Alternating/esp32-LED-sign/Progress.md

# Progress — LED Sign 10-Board Mesh

Tracking file per project rules. Newest log entries at top.

## Status
- **Phase:** Phase 1 + Phase 4 complete; all 10 boards on `c884749` (buildId `ce1fbe40`) = **release v0.4.0**, Rainbow Bands + Flow live. Docs: feature tour, hardware assembly guide, video. Backlog (not started): 11–20 boards, order/swap from phone, D2/D3 minor OTA items, `clients` over-count, optional BLE.
- **Active agent:** Orchestrator (Claude session 2026-11-08); research + planning agents on Standby
- **Blocker cleared:** `character_patterns.h` extended to 68 glyphs; ready for Phase 0.

## Log
- 2026-11-09 — **First release published: [v0.4.0](https://github.com/Alternating/esp32-LED-sign/releases/tag/v0.4.0)** (owner chose to keep 0.4.0 = the build already on all 10 boards, no reflash). Tag at `f8445db` (firmware/web identical to build `c884749`; later commits docs/tools only). Assets: HUB/NODE install, OTA image, SHA256SUMS, INSTALL.txt, zip — checksums identical to the deployed build and re-verified after download from GitHub. New `tools/release_pack.sh` (dry run by default; refuses on checksum, version/build-id, dirty build, firmware drift since build, unpushed HEAD, existing tag); notes in `docs/releases/v0.4.0.md`; release steps in `docs/HOWTO_build_pipeline.md`. Note: the cloud session cannot delete remote refs (proxy 403) — tag/branch deletes and releases go through the box (`gh`, ssh).
- 2026-11-09 — **Owner answers applied to hardware docs:** one **10 m** reel per board (400 LEDs = 6.7 m); STL v4 confirmed correct; the 4-button board is **no longer used** (removed from parts/wiring; README hub/flip steps now button-free — role via install image, Flip via phone); LOLIN32 is powered through its **JST battery connector** from the 5 V rail (polarity check + keep XL4015 at 5.0 V noted). New `docs/HOWTO_build_a_board.md` one-page checklist (build → flash → add to sign, incl. replacing a dead board: Forget first, since the hub assigns the lowest free position and a full table assigns none).
- 2026-11-09 — **Docs cleanup (owner request):** (1) Removed the scratch `phone-shots` branch from GitHub — it held the phone lock-screen shot (`home.jpg`) and test shots; `tools/phone_shot.sh` now keeps only the latest shot and documents how to delete the branch. None of those shots were on `main`. (2) Replaced the stale README "Next step" (Phase 0 / font tasks done long ago) with "Status and roadmap". (3) Ported the hardware build from `Alternating/8board-esp32-ledproject` into `docs/HARDWARE_ASSEMBLY.md`, adapted to one LOLIN32 + battery per board (GPIO 4 via 470 Ω, 10 000 µF, K1–K4 on 17/16/18/19), with 6 build photos in `docs/images/hardware/` and the Fusion source `hardware/battery_hanger_-_led_sign_v3.f3d` (v4 STL is byte-identical to the one already here). `HARDWARE_README_v3.md` marked legacy. (4) Font sheet and the two firmware screenshots now display properly in FEATURES. **Drift:** README "Next step" was never updated as phases closed — **framework fix:** every phase/feature close-out updates README "Status and roadmap" in the same commit as Progress.md.
- 2026-11-09 — **New feature: Rainbow Flow** (owner request) — the bands move, as one continuous pattern across the whole sign: Down, Up, Right (board 1→10), Left, Diagonal. Sign-wide x = (pos−1)·20 + col, phase from the hub clock; one pixel step every speed/5 ms (500 ms → full colour cycle in 2 s). `flow {"dir":…}` command, Show flags bits 4–6, SignState v5 (+flow; v3/v4 migrate, owner's Bands setting survived). Look tab: Flow row appears under the swatches when Bands is selected. Shipped `c884749` via phone upload (12.8 s) + UI Update all (9/9). Enabled Right from the phone: hub cfg bands=true flow=right. Owner confirmed static bands look good.
- 2026-11-09 — **New feature: rainbow bands inside the letters** (owner request; static, bands-in-glyphs chosen over full flag). Glyph pixels coloured by row red/orange/yellow/green/blue/purple; identical rows on every board so stripes run across 1–10. `color {"bands":true}`, `FLAG_BANDS` (0x08) in the Show header (frame unchanged), SignState v4 (bands in tail padding, v3→v4 migration), brightness cap 80 %, blink/fade still apply, exclusive with rainbow cycle. Look-tab swatch (striped). Shipped `b03240f` via phone upload (12.2 s) + UI "Update all boards" (9/9, 3 m 11 s); enabled from the phone: hub reports bands=true, briEff 80. Awaiting owner's visual confirmation. Cosmetic: colour bar under swatches keeps the last solid colour.
- 2026-11-09 — **First update done entirely the owner's way (phone):** board cards now show the symbol glyph (`char: ☺`, `5141255`). Phone upload 12.8 s → hub `eb9ca3f2` confirmed → **Update all boards tapped in the phone UI** → 9/9 nodes done in 3 m 9 s (19–26 s each), live progress table verified on screen. All 10 boards on `5141255` / `eb9ca3f2`.
- 2026-11-09 — **First phone-driven UI check via ADB (OnePlus, Chrome):** Message tab shows `{happy}`×10 as "10 / 10 boards", preview one group of 10 ☺; Boards tab lists all 10 online with fw `9834d06f`, HUB badge on pos 1, Identify/Flip per card; Settings → Firmware table shows pos 2–10 all up-to-date; `clients 1` with one phone (correct). Screenshots on branch `phone-shots` (home/ui1/boards/settings). Board-card glyph fixed in `5141255`.
- 2026-11-09 — **Android test rig online:** OnePlus 7 Pro (GM1917, Android 12) on the Qwen box via ADB (udev rule for vendor 22d9; phone joins `LEDSIGN-HUB` with `adb shell cmd wifi connect-network`). Screenshots: `tools/phone_shot.sh <name>` → `phone-shots` branch (force-pushed, never on main). Needs: phone unlocked once, Developer options → Stay awake + Disable permission monitoring (OnePlus) for taps/settings.
- 2026-11-09 — **D4 CLOSED — not a sign defect.** From the phone (72 Mbit/s link, −22 dBm): 1400 B pings 15 ms avg (box: 0.7–9.7 s), 300 kB sink POST 374 kB/s (box: 3.5 kB/s), real firmware upload 1.14 MB in **12.7 s** → hub rebooted to app1 and marked valid; `ota_nodes` skipped all 9 (up to date). Root cause was the box's ath10k card (rate control stuck at 1 Mbit/s TX, power-save on). Box-side uploads should go through the phone, or the box card needs fixing before using `ota_rollout.sh`.
- 2026-11-09 — **First full 10-board OTA rollout: 9/9 nodes updated in 3 min (19–24 s each), zero failures**; all 10 boards on `3a47849` (buildId `9834d06f`).
- 2026-11-09 — Owner defect: 10 × `{happy}` cut off at the 9th face. Cause: the 60-char limit counted raw bytes (`{happy}` = 7), and truncation split the 9th token into literal "HAP". Fix (`504aa3e`, `9a8f920`): limit is **60 display units** (a symbol = 1), raw text up to 200 B, `signClip()` never splits a token, SignState blob v3 with v2→v3 migration, serial JSON line 512 B. Host test `tools/seq_test/clip_test.cpp`. Verified on hardware: 10 faces = 10 units, one group, every board renders char 13.
- 2026-11-09 — Defect found during deploy: after a hub **reinstall** (table wiped) running nodes never re-HELLO, so they were invisible (no cards, no OTA). Fix `3a47849`: hub **adopts** a node from its heartbeat's saved position when that position is free. Verified: all 9 re-registered at their own positions within seconds of the hub install.
- 2026-11-09 — **Open D4 (hub upload over Wi-Fi is very slow with 10 boards):** box→hub uploads ran 2.5–6.5 kB/s (vs 85 kB/s on the 2-board bench) and the WebServer aborted them; 1400-byte pings to the hub took 0.7–9.7 s while small pings were 17 ms; hub→client downloads were fine (313 kB/s); a non-flash `/cmd` sink was equally slow, so it is the hub's receive path, not flash writes. The box's card had power-save on and fell to 1 Mbit/s TX — turning PS off helped only slightly. Workaround used: wired HUB install (the table now self-heals) + node OTA (fast direction). Next: reproduce with a phone upload (owner's real path); test with the sign idle vs sequencing; check ESP32 SoftAP RX buffers/AMPDU and the box/phone PHY rate. `tools/upload_probe.sh` captures upload + hub log.
- 2026-11-09 — Owner offered an Android phone for direct testing: feasible via ADB on the Qwen box (screenshots, taps, open the portal); pending owner setup.
- 2026-11-09 — **Phase 4 (hub-hosted OTA) VERIFIED — O1–O10 PASS after D1 fix.** min_spiffs (two 1.97 MB slots), built-in IDF rollback (`verifyRollbackLater()` override + mark-valid after 30 s healthy; one reset during the window rolls back — proven), hub serves its running image on :8080, node OTA ~24 s per board (10-board sign ≈ 4 min), mid-download power loss leaves the old firmware, truncated upload rejected, ESP-NOW status 36/36 while associated. D1 (hub forgot unicast peers after reboot → "Update all" failed right after a hub OTA) fixed in `e84e72b` and **deployed via OTA**: update-all ran immediately after the hub update, node done in 22 s. New `tools/ota_rollout.sh`. Reports `PHASE4_REVIEW.md`, `PHASE4_VERIFICATION.md`. Battery telemetry dropped from UI (owner decision). Remaining owner action: one wired install of the other 8 boards with `LED_Sign_NODE_install.bin` from `release/e84e72b/` (or newer), then OTA forever.
- 2026-11-08 — **10-board run succeeded** (owner photo: `GO ☺ TEAM ☺ GO` across 10 signs). One board (pos 5, MAC 78:E3:6D:19:09:B0) had its data line entering from the opposite side → mirrored "E". Fixed via the per-board mirror flag (serial `m`), then shipped the no-cable fix: `mirror` command + **Flip** button per board card, `SETMIRROR` unicast with ACK, K1-held-at-power-on gesture (`120f6ca`). Verified on hardware: hub→board 5 flip/unflip round-trip, saved in node NVS, `/state` carries `mirror` per board.
- 2026-11-08 — **Incident:** an unattended `flash_board.sh … update` on the hub ran while the owner was unplugging boards; esptool aborted mid-write and erased the hub's app partition (boot loop: `OTA app partition slot 0 is not bootable`). Bootloader + NVS were intact; recovered by flashing `LED_Sign_update_app.bin` at 0x10000 — role, 10-board table and message all survived. **Framework fix:** never start a flash without confirming the port exists *and* the owner knows the board must stay connected; `flash_board.sh` now refuses a missing port, picks the newest release by mtime (an alphabetical sort had chosen an older build), and fails loudly when the write isn't verified.
- 2026-11-08 — Release `release/120f6ca/` built (HUB/NODE install + update_app). Hub and board 5 are on it; the other 8 boards run `3eeb7ae`/`ccdc078`-era firmware (node behaviour identical) and can take `LED_Sign_update_app.bin` at 0x10000 at any time to gain the remote Flip.
- 2026-11-08 — Owner: hub must be clearly identifiable. Added labeled images via `tools/make_images.sh`: `LED_Sign_HUB_install.bin` / `LED_Sign_NODE_install.bin` (full images differing only in a pre-seeded NVS `sys/role`) + `LED_Sign_update_app.bin` (app-only, keeps settings). NODE image verified on hardware: boots `Role in NVS: NODE`, re-registers as pos 2. `flash_board.sh` now takes `hub|node|update`. README section "Which board is the hub?" + image table. Box can now push to GitHub (owner fixed auth). 10-board run done 2026-11-08.
- 2026-11-08 — **Phase 1 step 2 VERIFIED (C1–C13 PASS after D1 fix).** Word sequencer: legacy `parseMessageIntoWords` ported with chunking (23/23 host unit tests, `tools/seq_test`), synchronized word changes (300 ms lead, hub↔node switch skew 7.7 ms mean), SignState v1→v2 migration preserved owner settings, UI word-speed slider + live group preview (deterministic token glyphs). D1: period measured as period+lead (1312 ms) → fixed in `765c182`: 1000.0 ms σ 8, 500.1 ms σ 6.6. Build 1.08 MB. Reports: `STEP2_REVIEW.md`, `STEP2_VERIFICATION.md`.
- 2026-11-08 — Step 2 pipeline: Qwen draft 24.9k tok / 10 min (JS packer correct, C++ packer hung on brief cases, no scheduled apply) → review 32 findings → refactor (+ unit tests, hub-restart detection) → verification found one timing defect → fixed same day. **Phase 1 complete.**
- 2026-11-08 — Owner confirms captive portal auto-pops on phone join. **Step 3 fully closed.**
- 2026-11-08 — Owner phone test: two phones connect to `LEDSIGN-HUB` fine (D2 max_conn OK). Owner defect: identify flashed solid white; plan §3.3 says flash the **position digit**. Fixed (`display::identifyStart(ms,pos)`, white digit at 2 Hz on hub and nodes). Drift: the step-3 brief said "identify flash" without restating the digit requirement — briefs must quote the plan's rendering rules verbatim.
- 2026-11-08 — **Phase 1 step 3 VERIFIED (B1–B10 PASS, step-1 regression PASS).** Hub serves captive portal + web UI from PROGMEM (6.9 kB gz), JSON `/cmd` + `/state`, SignState persisted with 2 s auto-save, node-side effects (blink/fade/cycle phase-locked to hub clock), per-board telemetry. POST→node apply ≈ 76 ms; 60 s load + 5 min soak heap-flat. Defect D1 (unicast identify/forget lost 2/11) fixed in `49e4927` — 15/15 after fix. Reports: `docs/reviews/STEP3_REVIEW.md`, `STEP3_VERIFICATION.md`, UI screenshots `step3_ui_*.png`. Build 1.07 MB / 55 kB RAM.
- 2026-11-08 — Step 3 pipeline: Qwen draft 20.7k tok / 8 min (used an uninstalled async web lib, re-raised the AP on ch 1 — caught in review) → review 47 findings (19 blocking) → refactor (clean build, Playwright page test) → verification. Box facts: `wlp3s0` is the usable 2.4 GHz WLAN (`wlp4s0` is 60 GHz), no NetworkManager (wpa_supplicant+dhcpcd), the real sign's USB adapter needs `UploadSpeed=115200`.
- 2026-11-08 — **Phase 1 step 1 VERIFIED on hardware (A1–A7 all PASS).** `firmware/LED_Sign_Mesh/`: protocol, ESP-NOW radio layer (ring buffer → pump → handler, seq stamping, ACK retries, per-MAC dedupe), NVS storage, display, buttons, hub/node state machines with sticky MAC→position numbering, serial console. Evidence in `docs/reviews/STEP1_VERIFICATION.md`: node DISCOVER→pos 2 in 40 ms, SHOW_POSITION 3.0 s, LOST_HUB at 5.0 s / recovery 1.6 s, reset-order + claim cycle correct, 10-min soak Δheap 0 B both boards, 0 rx drops. Build 983 kB / 52 kB RAM.
- 2026-11-08 — Pipeline run: Qwen draft (9.6k tok, 223 s) → review agent (45 findings: 14 blocking/17 major/14 minor) → refactor agent (clean `--warnings all` build) → verification agent. Documented in `docs/HOWTO_build_pipeline.md`. Hub bench board swapped for a real sign: hub MAC now 9C:9C:1F:E3:CE:54 (node 78:E3:6D:19:18:38).
- 2026-11-08 — Phase 0 phone-on-AP gate passed: owner joined `LEDSIGN-BENCH`, loaded the hub page; 12.6 min run 3795/3791 = 0.1 % loss, RTT avg 6.2 ms (max 58 ms under phone traffic), heap stable. **Phase 0 radio gates all PASSED.** Open: flicker eyeball, 5 m range.
- 2026-11-08 — Repo pushed to GitHub (`Alternating/esp32-LED-sign`). Qwen box cloned at `~/esp32-led-sign` = primary build/flash station (two LOLIN32s on ttyUSB0/1). Windows folder `Code\esp32-LED-sign` is a clone. File shuttling retired; flow is commit/push → `git pull` on the box.
- 2026-11-08 — Local LLM (Ollama on the Qwen box) wired up as a tool via `tools/ask_local_llm.py`; 27b-q4 runs ~29 tok/s on the R9700. Usage rule in `tools/README.md`: drafts only, verify on hardware (its first answer contradicted a bench result).
- 2026-11-08 — **Phase 0 radio test PASSED** on two LOLIN32s (`firmware/bench/espnow_ping`): hub in AP_STA with SoftAP on ch 6 + ESP-NOW broadcast @ 5 Hz, node STA replying unicast. 248/248 pings, 0.0 % loss, RTT 3/6.5/25 ms, RSSI −33 dBm, heaps flat. Confirms the AP+ESP-NOW same-channel design and the core 3.3.12 ESP-NOW callback API (`wifi_tx_info_t`, `esp_now_recv_info_t`). Second board MAC 78:E3:6D:19:18:38. Remaining Phase 0 items: visual flicker check, phone-on-AP during ping, 5 m range.
- 2026-11-08 — **First hardware run.** Toolchain installed on the Qwen box (arduino-cli 1.5.1, esp32 core 3.3.12 / IDF 5.5.5, FastLED 3.10.9, ArduinoJson 7.4.3); LOLIN32 on /dev/ttyUSB0, MAC 9C:9C:1F:E3:C6:8C. `firmware/bench/font_test` compiled, flashed, verified over serial: 517 kB sketch, 296 kB free heap, `FastLED.show()` 13.7 ms/400 LEDs. New glyphs cycling on the matrix.
- 2026-11-08 — **Drift (Framework Improvement Trigger):** FastLED ≥ 3.10 on IDF 5.x has removed the RMT4 backend — `#define FASTLED_RMT5 0` is a hard `#error`. Plan §5.3's primary flicker mitigation is invalid. Replacement options: RMT5 default (test empirically in Phase 0), `FASTLED_ESP32_I2S`, or pin FastLED 3.9.x. Also: LOLIN32 FQBN has no `huge_app` partition — use `PartitionScheme=no_ota` (2.6 MB app). Fix: pin library versions at Phase 0 and verify every build flag on hardware before writing it into the plan.
- 2026-11-08 — GitHub repo `Alternating/esp32-LED-sign` created; local commits ready. Push blocked until the Claude GitHub App is granted access to the repo.
- 2026-11-08 — Font agent done. `firmware/legacy/character_patterns.h` extended 47 → 68 glyphs (adds `? ! " : & $ # + . , ' - / @ % ( ) =`, code 13 HAPPY, 14 SAD, 15 TEN). Originals byte-identical; one dead branch removed. Legacy sketches compile unchanged. Original kept as `character_patterns_v1_original.h`. Tools in `tools/fonts/`, previews + changelog in `docs/fonts/`. RAM 27.2 kB (PROGMEM deferred).
- 2026-11-08 — Owner feedback: board is **LOLIN32**; control via **Wi-Fi AP**, boards talk over **ESP-NOW**; BLE deferred (Phase 3 marked optional). Original `character_patterns.h` and `Led_standalone_lolin32.ino` added to `firmware/legacy/`. Font agent launched to audit the header and add `? ! " : & $ # +`, smiley/frown (codes 13/14) and a "10" glyph.
- 2026-11-08 — `docs/PROJECT_PLAN.md` written (architecture, boot/numbering state machines, ESP-NOW protocol, firmware layout, phased roadmap with acceptance tests, risks, open questions, framework notes). Awaiting owner review.
- 2026-11-08 — Research complete. Reports saved to `docs/research/`. **Drift detected:** ESP-NOW report recommends WiFi-AP web UI first (hub ESP-NOW RX unstable alongside BLE; no Web Bluetooth on iOS); mobile report recommends BLE + Web Bluetooth PWA first. Escalated to planning agent; resolved in PROJECT_PLAN.md §2.4 / §10 (Framework Improvement Trigger).
- 2026-11-08 — Repo scaffolded. Legacy single-board firmware (v4 4-button) and WiFi web-UI firmware copied to `firmware/legacy/`. Hardware docs (battery, XL4015, capacitor, mount STL) copied to `docs/` and `hardware/`.

## Decisions (proposed — confirm or override)
1. **CONFIRMED** — phone link = hub SoftAP + web page (port of Symbol Edition UI). Board-to-board = ESP-NOW. BLE not used; kept only as optional future transport behind `transport.h`.
2. Hub/node role = NVS flag toggled by holding K4 at power-on (shows H/N). No auto-election.
3. Positions sticky by MAC in hub NVS; hub K3 long-press = RESET ORDER, then re-power boards in desired order.
4. One 40-byte `Show` broadcast carries full display state; repeated at 2 Hz as heartbeat + clock.
5. Raw `esp_now.h`, FastLED 3.10.9 on RMT5 (RMT4 no longer exists — see drift log), ArduinoJson 7.4.3, `no_ota` partition, Arduino-ESP32 core **3.3.12** pinned. Fixed ESP-NOW channel 6.
6. Battery sense: 100k/47k divider → GPIO 34, per-board calibration via app.

## Open Questions (for Tyler)
0. ~~Phone checklist~~ **Done:** captive portal auto-pops on join, two phones connect, identify shows digits. Step 3 fully closed. UI feedback welcome anytime.
1. Hub = display board at position 1, or a dedicated controller box?
2. ~~Dev board~~ **LOLIN32** (answered)
3. Do all boards have the 4-button board, and are some wired mirrored/backwards?
4. Primary phone: iPhone or Android?
5. Positions sticky across events, or re-numbered by power-on order every time?
6. ~~AP control OK?~~ **Yes** (answered)
7. ~~character_patterns.h~~ **Added; being extended** (answered)
8. Word-group sequencing only, or also scrolling text across boards?

## Framework Improvement Notes
- Pipeline lesson (step 1): the local LLM draft compiled 0/15 files clean and had 14 blocking logic gaps, yet gave the review/refactor agents a complete skeleton with the right file layout and protocol structs — net positive, but never skip the review stage. Verification anomalies to fold into step 2: node `s` should print the rendered char; log hub same-pos re-ASSIGN suppression and node ACKs.
See `docs/PROJECT_PLAN.md` §10 — 13 drift items logged with protocol fixes. Key fix: future research briefs must include a "Conflicts with sibling report" section and name decision criteria up front.
