Alternating/esp32-LED-sign/docs/LIFEPO4_PERFECT_SOLUTION.md

# ⚡ Perfect Battery Solution: 6V 6Ah LiFePO4 + XL4015

## Why This Battery is PERFECT for Your LED Sign

You found a **6V 6Ah LiFePO4 battery** with built-in BMS and USB charging. This is actually **better than both** the lead acid and Li-ion 21700 options!

---

## 🏆 Comparison: Your LiFePO4 vs Other Options

| Feature | **6V LiFePO4 (Your Choice)** | 6V Lead Acid | Li-ion 2S2P |
|---|---|---|---|
| **Voltage** | 6V ✓ | 6V ✓ | 7.2V |
| **Capacity** | 6Ah ✓ | 5Ah | 5Ah |
| **Energy** | **36Wh** ✓ | 30Wh | 36Wh |
| **Weight** | **0.7 lbs** ✓ | 2.2 lbs | 0.8 lbs |
| **BMS** | **Built-in** ✓ | N/A | Separate ($12) |
| **Charging** | **USB** ✓ | Need charger | Need charger |
| **Cycle Life** | **2000+** ✓ | 200-300 | 500-1000 |
| **Safety** | **Very Safe** ✓ | Very Safe | Requires care |
| **Assembly** | **Plug & Play** ✓ | Simple | Complex |
| **Price (1x)** | **$12** ✓ | $20 | $28 (cells only) |
| **Total Cost** | **$12** ✓ | $32 (w/charger) | $88 (w/BMS+charger) |

**Winner: Your LiFePO4 battery beats both options in almost every category!**

---

## Key Advantages of LiFePO4

### 1. **Chemistry: LiFePO4 vs Li-ion**

**LiFePO4 (Lithium Iron Phosphate):**
- ✅ Extremely safe (won't catch fire)
- ✅ Stable voltage curve
- ✅ Works well at high/low temperatures
- ✅ 2000+ charge cycles
- ✅ No memory effect
- ✅ Environmentally friendly

**Li-ion (like LG M50):**
- ⚠️ Can catch fire if damaged
- ⚠️ Requires careful handling
- ⚠️ Temperature sensitive
- ✓ Higher energy density (but not needed here)

**Lead Acid:**
- ✓ Safe
- ❌ Heavy
- ❌ Only 200-300 cycles
- ❌ Voltage sag under load

### 2. **Built-in BMS = Major Advantage**

Your battery already includes:
- ✅ Overcharge protection
- ✅ Over-discharge protection
- ✅ Overcurrent protection
- ✅ Short circuit protection
- ✅ Cell balancing (if multi-cell)

**You save:** $12-15 (cost of separate BMS)

### 3. **USB Charging = Super Convenient**

**No special charger needed!**
- Just use any USB power adapter
- 5V USB → Battery charges internally
- LED indicator shows charging status
- Can charge from:
  - Phone charger (2A = slow)
  - iPad charger (2.4A = medium)
  - Fast charger (3A = faster)
  - Power bank (portable charging!)
  - Computer USB port (slow but works)

**Charge time:**
```
6000mAh ÷ 1A = 6 hours (phone charger)
6000mAh ÷ 2A = 3 hours (fast charger)
```

### 4. **Weight: 3× Lighter!**

```
Lead Acid:  2.2 lbs per battery
LiFePO4:    0.7 lbs per battery
Savings:    1.5 lbs per battery

For 2 batteries:
Lead Acid:  4.4 lbs
LiFePO4:    1.4 lbs
Savings:    3.0 lbs (68% lighter!)
```

**Perfect for portable sign applications!**

---

## Runtime Calculations

### Your Battery Specs
- Voltage: 6V nominal (6.4V charged, 5V empty for LiFePO4)
- Capacity: 6Ah
- Energy: 36Wh (20% more than 5Ah lead acid!)

### Runtime with XL4015 (96% efficient)

**Single Board (5A @ 5V = 25W):**
```
Available Energy: 36Wh × 96% = 34.6Wh
Runtime: 34.6Wh ÷ 25W = 1.38 hours
Result: 83 minutes ✓
```

**Two Boards (10A @ 5V = 50W):**
```
Runtime: 34.6Wh ÷ 50W = 0.69 hours
Result: 41 minutes ✓
```

**Four Boards (20A @ 5V = 100W):**
```
Runtime: 34.6Wh ÷ 100W = 0.35 hours
Result: 21 minutes
Note: Need multiple batteries in parallel
```

### Runtime Comparison

| Configuration | Lead Acid 5Ah | **LiFePO4 6Ah** | Improvement |
|---|---|---|---|
| 1 Board | 55 min | **83 min** | **+51%** ✓ |
| 2 Boards | 27 min | **41 min** | **+52%** ✓ |
| 4 Boards | 14 min | **21 min** | **+50%** ✓ |

**You get 50% more runtime at 1/3 the weight!**

---

## Perfect Setup with XL4015

### Configuration 1: Single Board (Simplest)

```
┌─────────────────────────┐
│  LiFePO4 Battery        │
│  6V 6Ah                 │
│  Built-in BMS           │
│                         │
│  [F1 Terminal +]        │
│       │                 │
│       └─────────────────┼──────────┐
│                         │          │
│  [F1 Terminal -]        │          │
│       │                 │          │
└───────┼─────────────────┘          │
        │                            │
        │                            │
        │      ┌──────────────┐      │
        └──────┤ IN-  XL4015  │      │
               │              │      │
        ┌──────┤ IN+          │      │
        │      │              │      │
        │      │ OUT+ (5.0V)  ├──────┼────→ LED Board VCC
        │      │              │      │
        │      │ OUT-         ├──────┼────→ LED Board GND
        │      └──────────────┘      │
        │                            │
        └────────────────────────────┼────→ ESP32 GND
                                     │
                All GND Common ←─────┘

Runtime: 83 minutes
Weight: 0.7 lbs
Cost: $12 (battery) + $4 (XL4015) = $16 total!
```

---

### Configuration 2: Two Boards (Recommended)

```
┌──────────────┐
│  LiFePO4     │
│  6V 6Ah      │
│              │
│  +  Terminal │
│  │           │
│  └───┬───────┼─────────────┐
│      │       │             │
│  -   │       │             │
│  │   │       │             │
└──┼───┘       │             │
   │           │             │
   │      ┌────┴────┐   ┌────┴────┐
   │      │ XL4015  │   │ XL4015  │
   │      │   #1    │   │   #2    │
   │      │         │   │         │
   │ OUT+ ├─────────┼───┼──────→ Board 1 VCC
   │      │         │   │
   │ OUT- ├──┐      │   │ OUT+  ├──→ Board 2 VCC
   │      │  │      │   │       │
   └──────┘  │      │   │ OUT-  ├──┐
             │      │   │       │  │
             └──────┼───┴───────┼──┼→ All GND
                    │           │  │
                    └───────────┴──┘

Runtime: 41 minutes (2 boards)
Weight: 0.7 lbs
Cost: $12 (battery) + $4 (2× XL4015) = $16
```

---

### Configuration 3: Extended Runtime (2 Batteries Parallel)

```
┌──────────┐    ┌──────────┐
│ LiFePO4  │    │ LiFePO4  │
│ Battery  │    │ Battery  │
│ #1       │    │ #2       │
│ 6V 6Ah   │    │ 6V 6Ah   │
└─┬──────┬─┘    └─┬──────┬─┘
  │+     │-       │+     │-
  │      │        │      │
  │      └────┬───┘      │
  │           │          │
  └───────┬───┴──────────┘
          │
          ├──→ XL4015 Input
          │    Still 6V, but now 12Ah capacity!
          │
          └──→ 72Wh total energy

Runtime (1 board):  166 minutes (2.75 hours)
Runtime (2 boards): 83 minutes (1.4 hours)
Weight: 1.4 lbs (still light!)
Cost: $24 (2 batteries) + $4 (XL4015) = $28
```

---

## Wiring Details

### Terminal Connections

**Your battery has F1 terminals (blade terminals):**
```
F1 Terminal = 0.187" (4.75mm) blade

Compatible connectors:
- Male blade connectors (0.187")
- Female blade terminals
- Ring terminals with adapter
- Pre-made F1 cables
```

**Recommended:** Use F1 female blade connectors with wire
- 16 AWG or 18 AWG wire
- Crimp or solder blade connectors
- Add heat shrink for insulation

### XL4015 Connections

**Input side (battery):**
```
Battery (+) → XL4015 IN+
Battery (-) → XL4015 IN-
```

**Output side (LEDs):**
```
XL4015 OUT+ → LED Board VCC
XL4015 OUT- → LED Board GND
           → ESP32 GND (CRITICAL: common ground!)
```

---

## Setup Procedure

### Step 1: Charge Battery Fully

1. Use any USB power adapter (2A recommended)
2. Plug USB cable into battery charging port
3. Red LED = Charging
4. Green LED = Fully charged
5. Takes ~3-6 hours depending on adapter

**Check voltage:** Should be ~6.4V when fully charged

---

### Step 2: Set XL4015 to 5.0V

**IMPORTANT: Do this BEFORE connecting LEDs!**

1. Connect battery to XL4015 input
2. Do NOT connect LEDs yet
3. Use multimeter on OUT+ and OUT-
4. Adjust voltage potentiometer (clockwise = higher)
5. Set to exactly **5.0V** (±0.05V)
6. Mark setting with paint pen

---

### Step 3: Wire Everything

**Materials needed:**
- Battery (charged)
- XL4015 (set to 5V)
- Wire (16-18 AWG)
- F1 blade connectors
- Heat shrink tubing
- Multimeter

**Wiring order:**
1. Battery (+) to XL4015 IN+
2. Battery (-) to XL4015 IN-
3. XL4015 OUT+ to LED VCC
4. XL4015 OUT- to LED GND
5. XL4015 OUT- to ESP32 GND

**Double-check:**
- Output voltage still 5.0V
- No short circuits
- All connections tight
- Common ground verified

---

### Step 4: Power On Test

**Startup sequence:**
1. Set LED brightness to 25%
2. Connect battery to XL4015
3. ESP32 should boot normally
4. LEDs should light up properly
5. Check voltage: Should stay 4.95-5.05V
6. Feel XL4015: Should be warm, not hot

**If problems:**
- Voltage too low → Check battery charge
- LEDs flickering → Check ground connections
- XL4015 hot → Reduce current or add heatsink
- ESP32 won't boot → Verify GND connection

---

## Charging Guide

### USB Charging (Built-in)

**Advantages:**
- Super convenient
- No special charger needed
- LED indicator
- Overcharge protection built-in

**How to charge:**
1. Disconnect from LED sign (or use on/off switch)
2. Plug USB cable into battery
3. Connect to USB power adapter
4. Red LED = Charging
5. Green LED = Done

**Charger recommendations:**
- **Fast:** iPad charger (2.4A) = 3 hours
- **Standard:** Phone charger (1A) = 6 hours
- **Slow:** Computer USB (0.5A) = 12 hours

**Can charge while using?**
- Depends on model
- Some support "pass-through" charging
- Check if LED dims when charging + using

---

### Charge Time Calculations

```
Battery Capacity: 6000mAh

With 1A charger:  6000mAh ÷ 1A = 6 hours
With 2A charger:  6000mAh ÷ 2A = 3 hours
With 3A charger:  6000mAh ÷ 3A = 2 hours

Add 20% for CC/CV phase: 
1A = 7.2 hours
2A = 3.6 hours
3A = 2.4 hours
```

---

## Battery Care & Maintenance

### Daily Use

**Before use:**
- Check LED indicator (should be green = full)
- Verify voltage (should be 6.0-6.4V)
- Feel temperature (should be cool)

**During use:**
- Monitor runtime
- Check voltage periodically
- If output drops, recharge soon

**After use:**
- Recharge within 24 hours
- Don't store depleted
- Keep in cool, dry place

---

### Storage

**Short-term (days to weeks):**
- Store fully charged
- Cool, dry location
- Check monthly, top up if needed

**Long-term (months):**
- Store at 50-60% charge
- Check every 3 months
- Recharge to 60% if below 40%

**Temperature:**
- Best: 15-25°C (59-77°F)
- OK: 0-35°C (32-95°F)
- Avoid: Below freezing or above 40°C

---

### Cycle Life Optimization

**To get 2000+ cycles:**
- ✓ Recharge after each use
- ✓ Avoid full discharge (<5V)
- ✓ Keep cool during use
- ✓ Use proper voltage (5V output)
- ✓ Don't overload (stay <6A)

**Avoid:**
- ❌ Leaving discharged for weeks
- ❌ Charging in hot environment
- ❌ Physical damage or drops
- ❌ Short circuits

---

## Performance Monitoring

### Battery Voltage Chart (LiFePO4)

```
6.4V = 100% (fully charged)
6.3V = 90%
6.2V = 70%
6.1V = 50%
6.0V = 30%
5.8V = 10%
5.5V = 5%
5.0V = Empty (stop using!)
```

**When to recharge:**
- Best: Above 6.0V (30% remaining)
- OK: At 5.8V (10% remaining)
- Don't go below: 5.5V (battery protection)

---

### Runtime Tracking

**Expected runtimes (from full charge):**

| Boards | Current | Runtime | Stop Voltage |
|---|---|---|---|
| 1 | 5A | 83 min | 5.8V |
| 2 | 10A | 41 min | 5.8V |
| 3 | 15A | 27 min | 5.8V |
| 4 | 20A | 21 min | 5.8V |

**If runtime is shorter:**
- Battery may be aging (normal after 1000+ cycles)
- Check actual current draw
- Verify XL4015 efficiency
- Check for poor connections

---

## Safety Features

### Built-in BMS Protection

Your battery includes:

1. **Overcharge Protection**
   - Stops charging at 7.2V
   - Prevents damage
   - Automatic

2. **Over-discharge Protection**
   - Cuts off at ~5.0V
   - Protects cells
   - Automatic recovery

3. **Overcurrent Protection**
   - Limits to ~6-10A (varies by model)
   - Prevents overload
   - Resets when current drops

4. **Short Circuit Protection**
   - Instant cutoff
   - Protects battery and load
   - May require reset

5. **Temperature Protection**
   - Shuts down if too hot (>60°C)
   - Prevents thermal damage

---

### What BMS Does NOT Protect Against

**You still need to:**
- ⚠️ Avoid physical damage (puncture, crush)
- ⚠️ Keep away from water
- ⚠️ Don't expose to extreme heat (>60°C)
- ⚠️ Don't reverse polarity
- ⚠️ Use proper voltage converter

**The BMS protects the battery, but YOU protect the system!**

---

## Cost Analysis: Total System Cost

### Single Board Setup

```
☐ 1× LiFePO4 6V 6Ah battery      $12
☐ 1× XL4015 converter (from pack) $4
☐ Wire, F1 connectors             $5
☐ USB charger (you probably have) $0
──────────────────────────────────────
Total: $21

Compare to:
- Lead acid setup: $32
- Li-ion 2S2P: $88
Savings: $11 vs lead acid, $67 vs Li-ion!
```

---

### Two Board Setup

```
☐ 2× LiFePO4 6V 6Ah batteries    $24
☐ 2× XL4015 converters (from pack) $8
☐ Wire, F1 connectors             $8
──────────────────────────────────────
Total: $40

Compare to:
- Lead acid (2×): $60
- Li-ion 2S4P: $140
Savings: $20 vs lead acid, $100 vs Li-ion!
```

---

### Value Over Time (2000 cycles)

**Cost per cycle:**
```
LiFePO4: $12 ÷ 2000 = $0.006/cycle
Lead Acid: $20 ÷ 300 = $0.067/cycle
Li-ion Build: $88 ÷ 1000 = $0.088/cycle

After 300 uses:
LiFePO4: $12 (same battery)
Lead Acid: $20 (need replacement)
After 1000 uses:
LiFePO4: $12 (same battery)
Lead Acid: $67 (4 replacements)
Li-ion: $88 (need replacement)
After 2000 uses:
LiFePO4: $12 (same battery)
Lead Acid: $133 (7 replacements!)
```

**LiFePO4 pays for itself in just 2 months of daily use!**

---

## Upgrades & Accessories

### Recommended Additions

**1. On/Off Switch ($5)**
- In-line rocker switch
- 10A rating minimum
- Between battery and XL4015
- Easier than disconnecting terminals

**2. Voltage Monitor ($8-12)**
- LED voltage display
- Shows battery level
- Helps prevent over-discharge
- Mount on sign enclosure

**3. Fuse or Circuit Breaker ($3-5)**
- 10A fuse inline
- Protects against shorts
- Between battery and XL4015
- Safety backup to BMS

**4. Spare Battery ($12)**
- For extended events
- Swap when depleted
- Double runtime
- Charge while using other

**5. XT60 or Anderson Connectors ($5)**
- Quick disconnect
- Better than F1 terminals for frequent changes
- Add to battery terminals
- Professional appearance

---

## Troubleshooting

### Battery Won't Charge

**Symptoms:** USB LED doesn't light
**Possible causes:**
- USB cable bad → Try different cable
- Charger not working → Try different adapter
- Battery over-discharged → May need special recovery
- BMS locked → Disconnect, wait 10 min, reconnect

---

### Short Runtime

**Symptoms:** Battery dies in <50% expected time
**Possible causes:**
- Battery not fully charged → Charge longer
- High current draw → Measure actual current
- Battery aging → Normal after 1000+ cycles
- XL4015 inefficient → Check output voltage
- Cold temperature → Battery capacity reduces in cold

---

### LEDs Dim or Flicker

**Symptoms:** LEDs not full brightness, flickering
**Possible causes:**
- Battery depleted → Check voltage (<6V)
- XL4015 output low → Re-adjust to 5.0V
- Poor connections → Tighten all terminals
- Ground not common → Verify ESP32 GND to LED GND

---

### XL4015 Getting Hot

**Symptoms:** Converter too hot to touch (>60°C)
**Possible causes:**
- Current too high → Check actual draw
- Insufficient airflow → Add ventilation
- Input voltage wrong → Verify battery voltage

**Solutions:**
- Add heatsink ($2-3)
- Use separate converter per board
- Reduce brightness temporarily
- Improve airflow

---

## Real-World Use Cases

### Use Case 1: Portable Party Sign (1 board, 2 hours)
**Setup:**
- 2× LiFePO4 batteries in parallel
- 1× XL4015
- Runtime: 166 minutes ✓
- Weight: 1.4 lbs (easy to carry)
- Cost: $28 total

---

### Use Case 2: Quick Demo (1 board, 1 hour)
**Setup:**
- 1× LiFePO4 battery
- 1× XL4015
- Runtime: 83 minutes ✓
- Weight: 0.7 lbs (ultra portable)
- Cost: $16 total

---

### Use Case 3: Two-Board Display (1 hour)
**Setup:**
- 2× LiFePO4 batteries in parallel
- 2× XL4015
- Runtime: 83 minutes ✓
- Weight: 1.4 lbs
- Cost: $32 total

---

### Use Case 4: All-Day Event (rotating signs)
**Setup:**
- 4× LiFePO4 batteries (2 pairs)
- 2× XL4015
- Use 2 batteries, charge 2 batteries
- Swap every 80 minutes
- Indefinite runtime!
- Cost: $56 total

---

## Product Links & Alternatives

### Your Battery (2-pack for $24)
- **Product:** 6V 6Ah LiFePO4 with USB charge
- **Price:** $23.99 ($12 each)
- **Rating:** 4.4 stars (89 reviews)
- **Amazon:** TOPUSSE Store
- **Features:** Built-in BMS, USB charging, F1 terminals
- **Weight:** 1.4 lbs for 2-pack

---

### Similar Alternatives

**Option A: Single pack ($14-16)**
- Same specs, 1 battery
- If you only need one
- Test before buying more

**Option B: Higher capacity 10Ah ($20)**
- 6V 10Ah LiFePO4
- 60Wh vs 36Wh
- 2.5× runtime of lead acid
- Heavier: ~1.2 lbs

**Option C: 12V version ($20)**
- 12V 6Ah LiFePO4
- Need different buck converter settings
- More voltage headroom
- Can use for future 12V projects

---

## Final Recommendation

### ✅ YOUR BATTERY + XL4015 = PERFECT COMBO

**Why this is the best solution:**

1. **Lowest cost:** $16 for complete working system
2. **Lightest:** 0.7 lbs (3× lighter than lead acid)
3. **Longest life:** 2000+ cycles (10× more than lead acid)
4. **Safest:** LiFePO4 chemistry + built-in BMS
5. **Most convenient:** USB charging (no special charger)
6. **Best runtime per weight:** 83 min @ 0.7 lbs
7. **Plug & play:** No assembly required
8. **Expandable:** Easy to add more batteries
9. **Professional:** Clean, integrated solution
10. **Proven:** 89 reviews, 4.4 stars

**You absolutely made the right choice!**

---

## Shopping List (Complete System)

### For Single Board

```
☑ 1× LiFePO4 6V 6Ah battery       $14 (or 2-pack $24)
☑ 1× XL4015 3-pack converters     $12 (use 1, keep 2 spare)
☐ F1 female blade connectors      $3 (10-pack)
☐ 16 AWG wire (red/black)         $5 (25 ft)
☐ Heat shrink tubing kit          $5
☐ Optional: On/off switch         $3
☐ Optional: Voltage meter         $8
───────────────────────────────────────────
Total: $34 (with all optionals: $45)
```

**What you already have:**
- USB charger (phone charger works!)
- ESP32
- LED board(s)

---

### For Two Boards (Extended Runtime)

```
☑ 1× LiFePO4 2-pack (6V 6Ah each)  $24
☑ 1× XL4015 3-pack converters      $12 (use 2)
☐ F1 connectors, wire, etc.        $10
───────────────────────────────────────────
Total: $46

Runtime: 83 minutes @ 2 boards
Or: 166 minutes @ 1 board
```

---

## Next Steps

1. **Order your 2-pack** ($24) - you already found it!
2. **Get XL4015 converter** (3-pack $12)
3. **Charge batteries** via USB
4. **Set XL4015** to exactly 5.0V
5. **Wire everything** following diagrams
6. **Test** starting at low brightness
7. **Enjoy** 83+ minutes of runtime!

---

## Questions Answered

**Q: Is this safe?**
A: YES! LiFePO4 is one of the safest lithium chemistries. Built-in BMS adds more protection. Much safer than DIY Li-ion.

**Q: Will this work with my XL4015?**
A: YES! Battery is 6V, XL4015 works 4-38V. Perfect match.

**Q: Do I need anything else?**
A: Just wire and connectors. You can use USB charger you already have.

**Q: How long will it last?**
A: 2000+ charge cycles = 5+ years of daily use!

**Q: Can I add more batteries later?**
A: YES! Just connect in parallel for double runtime.

---

**Bottom Line:** You found the PERFECT battery. It's lighter than lead acid, safer than Li-ion, cheaper than both, has USB charging, built-in BMS, and will last 2000+ cycles. 

**Order that 2-pack now!** At $12/battery, it's an absolute steal. 🎉
