Alternating/esp32-LED-sign/docs/reviews/PHASE4_REVIEW.md

# Review — Phase 4 draft (hub-hosted OTA, Qwen draft 1)

Reviewed against: `docs/build-briefs/PHASE4_OTA_hub_hosted_updates.md` (Core design, scope items 1–10, acceptance O1–O10), `docs/PROJECT_PLAN.md` §2.3/§7, the verified baseline in `firmware/LED_Sign_Mesh/` (commit `b7ea985`; `STEP{1,3,2}_VERIFICATION.md`), the established concurrency pattern (`STEP3_REVIEW.md` "Refactor disposition", `STEP2_REVIEW.md`: core-0 handlers write pending copies under a portMUX, core 1 applies; `FastLED.show()` only in `loop()`; `esp_now_send` only from `radio::pump()`). Draft read from the Qwen box at `~/esp32-led-sign/drafts/ota_qwen_v1/`; compile log `build1.log` (19 errors, `PartitionScheme=min_spiffs`).

Toolchain facts checked on the box (core 3.3.12 / IDF 5.5.5):

- **`CONFIG_BOOTLOADER_APP_ROLLBACK_ENABLE=y`** and `CONFIG_APP_ROLLBACK_ENABLE=y` in `~/.arduino15/packages/esp32/tools/esp32-libs/3.3.12/sdkconfig` (lines 286, 3484; `ANTI_ROLLBACK` not set). The sdkconfig is **not** at `tools/sdk/esp32/sdkconfig` in core 3.x. So IDF rollback is available — **but** the Arduino core *auto-confirms* a pending image during `initArduino()`: `cores/esp32/esp32-hal-misc.c:319-333` calls `esp_ota_mark_app_valid_cancel_rollback()` on `ESP_OTA_IMG_PENDING_VERIFY` unless the weak C hook **`bool verifyRollbackLater()`** (line 290) returns `true`. Our sketch must define `extern "C" bool verifyRollbackLater() { return true; }` and confirm later itself (§R5). Without that override the 30 s health window is a no-op. IDF semantics: the bootloader rolls back after **one** unconfirmed boot (PENDING_VERIFY → ABORTED on the next reset), not after three; a power cycle inside the 30 s window also rolls back. O7 must be reworded accordingly.
- `min_spiffs.csv`: `app0` 0x10000 / **0x1E0000 (1 966 080 B)**, `app1` 0x1F0000 / 0x1E0000, `spiffs` 0x3D0000 / 0x20000, `coredump` 0x3F0000. The step-3 app was 1 072 659 B (`no_ota`); +OTA/HTTPClient/Update code lands around 1.15 MB — fits with ~0.8 MB headroom. `boot_app0.bin` (otadata) still goes at 0xE000 in the merged image.
- Available and verified in headers: `WebServer::on(uri, method, fn, ufn)` + `upload()` → `HTTPUpload{status,buf,currentSize,totalSize}`; `NetworkServer::accept()` (`available()` is deprecated → warning, violates O1); `Update.begin(size|UPDATE_SIZE_UNKNOWN)`, `write`, `writeStream`, `end(true)`, `abort`, `progress()`, `errorString()`, `canRollBack/rollBack`; `HTTPClient::begin(NetworkClient&, String url)`, `GET()`, `getSize()`, `getStreamPtr()`, `setTimeout(uint16_t)`, `setConnectTimeout`, `setReuse(bool)` (no `setReuseConnection`); `esp_image_verify(ESP_IMAGE_VERIFY_SILENT, &pos, &meta)` → `meta.image_len` (bootloader_support, linked into apps); `esp_app_get_description()->app_elf_sha256`; `WiFi.softAPmacAddress(uint8_t*)`.

What the draft changed vs the baseline (by `diff`): **new** `ota.h/.cpp`, `build_id.h`; **modified** `config.h` (+7), `protocol.h` (PROTO_VER 2, buildId in Hello/Hb, OtaEnter/OtaStatus), `hub.h` (no change despite the diff list), `node.h` (+OTA state), `hub.cpp` (+buildId plumbing, two switch cases, `hubBuildOtaState` call), `node.cpp` (+OTA_ENTER case, tick/render dispatch), `commands.cpp` (+3 commands), `transport_web.cpp` (+/ota, /ota_status, fw server task), `LED_Sign_Mesh.ino` (comment + include only), `radio_espnow.cpp` (max_conn), `make_images.sh` (FQBN comment, build_id.h), `web_page.h` (regenerated from the 177-line sketch, must not be used). `index_draft.html` is a from-scratch rewrite of the page (ES2017, `innerHTML` with template literals, no tabs, no symbol keypad, no debounce) — treat as a sketch of the Firmware section only.

## Verdict

**NOT MERGEABLE — 26 blocking, 14 major, 6 minor. The draft is a skeleton: it does not compile (19 errors + 2 warnings, and more hidden behind them), and once it did, no node could ever be updated: `OTA_ENTER` is 88 B and `radio::send()` refuses anything over `MAX_FRAME` (64), `ota_nodes` queues nothing (it compares the hub's buildId with itself), the fw server streams raw flash with no HTTP response line to a client that speaks HTTP, the node's download loop misreads `WiFiClient::read()`'s `-1` as 4 GB of data, and the node blocks the core-0 radio pump for up to 5 s inside `handlePacket()`. Rollback is a pair of NVS helpers nobody calls, with no `verifyRollbackLater()` override, so the Arduino core confirms every new image at boot. Nothing in `hub::tick()` drives the queue, so the 120 s timeout can only fire when a packet happens to arrive.**

Also a hard regression: `PROTO_VER` was bumped to 2 but `radio_espnow.cpp:68` still drops any frame whose `ver != PROTO_VER`, so the "v1 tolerance" the brief asks for is impossible at the layer the draft left untouched, and a v2 hub and v1 node are mutually deaf.

The good parts, to keep: the protocol struct layouts (`OtaEnter`, `OtaStatus`, `buildId[4]` appended to `Hello`/`Hb`), the `BoardInfo.buildId` plumbing in hub.cpp (HELLO + HB under `tMux`, status line), the `commands.cpp` additions (shape and arg checking match the house style), `MAX_CONN` into the single `softAP` call, the hub-side `/ota_status` JSON fallback handler (useful for O10), the queue record shape (`mac,pos,state,pct,startedAt,failMsg`), the `pct % 5` reporting intent, and the Firmware-section HTML fragment in `index_draft.html` (file input, upload button, progress div, queue list, `fw-badge.bad`).

## Findings

Severity: **blocking** = will not compile, regresses verified behaviour, or defeats O1–O6 outright; **major** = a scope item or O7–O10 fails; **minor** = quality/robustness. Line numbers are the draft's.

### A. Compile blockers (O1)

| ID | Sev | File:line | Problem | Required fix |
|---|---|---|---|---|
| O4-01 | blocking | config.h | `FW_VERSION_STR` is not defined (scope item 1) yet `ota.cpp:30` returns it. `OTA_PORT`/`OTA_NODE_TIMEOUT_MS`/`OTA_VERIFY_MS` are present. | `#define FW_VERSION_STR "0.4.0"` next to `FW_VERSION`. Also `#include "build_id.h"` from **ota.cpp only** with a fallback: `#if __has_include("build_id.h") #include "build_id.h" #else #define BUILD_GIT "dev" #endif` so an IDE build without `make_images.sh` still compiles (`build_id.h` is gitignored). |
| O4-02 | blocking | ota.h:5-7, 24; ota.cpp:190 | `JsonObject` used without `#include <ArduinoJson.h>` (3 errors in node.cpp/ota.cpp TUs). | Include `<ArduinoJson.h>` in ota.h — or better, drop `hubBuildOtaState` from ota.h entirely (the queue moves into hub.cpp, §R3) so ota.h stays JSON-free. |
| O4-03 | blocking | transport_web.cpp:118-129, 190 | `Update`, `UPDATE_SIZE_UNKNOWN`, `esp_ota_get_running_partition`, `esp_partition_t` undeclared: missing `#include <Update.h>`, `<esp_ota_ops.h>`, `<esp_partition.h>`. | Add the includes — or move the fw server and the upload hooks into ota.cpp (§R1/§R4) so transport_web.cpp only registers routes and calls `ota::`. |
| O4-04 | blocking | ota.cpp:83 | `WiFi.softAPPassword()` does not exist. | Use `AP_PASS` from config.h (the only password the AP is ever started with, `radio::beginHub`). |
| O4-05 | blocking | ota.cpp:231 | `INADDR(m->ip)` is invented. | `IPAddress(m->ip).toString()` — or skip the string entirely: `http.begin(client, IPAddress(m->ip).toString(), m->port, "/fw.bin")`. |
| O4-06 | blocking | ota.cpp:234 | `HTTPClient::setReuseConnection` does not exist. | `setReuse(false)`. |
| O4-07 | blocking | ota.cpp:310 | `Update.getWrittenBytes()` does not exist. | `Update.progress()` (bytes written so far) / `Update.isFinished()`. |
| O4-08 | blocking | ota.cpp:349-350 | `display::setPixel()` does not exist (display.h exposes `leds[]`, `ledIndex(row,col,mirror)`, `renderDigit`, `clear`, `fill`). | `display::leds[display::ledIndex(row, col, display::mirror)] = c;` — see §R2 for the render. |
| O4-09 | blocking | ota.h:35 vs ota.cpp:370 | `shouldRollback()` declared extern in the header, defined `static`. | Pick one; it goes away with §R5 anyway (IDF rollback, no NVS flag). |
| O4-10 | major | transport_web.cpp:187 | `fwServer.available()` is deprecated → `-Wdeprecated-declarations`. O1 demands 0 warnings. | `fwServer.accept()`. |
| O4-11 | major | ota.cpp:232 | `setTimeout(OTA_NODE_TIMEOUT_MS)` — `HTTPClient::setTimeout(uint16_t)` truncates 120000 → 54464 (`-Woverflow` warning). | Per-read timeout belongs in our own loop (§R2); give HTTPClient `setConnectTimeout(5000)` and `setTimeout(10000)`. |
| O4-12 | major | ota.cpp:371, 382 | `nvs_handle` is the legacy typedef (`nvs_handle_t`); compiles today, deprecated. Moot after §R5. | Delete the NVS rollback code. |
| O4-13 | major | LED_Sign_Mesh.ino | Includes `ota.h` but never calls `ota::begin()`, `ota::hubBegin()`, `ota::nodeBegin()`, `markHealthy()`; no `o`/`O<pos>` serial letters; `s` does not show buildId/version/slot. Not a compile error, but items 3/10 and the serial spec are unimplemented. | §R5/§R6. |

### B. Protocol / radio (scope item 2, checklist 4)

| ID | Sev | File:line | Problem | Required fix |
|---|---|---|---|---|
| O4-14 | blocking | protocol.h:56-64; config.h:20; radio_espnow.cpp:66,134 | `sizeof(OtaEnter)` = 8+33+33+4+2+4+4 = **88 B** > `MAX_FRAME 64`. `radio::send()` returns false for `len > MAX_FRAME` and `onRecv` drops it, so `OTA_ENTER` can never leave the hub. The draft added no `static_assert` for the new structs. | `#define MAX_FRAME 128` (RX ring 16×137 B, TX 16×~150 B — fine). Add `static_assert(sizeof(OtaEnter) <= MAX_FRAME && sizeof(OtaStatus) <= MAX_FRAME)` and `<= 250`. Update the config comment ("largest frame is OtaEnter"). |
| O4-15 | blocking | protocol.h:9; radio_espnow.cpp:68 (unchanged) | `PROTO_VER = 2`, but `onRecv` still does `if (h->ver != PROTO_VER) return;`. A v2 hub drops every v1 HELLO at the radio layer (the "tolerate by length" code in `hub::handlePacket` never runs — and the draft did not add it either: `len >= sizeof(Hello)` now requires 17 B). Symmetrically a v1 node drops every v2 Show/OTA_ENTER, so a mixed fleet is mutually deaf. | Decision for the owner (§R4): **(a, recommended)** do not bump the wire version — keep `PROTO_VER = 1`, append `buildId[4]` to Hello/Hb, and let receivers read it only when `len >= sizeof(Hello)`, else treat as `00000000`; mixed fleets then work in both directions and only the OTA_ENTER type is unknown to old nodes (hub times out → "failed: no response"). **(b)** bump to 2 and accept `ver == 1 || ver == 2` in `onRecv` — but v1 nodes still drop v2 Shows, so (b) only helps the hub side. Since min_spiffs forces a wired install of every board anyway (O2), the mixed-fleet case is theoretical; (a) costs nothing and keeps the brief's intent. |
| O4-16 | blocking | hub.cpp:321, 345 | `if (len >= sizeof(Hello))` / `sizeof(Hb)` with the enlarged structs — rejects v1 frames outright (regression if (a) above is chosen; redundant under (b) since the radio dropped them). | `if (len >= HELLO_V1_LEN)` (13) / `HB_V1_LEN` (15) for the base fields; `if (len >= sizeof(Hello)) memcpy(buildId…) else memset(0)`. Add `constexpr size_t HELLO_V1_LEN = 13, HB_V1_LEN = 15;` + `static_assert(sizeof(Hello) == 17 && sizeof(Hb) == 19)` in protocol.h. |
| O4-17 | blocking | ota.cpp:275-278 | Node's ACK for OTA_ENTER is hand-built with `makeHdr(ACK, 1, 0)` and `a.pos = 1` (hard-coded position 1) and sent to `srcMac` with no `learnHub`. The hub's ACK case updates `info[1]` (the hub's own row). | Use node.cpp's existing `sendAck(OTA_ENTER, m->h.seq)` (node.cpp:106) — it already carries `myPos` and goes to `hubMac`. The ACK must be enqueued **before** `WiFi.begin()` and the pump must get a chance to send it (§R2: enter OTA on the next `tick()`, start Wi-Fi ≥ 150 ms later). Also tolerate OTA_ENTER retries: if already in OTA, re-ACK and ignore. |
| O4-18 | blocking | ota.cpp:356-364 | `nodeOtaReport` broadcasts OTA_STATUS with `srcPos = 1`; the hub matches the queue by `m->h.srcPos` (`ota.cpp:119`), so progress/failure from any node is attributed to pos 1 — or ignored. | Unicast to `hubMac` with `srcPos = myPos` (the status sender must live in node.cpp or receive pos/hubMac through the OTA context, §R2). The hub should match the queue entry by **srcMac** (it has it), not srcPos. |
| O4-19 | major | ota.cpp:93; protocol.h:63 | `OtaEnter.size = esp_ota_get_running_partition()->size` = 1 966 080 (the slot), not the image length. Combined with the fw server (O4-25) the node would download and flash ~2 MB of mostly 0xFF per board (~2× the time the brief budgets) and the progress bar would never reach 100 % at the real end. | `size = ota::imageLen()` computed once from `esp_image_verify(ESP_IMAGE_VERIFY_SILENT, …).image_len` (§R1). Serve exactly that many bytes with a matching `Content-Length`. |
| O4-20 | minor | protocol.h:66-72 | `OtaStatus.state` enum values are comments only (0 enter, 1 downloading, 2 verified, 3 rebooting, 4 failed) and the hub maps 2 and 3 both to "done" while the node never sends 3. | `enum OtaState : uint8_t { OTA_ST_JOINING=0, OTA_ST_DOWNLOADING=1, OTA_ST_VERIFIED=2, OTA_ST_FAILED=4 }` in protocol.h, shared by both ends. Hub states for the UI are a different enum (§R3). |
| O4-21 | minor | protocol.h | No BSSID in `OtaEnter`. `WiFi.begin(ssid, pass)` scans all channels (up to ~2 s during which the node is off channel 6 and the hub's OTA_ENTER retries go unanswered). | Add `uint8_t bssid[6]` (→ 94 B) filled from `WiFi.softAPmacAddress(buf)` and call `WiFi.begin(ssid, pass, ESPNOW_CHANNEL, bssid)` — single-channel, directed association, ~300 ms. |

### C. Hub OTA queue (item 4, checklist 2/3)

| ID | Sev | File:line | Problem | Required fix |
|---|---|---|---|---|
| O4-22 | blocking | ota.cpp:154-167, 164 | `hubStartOtaNodes()` passes **`s_buildId` (the hub's own id)** as the node's buildId to `hubOtaQueueAdd`, which returns early on `buildIdEq` → **the queue is always empty**; `ota_nodes` is a no-op. The comment admits it ("assume all online nodes need update"). It also reads the table from **NVS** (`storage::loadTable`) instead of the live `table[]`/`info[]`, and ignores online/offline. | The queue belongs in hub.cpp where `table[]`, `info[].buildId` and `info[].lastHb` live (§R3): snapshot under `tMux`, queue rows with `lastHb` within `OFFLINE_AFTER_MS` and `memcmp(buildId, mine, 4) != 0`. Offline boards are listed as `offline` and skipped. |
| O4-23 | blocking | ota.cpp:146-152; hub.cpp:578 (tick unchanged) | Nothing periodic drives the queue: timeouts are checked only inside `hubHandleOtaStatus()` (i.e. only when the *current* node sends something — a node that died at 50 % never times out) and "next node" is triggered only from that handler. `hub::tick()` was not touched. | `hub::tick()` → `otaTick(now)`: start next, time out after `OTA_NODE_TIMEOUT_MS`, mark done when a HELLO/HB from the queued MAC carries `buildId == mine` (that is the real completion signal — the node reboots and rejoins; OTA_STATUS "verified" is only a hint). |
| O4-24 | blocking | ota.cpp:184-188 | `hubCancelOta()` clears the *current* marker and immediately starts the **next** queued node — the opposite of cancel. Nothing tells the node to stop (it carries on downloading and reboots into the new image). | Cancel = clear the queue, mark current `cancelled`, and (optional) unicast `OTA_ENTER` with `size = 0` as "abort" — or simply let the node finish (document: cancel stops the queue; an in-flight download completes). O6(b) wants the former or a documented latter — recommend: hub stops the fw server for that client (`client.stop()` on cancel flag) which makes the node's download fail → `Update.abort()` → back to mesh with old firmware. That is deterministic and needs no new message. |
| O4-25 | blocking | transport_web.cpp:180-205 | fw server writes raw partition bytes with **no HTTP status line/headers** while the node uses `HTTPClient` which requires `HTTP/1.x 200 … Content-Length`. GET() returns -1/`HTTPC_ERROR_…` → "HTTP error" every time. It also never reads the request. Streams the **whole 1.9 MB slot** (O4-19). `uint8_t buf[4096]` on a **4096-byte task stack** → guaranteed stack overflow before the first write. Pinned to core 0 at the same priority as the radio pump with `delay(10)` polling. | §R1: 8 kB stack, static 2 kB chunk buffer (or mmap + direct `write(ptr, n)` with no buffer at all), read & discard the request until `\r\n\r\n`, send `HTTP/1.0 200 OK\r\nContent-Type: application/octet-stream\r\nContent-Length: <imageLen>\r\nConnection: close\r\n\r\n`, then exactly `imageLen` bytes, `client.stop()`. Block in `accept()` loop with `delay(20)`. Reject a second concurrent client (`503`). |
| O4-26 | major | transport_web.cpp:180-205 | `esp_partition_read()` from a task on core 0 goes through `esp_flash_read`, which disables the flash cache on **both** cores for each chunk; the WS2812 RMT refill ISR on core 1 is IRAM-safe, but any cache miss in `loop()`/`FastLED.show()` during that window stalls core 1 → visible glitches on the hub board while streaming. | Prefer `esp_partition_mmap(part, 0, imageLen, ESP_PARTITION_MMAP_DATA, &ptr, &hnd)` once (1.1 MB of DROM space is available on ESP32), then `client.write((const uint8_t*)ptr + off, n)` — cache stays enabled. Keep `esp_partition_read` as fallback if mmap fails. Bench question B3. |
| O4-27 | major | ota.cpp:190-216; hub.cpp:547 | `hubBuildOtaState(root)` writes `hub`, `queue`, `current` at the **root** of `/state`, not under `ota` as the brief specifies (`/state.ota {hub:{…}, queue:[…], current:{…}}`); `hub["buildId"] = String((char*)s_buildId, 4)` emits **4 raw bytes** (likely invalid UTF-8 → `r.json()` throws in the browser) instead of 8 hex chars; per-board `fw` is missing from `state.boards[]`; `current.pct` is hard-coded 0. | `JsonObject o = root["ota"].to<JsonObject>()`; `fwHex(buf, id)` → `"%02x%02x%02x%02x"`; `b["fw"] = fwHex(bi.buildId)` for every board row and the hub row; `current.pct` from the queue entry. |
| O4-28 | major | ota.cpp:78-92, 115-152, 190-216 | Queue arrays are written from core 0 (`handlePacket` → `hubHandleOtaStatus`, web `/cmd` → `hubStart…`) and read from core 0 (`/state`) and core 1 (serial `s`, and `tick()` once O4-23 is fixed) with no lock. | Guard with `tMux` (same lock as `table[]`/`info[]`) — the queue is tiny; or a dedicated `otaMux`. Commands only set a request (`otaReq = ALL | pos | CANCEL`) under the lock; `tick()` builds/advances the queue (house pattern). |
| O4-29 | minor | commands.cpp:218-224 | `ota_node` rejects `pos < 2` — correct (pos 1 is the hub) but reply `err` should distinguish "hub is pos 1, use /ota" from `bad_arg`; `ota_nodes` reply should return the queue (`queued: N`) so the UI can toast it. | `reply["queued"] = n; reply["skipped"] = upToDate;`. |

### D. Node OTA (item 5, checklist 3)

| ID | Sev | File:line | Problem | Required fix |
|---|---|---|---|---|
| O4-30 | blocking | ota.cpp:259-281; node.cpp:285-291 | `nodeHandleOtaEnter()` runs **inside `node::handlePacket()` on the core-0 radio pump task** and busy-waits `while (WiFi.status() != WL_CONNECTED && … < 5000) delay(10)`, then does a blocking `HTTPClient::GET()`. The pump stops draining the RX ring and the TX queue (the ACK it just enqueued is never sent → hub retries → timeout). Violates the established pattern outright. | §R2: the handler only records the request (`otaReq` copy under a mux) and ACKs; `node::tick()` (core 1) sees it, enters `NodeState::OTA`, and spawns `otaTask` (core 0, prio 1, 8 kB) which does join → GET → stream → `end(true)`. |
| O4-31 | blocking | ota.cpp:296 | `size_t read = s_otaClient.read(buf, 1024)` — `NetworkClient::read()` returns `int`, **-1 when no data is buffered** (which is most ticks). Cast to `size_t` → 0xFFFFFFFF → `read > 0` → `Update.write(buf, 4 GB)` → "write failed" within the first few ticks. Also reads 1 kB per `loop()` iteration (~1 ms) — ≥ 1 100 iterations of `nodeOtaTick` per image, each also hammering `getSize()`. | In the task: `int avail = stream->available(); if (avail > 0) { int n = stream->readBytes(buf, min(avail, CHUNK)); if (Update.write(buf, n) != n) fail; } else if (!client.connected()) fail; else delay(1);` with a 10 s no-progress watchdog and a 120 s overall cap. Or `Update.writeStream(*stream)` (blocking, no progress granularity → cannot report 5 % steps; use the manual loop). |
| O4-32 | blocking | ota.cpp:250-253 → 283-331 | After **any** failure `s_otaState = OTA_IDLE` but `node::st` stays `NodeState::OTA` forever: `nodeOtaRender()` returns early (black board), `tick()` only calls `nodeOtaTick()` which returns on IDLE — no HELLO, no HB, no LOST_HUB timer. The brief's "back to mesh with the old firmware" never happens. Also no `esp_wifi_set_channel(6)` after `WiFi.disconnect()`. | Node OTA result enum (`NONE/RUNNING/FAILED/REBOOTING`) read by `node::tick()`; on FAILED: `WiFi.disconnect(false)`, `esp_wifi_set_channel(ESPNOW_CHANNEL, WIFI_SECOND_CHAN_NONE)`, send `OTA_STATUS failed`, `setState(DISCOVER)` (HELLO → ASSIGN → RUNNING resumes). |
| O4-33 | blocking | ota.cpp:259-262, 245-253 | `Update.begin(UPDATE_SIZE_UNKNOWN)` though the length is known; `WiFi.mode(WIFI_STA)` re-applied; **no `WiFi.setSleep(false)`** — once associated, the default `WIFI_PS_MIN_MODEM` puts the STA to sleep between DTIMs and ESP-NOW RX from the hub becomes lossy (relevant to O10 and to receiving a cancel). | `WiFi.setSleep(false); WiFi.setAutoReconnect(false); WiFi.begin(ssid, pass, ESPNOW_CHANNEL, bssid);` then `Update.begin(contentLength)`; check `http.getSize() == m->size`. |
| O4-34 | major | ota.cpp:333-354 | `nodeOtaRender()` draws **digit 1** for every node (`uint8_t digit = 1; // position 1`), calls `display::show()` itself (FastLED.show is `loop()`-only — here it is called from `node::render()` so it happens to be core 1, but the pattern is one `show()` per loop in the .ino; a second call doubles the frame rate pacing logic), uses `renderDigit` which does not take a bar, and bar rows are drawn with a non-existent API (O4-08). Progress reported `pct % 5 == 0` fires on every chunk inside a 5 % band (dozens of frames). | §R2 render: `display::renderDigit(myPos, CRGB::Blue)` then bottom-2-rows bar via `ledIndex`; no `show()`. Progress: report when `pct / 5 != lastReportedPct / 5`. |
| O4-35 | major | ota.cpp:322 | `delay(100); ESP.restart()` immediately after enqueuing the "verified" OTA_STATUS — the pump (core 0) may not have sent it, and no HTTP connection teardown. | Set `result = REBOOTING`; `node::tick()` renders a full bar for 500 ms, waits for `radio` TX queue idle (or just 300 ms), then `ESP.restart()`. The hub treats the rejoin HELLO as the completion anyway (O4-23). |
| O4-36 | major | node.cpp:362-365, 337 | In `NodeState::OTA` the LOST_HUB logic is skipped (good) but `onShow` still runs for every Show (harmless) and HELLO/HB are suppressed only because the OTA case has no sends — fine. However `onAssign`/`SETPOS`/`FORGET`/`IDENTIFY` still mutate state mid-download (an `identify` from the phone would start the purple flash over the OTA render). | In `handlePacket`, when `st == OTA` accept only `OTA_ENTER` (re-ACK) and `SHOW` (clock), drop the rest. |
| O4-37 | minor | node.cpp:73 | `stateName` has `OTA`; status LED period table (node.cpp:357-361) has no OTA entry → status LED off during OTA. | 50 ms fast blink or solid blue-ish; cosmetic. |

### E. Hub upload `/ota` and rollback (items 6, 10, O3, O7)

| ID | Sev | File:line | Problem | Required fix |
|---|---|---|---|---|
| O4-38 | blocking | transport_web.cpp:218 | `server.on("/ota", HTTP_POST, handleOtaUpload)` registers the function as the **completion** handler, not the upload callback; `WebServer` parses multipart only when a handler `canUpload()` (4-arg `on`). As written the 1.1 MB body is read into `server.arg("plain")`/dropped, `upload()` is reached once with `status` uninitialised, and `server.send()` is called from inside what should be a streaming callback. | `server.on("/ota", HTTP_POST, otaUploadDone, otaUploadChunk)`; `otaUploadChunk` only drives `Update.begin(UPDATE_SIZE_UNKNOWN)` / `write` / `end(true)` and records `errorString()`; `otaUploadDone` sends `{"ok":bool,"err":..,"bytes":N,"slot":"app1"}` and arms `rebootAt = millis() + 1000` (checked in `poll()`), so the response reaches the phone before `ESP.restart()`. Never `delay(1000)` in a handler. Rate: `HTTP_UPLOAD_BUFLEN` 1436 B chunks → ~10–20 s for 1.1 MB over SoftAP, acceptable. |
| O4-39 | blocking | ota.cpp:366-391; .ino (none) | NVS "pendingVerify" scheme: `setPending(true)` is never called (not before the hub reboot, not on the node), `markHealthy()` is never called, there is no boot counter, no `esp_ota_set_boot_partition(other)`, and no `verifyRollbackLater()` — so with `CONFIG_APP_ROLLBACK_ENABLE=y` the Arduino core marks every freshly flashed image valid at `initArduino()` and a broken-but-bootable image is permanent. | §R5: delete the NVS code; `extern "C" bool verifyRollbackLater() { return true; }` in ota.cpp; `ota::tick()` on both roles: if the running partition is `ESP_OTA_IMG_PENDING_VERIFY` and `millis() ≥ OTA_VERIFY_MS` and healthy (hub: AP up + `hub::state()==RUNNING`; node: `node::state()==RUNNING`) → `esp_ota_mark_app_valid_cancel_rollback()`, log `[OTA] image confirmed`. `OTA_SELFTEST_FAIL` build flag → `ESP.restart()` at 10 s instead. Rollback happens on the **next reset** (one bad boot), not after three. |
| O4-40 | major | transport_web.cpp:138-172 | `/ota_status` fallback injects into `hubHandleOtaStatus(nullptr, &m)` with `srcPos = 1` → attributes to pos 1 / dereference of `srcMac` once O4-18 moves to MAC matching. | Keep the endpoint (O10 fallback) but require `pos` in the JSON and look the MAC up from the table; `server.client().remoteIP()` is not a MAC. Mark the endpoint as "fallback, decided after O10". |
| O4-41 | minor | transport_web.cpp:114-134 | `Update.abort()` after a failed write and then `return` leaves `UPLOAD_FILE_END` to call `Update.end(true)` on an aborted updater (returns false, fine) but the error message is lost. | Latch `otaErr` on first failure; ignore later chunks; report in the completion handler. Also `Update.onProgress()` → serial `[OTA] hub upload 42 %` every 10 %. |

### F. Regressions vs the verified baseline (checklist 5)

| ID | Sev | File:line | Problem | Required fix |
|---|---|---|---|---|
| O4-42 | blocking | web_page.h (draft) | Regenerated from the 177-line sketch: the shipped page would lose tabs, symbol keypad, swatches, sliders, boards grid, settings, debouncing, ES5 compatibility — everything verified in STEP3/STEP2 (O9 regression suite fails on sight). | Discard. Regenerate from the real `web/index.html` after the Firmware section is added (§UI). |
| O4-43 | major | hub.cpp:321 | HELLO handler now requires 17 B (see O4-16) — any `firmware/bench/` sketch or older node is dropped. | O4-16. |
| O4-44 | minor | radio_espnow.cpp:107 | `MAX_CONN` is a generic name in config.h. | `AP_MAX_CONN 4`. Behaviour change itself is correct (brief). |
| — | ok | hub.cpp/node.cpp (rest), sequencer, sign_state, storage, display, buttons | Byte-identical. Sequencing, mirror, identify (steady 10 s purple), ACK paths, auto-save, serial letters, role window: untouched. | — |

### G. Tooling (item 9, checklist 6)

| ID | Sev | File:line | Problem | Required fix |
|---|---|---|---|---|
| O4-45 | blocking | make_images.sh:7, 17-22, 31 | `build_id.h` is written by a script whose own header says "run **after** `arduino-cli compile`" — the header is generated after the binary, so the embedded `BUILD_GIT` is whatever a previous run left (or missing → compile error). Still copies `LED_Sign_update_app.bin`; no `LED_Sign_ota.bin`; README text still describes `write-flash 0x10000`. `#pragma once` fine. | §R7: the script owns the whole build: write `build_id.h` → `arduino-cli compile --warnings all --fqbn esp32:esp32:lolin32:PartitionScheme=min_spiffs --export-binaries` → merge HUB/NODE install images (same offsets; `boot_app0.bin` at 0xE000) → `cp LED_Sign_Mesh.ino.bin LED_Sign_ota.bin` → README: "install once by wire, update by OTA (`curl -F file=@LED_Sign_ota.bin http://192.168.4.1/ota` or the phone UI)". Add `firmware/LED_Sign_Mesh/build_id.h` to `.gitignore`. |
| O4-46 | major | tools/flasher.py:6,31,123-135,183; tools/flash_board.sh:5,17 | `--update` / `update` kind still write the app at 0x10000 — with two OTA slots that only works while the board runs app0; after one OTA it silently "updates" the inactive slot. | Remove the modes; print "updates are OTA — see README"; keep `hub`/`node` install. |

## Refactor plan

Refactor against the verified baseline (`b7ea985`), not by patching the draft. Keep ota.h small and JSON-free; the hub queue lives in hub.cpp (it needs `table[]`/`info[]`/`tMux`), the node state lives in node.cpp, ota.cpp holds the role-independent mechanics.

### R1 — Hub fw server (ota.cpp, hub only)

```cpp
// ota.h
namespace ota {
  void        begin();                       // buildId + imageLen (esp_image_verify SILENT, ~150 ms, once)
  const uint8_t* buildId();                  // 4 bytes of app_elf_sha256
  void        buildIdHex(const uint8_t* id, char out9[9]);
  const char* versionStr();                  // FW_VERSION_STR
  const char* gitStr();                      // BUILD_GIT
  const char* slotName();                    // running partition label ("app0"/"app1")
  uint32_t    imageLen();                    // exact running image length (served size)
  bool        pendingVerify();               // running image still ESP_OTA_IMG_PENDING_VERIFY
  void        tick(bool healthy);            // confirm image after OTA_VERIFY_MS when healthy (R5)
  void        startFwServer();               // hub: WiFiServer(OTA_PORT) task, core 0
  void        stopFwClient();                // hub cancel: drop the active download
  uint32_t    fwServed();                    // bytes served in the current/last transfer (status)
}
```

`fwServerTask`: `xTaskCreatePinnedToCore(task, "fw", 8192, nullptr, 1, &h, 0)`. Loop: `NetworkClient c = srv.accept(); if (!c) { delay(20); continue; }` → `c.setTimeout(2000)`; read request until blank line (bounded 512 B, 1 s); if method/path is not `GET /fw.bin` → `404` + close. Write header `HTTP/1.0 200 OK\r\nContent-Type: application/octet-stream\r\nContent-Length: %u\r\nConnection: close\r\n\r\n`. Body: `esp_partition_mmap(part, 0, imageLen, ESP_PARTITION_MMAP_DATA, &p, &hnd)` once at `begin()` (keep mapped); `while (off < len && c.connected() && !cancel) { n = min(2048, len-off); w = c.write(p+off, n); if (w <= 0) break; off += w; }`; `c.stop()`. Fallback when mmap fails: static `uint8_t buf[2048]` + `esp_partition_read`. No display, no radio, no JSON from this task. `cancel` is a volatile flag set by `stopFwClient()`.

### R2 — Node OTA (node.cpp owns the state, ota.cpp owns the transfer)

```cpp
// ota.h (node)
struct NodeOtaProgress { volatile uint8_t pct; volatile uint8_t result; char msg[24]; };  // result: 0 running,1 ok,2 failed
bool nodeOtaStart(const OtaEnter& e);   // spawns otaTask (core 0, 8 kB, prio 1); false if already running
const NodeOtaProgress& nodeOtaProgress();
```

- `node::handlePacket` (core 0): `case OTA_ENTER:` if `len >= sizeof(OtaEnter) && dstPos == myPos`: `learnHub(srcMac); sendAck(OTA_ENTER, seq);` if `st == OTA` → return (retry); else copy the frame into `pendingOta` under `showMux`-style `otaMux`, set `otaReqFlag`.
- `node::tick` (core 1): sees `otaReqFlag` → `setState(OTA)`, `otaEnteredAt = now`, `otaStartAt = now + 150` (lets the pump send the ACK). At `otaStartAt`: `ota::nodeOtaStart(pendingOta)`. In `OTA`: no HELLO/HB, LOST_HUB timer suspended; every 5 % change → `sendOtaStatus(pct, DOWNLOADING)` (unicast `hubMac`, `srcPos = myPos`, `radio::send` enqueues — pattern-safe); `result == ok` → `sendOtaStatus(100, VERIFIED)`, hold a full bar 500 ms, `ESP.restart()`; `result == failed` or `now - otaEnteredAt > OTA_NODE_TIMEOUT_MS` → `sendOtaStatus(pct, FAILED, msg)`, `WiFi.disconnect(false); esp_wifi_set_channel(ESPNOW_CHANNEL, WIFI_SECOND_CHAN_NONE);` `setState(DISCOVER)`.
- `otaTask` (core 0): `WiFi.setSleep(false); WiFi.setAutoReconnect(false); WiFi.begin(ssid, pass, ESPNOW_CHANNEL, bssid);` wait ≤ 8 s for `WL_CONNECTED` (`delay(50)` polls) else fail "join"; `NetworkClient cl; HTTPClient http; http.setConnectTimeout(5000); http.setTimeout(10000); http.setReuse(false); http.begin(cl, IPAddress(e.ip).toString(), e.port, "/fw.bin");` `GET() == 200` and `getSize() == e.size` else fail "http %d"; `Update.begin(size)` else fail `errorString()`; stream loop as in O4-31 with 4 kB static chunk, no-progress watchdog 10 s, update `pct`; `Update.end(true)` else fail; `http.end(); result = ok; vTaskDelete(nullptr)`. On any failure: `Update.abort(); http.end(); result = failed; vTaskDelete(nullptr)`. The task never touches `display::`, never calls `esp_now_send` (statuses are sent from `tick()`).
- Render (`node::render`, `OTA` case): `display::clear(); display::renderDigit(myPos, CRGB(0,0,255));` bar: `for col in 0..19: lit = col < pct*20/100; for row in 18,19: leds[ledIndex(row,col,mirror)] = lit ? CRGB(0,255,0) : CRGB::Black;` (digit glyph occupies rows ≤ 17 per `character_patterns.h`; verify the 20×20 digits do not reach row 18 — if they do, dim rather than clear). `display::show()` stays in `loop()`.
- `handlePacket` in `OTA`: accept `OTA_ENTER` (re-ACK) and `SHOW` (clock only); drop ASSIGN/SETPOS/IDENTIFY/FORGET/SETMIRROR.

### R3 — Hub queue (hub.cpp)

```cpp
enum class OtaRow : uint8_t { QUEUED, SENT, UPDATING, REBOOTING, DONE, FAILED, SKIPPED_OFFLINE };
struct OtaEntry { uint8_t mac[6], pos, pct; OtaRow st; uint32_t startedAt; char msg[24]; };
static OtaEntry otaQ[MAX_BOARDS]; static uint8_t otaQLen, otaCur /*index+1, 0 none*/; static uint8_t otaReq /*0 none,1 all,2 one,3 cancel*/, otaReqPos;
```

All under `tMux`. `hub::otaNodes()/otaNode(pos)/otaCancel()` (called from commands, any core) set `otaReq`. `tick()`: `otaReq` → build queue from `table[]`+`info[]` snapshot (online = `lastHb` within `OFFLINE_AFTER_MS`; needs update = `memcmp(info[pos].buildId, ota::buildId(), 4) != 0`); start next: fill `OtaEnter{ssid=radio::apSsid(), pass=AP_PASS, bssid=softAPmacAddress, ip=softAPIP, port=OTA_PORT, buildId, size=ota::imageLen()}`, `radio::send(mac, &e, sizeof e, true)`, `st = SENT, startedAt = now`. Completion: in `handlePacket` HELLO/HB case, if the MAC equals `otaQ[otaCur].mac` and the frame's buildId equals ours → `DONE`. `OTA_STATUS` (matched by srcMac): `pct`, `UPDATING`, `REBOOTING` on VERIFIED, `FAILED` + msg. Timeout `now - startedAt > OTA_NODE_TIMEOUT_MS` → `FAILED "timeout"`. Cancel → `ota::stopFwClient()`, remaining `QUEUED` rows dropped, current → `FAILED "cancelled"`. Serial: `[OTA] queue: pos 5 (buildId 1a2b3c4d → 9f8e7d6c)`, `[OTA] pos 5 42 %`, `[OTA] pos 5 done in 31 s`.

`buildState`: `root["ota"]` = `{hub:{buildId,version,git,slot,pendingVerify,imageLen}, queue:[{pos,state,pct,msg}], current:{pos,pct,state}|null}`; each board row gets `fw` (8 hex; `"00000000"` when unknown).

### R4 — buildId plumbing and v1 tolerance

`Hello`/`Hb` gain `uint8_t buildId[4]` at the end (17 / 19 B). Recommended: **keep `PROTO_VER = 1`** on the wire (see O4-15); `constexpr size_t HELLO_V1_LEN = 13, HB_V1_LEN = 15;`; hub reads base fields when `len >= V1_LEN`, buildId only when `len >= sizeof(T)`, else zeros. If the owner insists on `PROTO_VER = 2`, `onRecv` must accept `ver == 1 || ver == 2` and the doc must state that pre-Phase-4 nodes cannot be OTA'd (wired install, which O2 does anyway). `Hello.fw` stays `FW_VERSION` (bump to 2 for the status line only).

### R5 — Rollback (IDF, confirmed by sdkconfig)

- `extern "C" bool verifyRollbackLater() { return true; }` in ota.cpp (the hook is a weak **C** symbol in `esp32-hal-misc.c`; a C++-mangled definition would not override it).
- `ota::tick(healthy)` from `loop()` (both roles): once, when `pendingVerify() && millis() >= OTA_VERIFY_MS && healthy` → `esp_ota_mark_app_valid_cancel_rollback()`, `Serial.println("[OTA] image confirmed (rollback cancelled)")`. Hub healthy = `hub::state() == RUNNING` and `WiFi.softAPgetStationNum() >= 0` (AP up — `radio::beginHub` returned true); node healthy = `node::state() == RUNNING` (it has received a Show). `#ifdef OTA_SELFTEST_FAIL` → `if (pendingVerify() && millis() > 10000) ESP.restart();`.
- Behaviour to document (O7): a bad-but-bootable image is rolled back by the bootloader on the **first** reset without confirmation (power cycle, panic, WDT). Message on boot after rollback: check `esp_ota_get_state_partition(other) == ESP_OTA_IMG_ABORTED` and log `[OTA] previous image app1 rolled back`. `/state.ota.hub.pendingVerify` is true during the window; the UI shows "verifying… (Ns)".
- Node side: same mechanism; a node that fails to reach RUNNING within 30 s after OTA reboots (WDT/power) → bootloader restores the old image → it rejoins with the old buildId → hub shows it as needing update again (visible, correct).

### R6 — Serial / .ino

Hub `o` → `hub::otaNodes()`, `O<pos>` → collect digits like `t`, `s` prints `fw 0.4.0 (git b7ea985) buildId 1a2b3c4d slot app0 pendingVerify=0 imageLen=1134592 otaQueue: …`; node `s` prints buildId/slot. `loop()`: `ota::tick(healthy)` after the role tick; hub `poll()` checks `rebootAt`. Banner: `=== LED_Sign_Mesh 0.4.0 b7ea985 1a2b3c4d app0 ===`.

### R7 — make_images.sh owns the build

`VER=$(git rev-parse --short HEAD)`; write `build_id.h` (`#pragma once` / `#define BUILD_GIT "<VER>"`); `arduino-cli compile --warnings all --fqbn esp32:esp32:lolin32:PartitionScheme=min_spiffs --export-binaries firmware/LED_Sign_Mesh | tee release/$VER/build.log`; fail on `warning:` in our files; merge HUB/NODE install (bootloader 0x1000, partitions 0x8000, nvs 0x9000, boot_app0 0xE000, app 0x10000 — unchanged offsets); `cp …ino.bin LED_Sign_ota.bin`; README: install once by wire, then OTA; `SHA256SUMS`. `flasher.py`/`flash_board.sh`: delete `update`.

## Keep as-is

- `protocol.h`: `OtaEnter`/`OtaStatus` field order (add `bssid[6]`), `buildId[4]` appended to Hello/Hb, message type numbers 14/15.
- `hub.cpp`: `BoardInfo.buildId` fill in HELLO (under `tMux`) and HB; the `printStatus` buildId column.
- `commands.cpp`: `ota_nodes` / `ota_node {pos}` / `ota_cancel` dispatch and arg validation (route them to `hub::ota*`, add `queued` to the reply).
- `radio_espnow.cpp`: `softAP(..., MAX_CONN)` (rename `AP_MAX_CONN`).
- `transport_web.cpp`: the `/ota_status` JSON parser (hex buildId decode) as the O10 fallback, gated on a `pos` field.
- `index_draft.html`: the Firmware section markup (`#otaFile`, `#otaUpload`, `#otaAll`, `#otaProgress`, `#otaQueue`, `.fw-badge.bad`) as a starting point for the real page.
- `config.h`: `OTA_PORT`, `OTA_NODE_TIMEOUT_MS`, `OTA_VERIFY_MS` values.

## UI additions checklist (to the real `web/index.html`, 595 lines, ES5 only, ≤ 44 kB)

1. **Settings → Firmware card** (below the AP-name block): `Hub: fw <version> · <git> · build <buildId> · slot <app0|app1>` and `verifying… (Ns left)` while `ota.hub.pendingVerify`.
2. **Upload**: `<input type="file" id="fwFile" accept=".bin">` + `Upload to hub` button; `XMLHttpRequest` (not `fetch` — need `upload.onprogress`) `POST /ota` with `FormData` field `file`; progress bar `#fwProg` (0–100 %); on reply `{"ok":true}` → toast "Hub rebooting…", set `conn` to reconnecting, keep polling until `/state` answers and `ota.hub.buildId` changed; on `{"ok":false,"err"}` → toast red. Disable the button while uploading. Only enable when a file is chosen.
3. **Update all boards** button → `sendCmd({cmd:'ota_nodes'})` → toast `Queued N board(s)` (0 → "All boards up to date"); `Cancel` button visible while `ota.current` is non-null → `ota_cancel`.
4. **Status list** `#otaList` rebuilt from `ota.queue` each poll (2 s is already the poll period): `pos N · <fw> · up-to-date | queued | updating 42 % | rebooting | done | failed: <msg> | offline`; `up-to-date` rows come from `state.boards[].fw === ota.hub.buildId`. Build with `el()`/`textContent` (no `innerHTML`).
5. **Boards tab**: per card add `fw <8 hex>` badge via `el('span','badge fw'...)`; class `bad` (red) when `b.fw !== ota.hub.buildId`; per-board `Update` button (hidden for self and when up to date) → `sendCmd({cmd:'ota_node', pos})`.
6. **Remove mV**: line 492 — drop the `b.mv` clause; keep the `mv` JSON field server-side.
7. CSS: `.badge.fw{font-family:monospace}`, `.badge.fw.bad{background:#a33}`, `.prog{height:8px;background:#333;border-radius:4px}` `.prog>div{height:100%;background:var(--accent)}`.
8. Playwright stub for O8: `/state` with `ota:{hub:{buildId:'1a2b3c4d',…},queue:[{pos:5,state:'updating',pct:42}],current:{pos:5,pct:42,state:'updating'}}` and `boards[].fw` mixed; screenshot `docs/reviews/phase4_ui_firmware.png`.
9. Regenerate `web_page.h` with `tools/build_web.py`; check the size guard (40 kB source cap in `build_web.py` vs the brief's 44 kB — raise the guard to 44 kB if needed).

## Bench questions

- **B1 (O10)** ESP-NOW while associated: with `WiFi.setSleep(false)` on the node, measure hub→node Show delivery and node→hub OTA_STATUS loss while associated but before the download, and during the download. If OTA_STATUS loss > 10 %, switch the node to `POST /ota_status {pos,pct,state,msg}` over HTTP (the hub endpoint exists) and keep ESP-NOW for the ACK only. Also confirm the hub still receives HB from the *other* nodes while one node is associated (the AP interface is busy with TCP).
- **B2** Association time with `WiFi.begin(ssid, pass, 6, bssid)` vs plain `begin(ssid, pass)`; confirm the STA ends on channel 6 (`WiFi.channel()`) and that `esp_wifi_set_channel(6)` after `disconnect()` restores ESP-NOW RX on the failure path (O6a).
- **B3** Hub-board rendering during a 1.1 MB stream: visible glitches with `esp_partition_read` vs `esp_partition_mmap`; `s` → `netStackFree`, fw task high-water mark, heap after 10 transfers (no leak from `NetworkClient` copies).
- **B4** Throughput: time per node (`OTA_ENTER` → rejoin HELLO), target < 40 s; chunk size 2 kB vs 4 kB; whether a phone polling `/state` every 2 s on port 80 stays responsive (it should — separate task/socket).
- **B5** Rollback (O7 reworded): (a) truncated `.bin` → `Update.end` fails, no reboot, error in `/ota` reply; (b) `-DOTA_SELFTEST_FAIL` build uploaded → reboots at 10 s → bootloader logs `rollback`/`ABORTED` → back on the previous slot after **one** bad boot; (c) power-cycle the hub inside the 30 s window → also rolls back (document as expected).
- **B6** First-rollout path: hub updated via `/ota` while nodes run the previous Phase-4 build; `ota_nodes` queues them by buildId mismatch; `/state.ota` reaches `done` for each; `ota_nodes` again → empty (O5).
- **B7** `Update.begin(size)` on the node erases sectors lazily; measure whether the first `Update.write` stalls long enough to trip the 10 s no-progress watchdog (it should not — erase is per 4 kB sector as written).
- **B8** Row budget for the progress bar: confirm the digit glyphs in `character_patterns.h` leave rows 18–19 free; otherwise shift the bar to a single row or dim the glyph.

## Refactor disposition

Refactored against the verified baseline (`b7ea985` + identify fix `f62bd28`), not by patching the draft. Nothing from `drafts/ota_qwen_v1/` was copied verbatim; the struct layouts, `BoardInfo.buildId` plumbing, command shapes, `max_conn` change and the Firmware-section idea were re-implemented per "Keep as-is". Owner's settled decisions (refactor brief) override the review where they differ — noted below.

**Build** (Qwen box, core 3.3.12): `arduino-cli compile --warnings all --fqbn esp32:esp32:lolin32:PartitionScheme=min_spiffs LED_Sign_Mesh` → 0 errors, **0 warnings in our sources** (16 warnings, all in FastLED 3.10.9 and the core's `periph_ctrl.h`, same set as before). Via `tools/make_images.sh` at `8a36995`: app **1 136 995 B** (57 % of the 1 966 080 B slot), globals 63 784 B. `LED_Sign_ota.bin` 1 137 136 B, HUB/NODE install 1 202 672 B each; `build_id.h` = `8a36995` = `git rev-parse --short HEAD`; `0.4.0` and `8a36995` found in the image. `tools/seq_test`: 23/23. Playwright O8 (stub server): 18/18, no console errors; screenshots `phase4_ui_firmware.png`, `phase4_ui_boards.png`.

| ID | Disposition |
|---|---|
| O4-01 | Fixed. `FW_VERSION_STR "0.4.0"` (config.h); `build_id.h` included from ota.cpp only behind `__has_include`, fallback `BUILD_GIT "dev"`; gitignored. `FW_VERSION` bumped 1→4 (informational HELLO.fw / cfg.fw only). |
| O4-02/03/09/12 | Fixed by structure: ota.h is JSON-free; Update/esp_ota includes live in ota.cpp; transport_web.cpp only registers routes and calls `ota::`; NVS rollback code not carried over. |
| O4-04..08 | Fixed: `AP_PASS`; `IPAddress(ip).toString()` with `http.begin(client, host, port, "/fw.bin")`; `setReuse(false)`; `Update.progress()` not needed (own byte count); render via `display::leds[ledIndex(...)]`. |
| O4-10/11 | Fixed: `NetworkServer::accept()`; `setConnectTimeout(5000)` / `setTimeout(10000)`, overall 90 s and 10 s stall watchdog in our own loop. |
| O4-13 | Fixed: .ino calls `ota::begin`, `ota::startFwServer` (hub, after the net task), `ota::tick(healthy)` every loop; serial `o`, `O<pos>`, extended `s`; banner `=== LED_Sign_Mesh 0.4.0 <git> <buildId> <slot> ===`. |
| O4-14 | Fixed: `MAX_FRAME 128`; `static_assert` for every frame ≤ MAX_FRAME, exact sizes (Hello 17, Hb 19, OtaEnter 94, OtaStatus 38), MAX_FRAME ≤ 250. |
| O4-15/16/43 | Fixed per settled decision (a): `PROTO_VER` stays 1, buildId appended; hub accepts `len >= HELLO_V1_LEN/HB_V1_LEN` and reads buildId only when the frame is long enough, else `00000000`. |
| O4-17 | Fixed: node ACKs with `sendAck(OTA_ENTER, seq)` (myPos, hubMac) on every copy; retries while already in OTA are re-ACKed and ignored; Wi-Fi starts ≥150 ms later from core 1's handover. |
| O4-18 | Fixed: OTA_STATUS unicast to hubMac with `srcPos = myPos`; hub matches by **srcMac** against the in-flight MAC. |
| O4-19 | Fixed: `ota::imageLen()` from `esp_image_get_metadata()` on the running partition (once at hub boot, logged with ms); `OtaEnter.size`, `Content-Length` and the served byte count are that value; node checks `getSize() == size`. |
| O4-20 | Fixed: `OtaWireState` enum in protocol.h; hub UI states are `OtaRow` in hub.cpp. |
| O4-21 | Fixed: `bssid[6]` appended (94 B); node calls `WiFi.begin(ssid, pass, 6, bssid)` and aborts if the channel is not 6 after association. |
| O4-22/23/28 | Fixed: queue in hub.cpp under `tMux` (FIFO of positions + per-position `OtaRec`); built from live `table[]`/`info[]`, online = HB within `OFFLINE_AFTER_MS`, unknown buildId counts as different; `otaTick()` in `hub::tick()` starts the next node, fails it on "no response" (no ACK/status in 10 s) or "timeout" (120 s); completion = HELLO/HB from the in-flight MAC carrying the hub's buildId. Commands only edit the queue under the lock. |
| O4-24 | Fixed per settled decision: `ota_cancel` drops the queued rows; the node in flight finishes or hits its own timeout (documented in UI hint, README and hub.h). No `stopFwClient`. |
| O4-25 | Fixed: dedicated task (core 0, prio 1, 8 kB stack), static 4 kB buffer, bounded request read (2 KB / 2 s), `GET /fw.bin` → `HTTP/1.0 200` + `Content-Length` + exact image bytes; anything else 404; no image → 503; one client at a time (backlog); start/end/bytes/ms logged. |
| O4-26 | **Deferred to bench B3.** Settled decision is `esp_partition_read` + static 4 kB buffer; mmap not implemented. Watch the hub board for glitches while serving. |
| O4-27 | Fixed: `/state.ota = {hub:{buildId,version,git,slot,valid,verifyIn,imageLen}, running, upload, current:{pos,pct,state}|null, boards:[{pos,buildId,status,pct,err}]}` (settled shape; `verifyIn/imageLen/upload` extra); every `state.boards[]` row has `fw` (8 hex). Also `GET /ota` returns the same object. |
| O4-29 | Fixed: `ota_nodes` replies `queued`/`skipped`; `ota_node` errors `hub_use_ota_upload`, `up_to_date`, `offline`, `queued`, `busy`, `no_image`, `bad_arg`. |
| O4-30..33 | Fixed: core-0 handler validates (len, dstPos == myPos, myPos ≠ 0), ACKs, copies under `otaMux`; `node::tick()` enters `NodeState::OTA` and calls `ota::nodeStart()` (task core 0, 8 kB). Read loop uses `available()`/`read()` as `int`, never casts a negative. Every failure path: `Update.abort()`, `WiFi.disconnect(false)`, `esp_wifi_set_channel(6)` (in the task), FAILED status with reason, `DISCOVER`. `WiFi.setSleep(false)`, `setAutoReconnect(false)`, `Update.begin(contentLength)`. |
| O4-34 | Fixed: blue position digit + 2-row bar, no `show()` from render. Progress status every **10 %** (settled; review said 5 %), deciles compared. B8 answered: digit glyphs use all 20 rows, so the bar replaces the glyph's bottom two rows (green done / dim grey remaining). |
| O4-35 | Fixed: VERIFIED status sent from tick, full bar for 500 ms, then `ESP.restart()`; hub uses the rejoin HELLO as completion. Backstop: tick restarts on the old image if the task overruns 100 s. |
| O4-36/37 | Fixed: in `OTA` only `OTA_ENTER` and `SHOW` are processed; entering OTA cancels a running identify; status LED blinks at 50 ms. |
| O4-38/41 | Fixed: `server.on("/ota", HTTP_POST, otaDone, otaChunk)`; first error latched; `radio::pump()` between chunks keeps the mesh alive during the upload; reply `{ok,size,err}`; reboot armed +1 s, executed by `ota::tick()` on core 1. Refused (`"node update in progress"`) while a node OTA is queued/in flight; `ota_nodes` refused (`busy`) while an upload runs. |
| O4-39 | Fixed per settled decision: `extern "C" bool verifyRollbackLater() { return true; }`; `ota::tick(healthy)` calls `esp_ota_mark_app_valid_cancel_rollback()` once after `OTA_VERIFY_MS` when healthy and logs `[OTA] image marked valid (slot X)`. Hub healthy = RUNNING + AP IP up + channel 6 + radio init OK; node healthy = radio OK + channel 6 + (reached RUNNING at least once, or currently DISCOVER). Boot log prints slot, address, `esp_ota_get_state_partition`, and "previous image … rolled back" when the other slot is ABORTED/INVALID. `-DOTA_SELFTEST_FAIL` reboots at 10 s while pending (for B5). |
| O4-40 | **Deferred** (O10): `/ota_status` HTTP fallback not implemented; status goes over ESP-NOW only. Add it only if B1/O10 measures > 10 % OTA_STATUS loss while associated. |
| O4-42 | Fixed: Firmware card added to the real `web/index.html` (ES5, `el()`/`textContent`, 36 750 B ≤ 44 kB); `web_page.h` regenerated (10 781 B gz); `build_web.py` guard raised to 44 kB. |
| O4-44 | Fixed: `AP_MAX_CONN 4`. |
| O4-45 | Fixed: `make_images.sh` writes `build_id.h` (adds `-dirty` if `firmware/` or `web/` has uncommitted changes), compiles with `--warnings all --export-binaries` and min_spiffs, fails on warnings in our sources, produces HUB/NODE install + `LED_Sign_ota.bin`, README.txt, SHA256SUMS, `build.log`. |
| O4-46 | Fixed: `flasher.py --update` exits with the OTA instructions; `flash_board.sh update` likewise; both print the OTA note after an install. README.md, firmware/bench/README.md, docs/HOWTO_build_pipeline.md: min_spiffs FQBN, "wired install once → OTA forever". |

**Interpretations for the verifier**
- O7 as reworded by the review: an unconfirmed image rolls back on **one** reset, not three. A wired install (blank otadata) boots app0 with no otadata entry (`state=n/a`), so it is never "pending".
- Node health "reached RUNNING or DISCOVER": a node rebooted into a new image confirms at 30 s if it is RUNNING (normal) or still DISCOVERing; if it is LOST_HUB at 30 s it confirms later, once it reaches RUNNING. A reset before confirmation rolls it back.
- `ota_node` on an up-to-date board is refused (`up_to_date`) rather than re-flashing the same image.
- While a node downloads it sends no HB, so the Boards tab shows it offline; the Firmware table shows its OTA status.
- The hub's `/ota` upload blocks the port-80 server (single-threaded) for the transfer; the page pauses `/state` polling while uploading and resumes after the reply. ESP-NOW keeps running (radio pumped per chunk).
- The status table merges `err` into the status cell (`failed: timeout`) to fit a phone; columns are Pos / fw / Status / % / Update.

**Not verified (needs hardware):** everything in O2–O7, O9, O10 and bench B1–B8 except B8. In particular: `esp_image_get_metadata().image_len` must equal the `.bin` file size (1 137 136 B for `8a36995`); the hub logs it at boot.
