Alternating/esp32-LED-sign/docs/fonts/preview_new.png

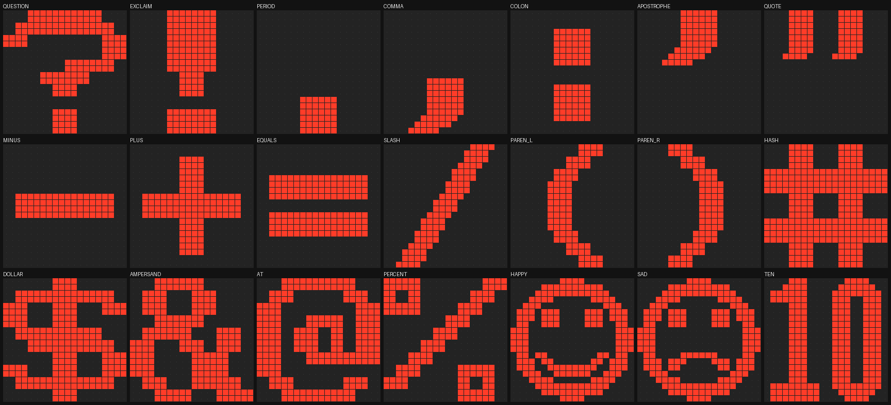
docs/fonts/preview_new.png
