Alternating/esp32-LED-sign/docs/reviews/phase4_ui_boards.png

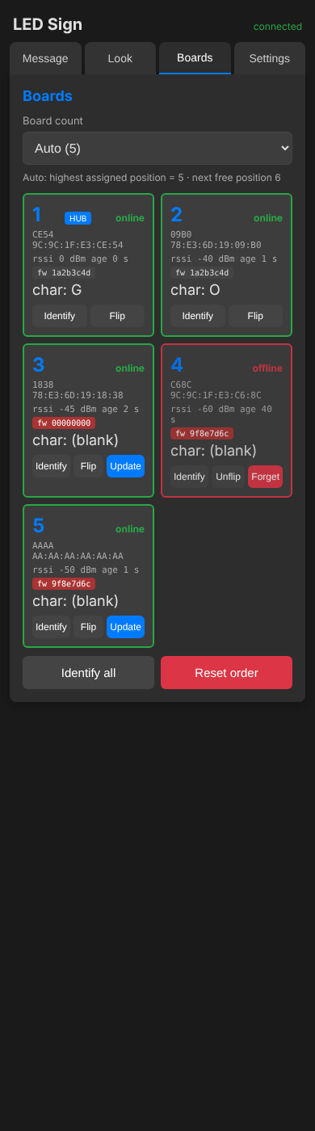
docs/reviews/phase4_ui_boards.png
