Alternating/esp32-LED-sign/docs/reviews/phase4_ui_firmware.png

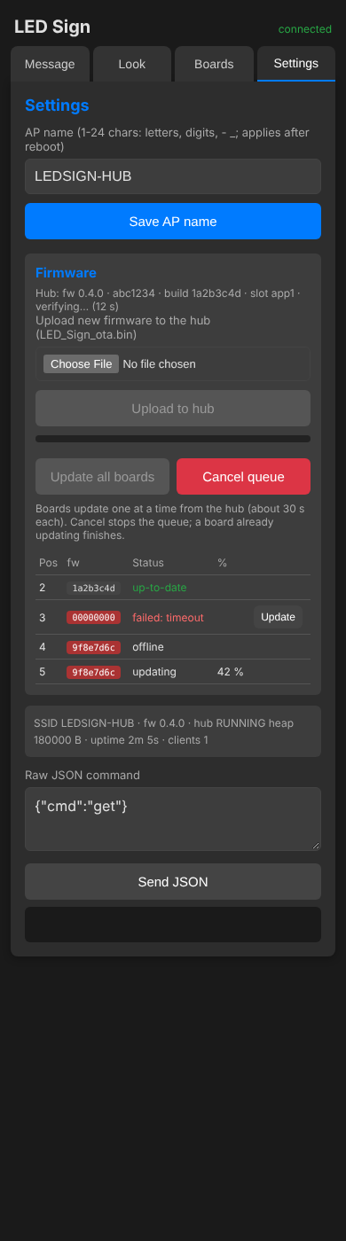
docs/reviews/phase4_ui_firmware.png
