Alternating/esp32-LED-sign/hardware/battery_hanger_-_led_sign_v4.stl

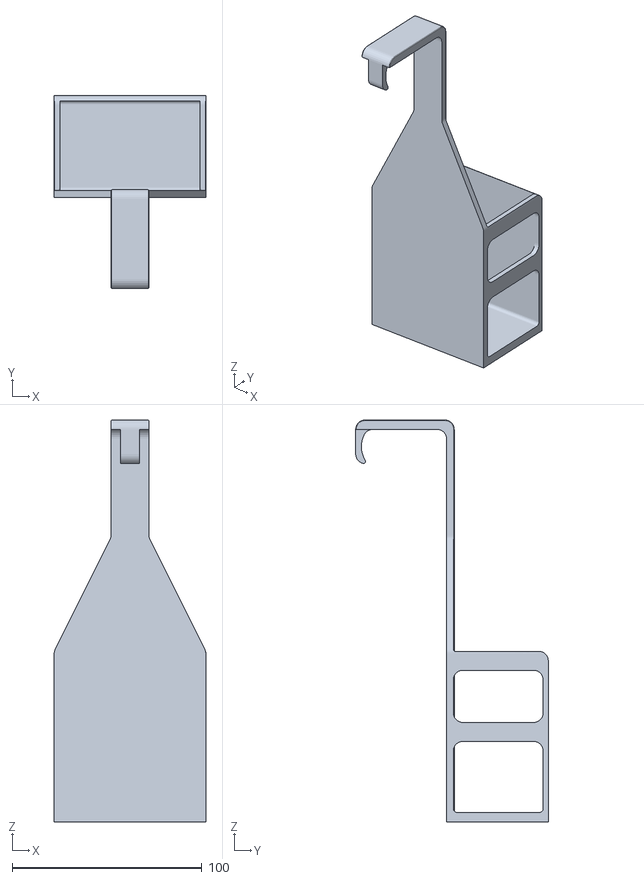
[picture p12: CAD file, 2026-11-08]
hardware/battery_hanger_-_led_sign_v4.stl
80.0 x 101.6 x 212.0
