Alternating/esp32-LED-sign/(list of files, cad)

Other CAD files:
hardware/battery_hanger_-_led_sign_v3.f3d
