Alternating/esp32-LED-sign/docs/reviews/STEP1_REVIEW.md

# Review — Phase 1 step 1 draft (`firmware/LED_Sign_Mesh/`, Qwen draft 1)

Reviewed against: `docs/build-briefs/PHASE1_STEP1_radio_and_numbering.md`, `docs/PROJECT_PLAN.md` §2.1/2.3/3/4.1/5, `firmware/bench/espnow_ping/espnow_ping.ino`. Draft read from the Qwen box (`~/esp32-led-sign/firmware/LED_Sign_Mesh/`), compile log `/tmp/mesh_build1.log` (arduino-cli stopped after display.cpp / node.cpp / FastLED.h; hub.cpp, radio_espnow.cpp and the link stage were never reached, so the log under-reports).

Toolchain: core 3.3.12 / IDF 5.5.5, FastLED 3.10.9, LOLIN32 `no_ota`.

## Verdict

**NOT MERGEABLE — 14 blocking, 17 major, 14 minor.**

The draft has a reasonable file layout, correct packed protocol structs and a radio init sequence that follows `espnow_ping`, but it does not compile (6 distinct error classes, only 3 of which are in the log) and, once it compiles, it cannot pass A2: `radio::pump()` discards every received packet, the hub never adds a node as a peer, every save to NVS silently fails, and all packets carry `seq = 0` so the node's own dedupe drops every Show after the first. Acceptance A2–A6 all fail as written.

## Findings

Severity: **blocking** = will not compile or defeats A1/A2 outright; **major** = acceptance test or plan §3 behaviour fails; **minor** = quality/robustness.

### Compile (A1)

| ID | Sev | File:line | Problem | Required fix |
|---|---|---|---|---|
| S1-01 | blocking | config.h:46 | `#define FASTLED_RMT5 0` is a hard `#error` in FastLED 3.10.9 on IDF 5.x (log lines 23, 28). | Delete the line (and the "Display" section). RMT5 default is the verified configuration. |
| S1-02 | blocking | display.cpp:18,21,65,68,71,74 | `FastLED.fillSolid(...)` does not exist. | `fill_solid(leds, LEDS_PER_BOARD, color);` (free function from `colorutils.h`, already pulled in by `FastLED.h`). |
| S1-03 | blocking | node.cpp:37-38, 76-77 | `static uint32_t lastHello` and `uint32_t now` declared directly under `case` labels with no braces: "jump to case label" ×4 and "redeclaration" ×2. Two different `lastHello` statics are also needed (DISCOVER 1 Hz vs LOST_HUB 0.2 Hz). | Hoist `uint32_t now = millis();` above the `switch`; make `static uint32_t lastHelloMs` a file-scope variable (one is enough — reset it on state entry); wrap every `case` body in `{ }`. |
| S1-04 | blocking | hub.cpp:51,127,137; node.cpp:47,86,162; radio_espnow.cpp:81 | `(uint8_t[]){0xFF,...}` compound literal passed as a pointer. g++ rejects this in C++ ("taking address of temporary array", verified with g++ 13). Not in the log only because those TUs were never compiled. | Add `extern const uint8_t BCAST[6];` to `radio_espnow.h`, define `const uint8_t BCAST[6] = {0xFF,0xFF,0xFF,0xFF,0xFF,0xFF};` in `radio_espnow.cpp`, use `radio::BCAST` everywhere. |
| S1-05 | blocking | character_patterns.h:2580 (via display.h:6) | `const bool* getCharacterPattern(char)` is a non-`inline` function **defined** in a header that `display.h` includes; `display.h` is included by display.cpp, hub.cpp, node.cpp and the .ino → "multiple definition of `getCharacterPattern`" at link. | Remove `#include "character_patterns.h"` from `display.h` and include it only in `display.cpp` (preferred: display.h only needs `<FastLED.h>` for `CRGB`). Alternatively mark the function `inline`. |
| S1-06 | blocking | storage.cpp:21,36,51,66,74,90 | `prefs.begin(ns, true)` opens the namespace **read-only**; every `put*()` and `clear()` returns 0 and nothing is persisted. Also `begin("tbl", true)` on a namespace that was never created fails outright. Consequences: serial `H`/`N` never saves the role (A2), node pos never saved (A3), table never saved/cleared (A3/A5). | Use `prefs.begin(ns, false)` in every save/clear function. (Read-only `true` is only appropriate for loads, and even then `false` is harmless.) |
| S1-07 | minor | storage.cpp:59 | `uint32_t size` unused (warning). `getBytes` with a missing key leaves `entries` untouched — fine only because callers zero-init; make it explicit. | `memset(entries, 0, sizeof(TableEntry)*MAX_BOARDS);` before `getBytes`, drop `size` or check it equals the expected length. |
| S1-08 | minor | display.cpp:10 vs hub.cpp:20 / node.cpp:16 | `display::begin()` is called in `setup()` **and again** in `hub::begin()`/`node::begin()`. A second `FastLED.addLeds<>` registers a second controller on GPIO 4: every `show()` then drives the strip twice (~27 ms/frame), halving frame rate and inviting flicker. `bootAnimation()` also runs twice (3.6 s wasted). | Remove `display::begin()` and `display::bootAnimation()` from `hub::begin()` and `node::begin()`; they belong in `setup()` only (plan §5.2). |

### Radio layer (`radio_espnow.*`)

| ID | Sev | File:line | Problem | Required fix |
|---|---|---|---|---|
| S1-09 | blocking | radio_espnow.cpp:147-152 | `pump()` drains the RX ring and **discards every packet** ("not implemented here"). Nothing is ever dispatched to hub/node; the whole mesh is dead. | Add `typedef void (*RxHandler)(const uint8_t* srcMac, const uint8_t* buf, uint8_t len); void setHandler(RxHandler fn);` to `radio.h`. In `pump()`: `while (rxTail != rxHead) { RxItem& it = rxRing[rxTail]; if (handler) handler(it.srcMac, it.buf, it.len); rxTail = (rxTail+1) % RX_BUF_SIZE; }`. hub and node each register one `handlePacket()` that switches on `((const Hdr*)buf)->type`. |
| S1-10 | blocking | radio_espnow.cpp (all), hub.cpp:35,61,76,92,112,135; node.cpp:42,81,157 | `Hdr.seq` is hard-coded `0` in every packet on both roles. (a) node `onShow` dedupe `if (s->h.seq == lastShowSeq) return;` drops every Show after the first → `lastShowTime` never refreshes → node goes LOST_HUB 5 s after joining and never returns (A2/A4 fail). (b) The RX ring dedupe on `(srcMac, seq=0)` drops any second packet from the same MAC that arrives while the first is still unconsumed. (c) ACK matching is impossible. | Make `radio::send()` own the sequence: `static uint16_t txSeq; ((Hdr*)buf)->seq = ++txSeq;` (take `uint8_t* buf`, not `const`, or copy into the queue slot first and stamp there). Keep a small `lastSeq[12]` table keyed by MAC for dedupe (ring scan is wrong anyway: a duplicate is one *already consumed*, which the ring no longer holds). |
| S1-11 | blocking | radio_espnow.cpp:105-126, 154-170 | No ACK consumption path. Queue entries are retried 5× regardless; the queue is strictly head-only so one unacked ASSIGN blocks all other unicasts for 1 s. `onSent` on failure marks `sendQueue[sendQueueTail]` (the *next free slot*), not the in-flight item. | In `pump()` (or a `radio::ackReceived(mac, ackSeq)` called by the handler), remove the head item when `memcmp(item.mac, srcMac,6)==0 && item.seqStamped == ack->ackSeq`. Mark failures on `sendQueue[sendQueueHead]`. Set `flags |= 0x02` (isRetry) on retransmits. |
| S1-12 | major | radio_espnow.cpp:124, hub.cpp:51,127; node.cpp:47,86 | Non-ACK sends call `esp_now_send()` directly from the caller — `hub::tick()`/`node::tick()` run on core 1 while `pump()` sends from core 0, with no `sendBusy` gate. Plan §2.3: one outstanding send, gated by the TX callback, all sends from the net task. | Every `radio::send()` enqueues (needsAck or not). `pump()` sends the head only when `!sendBusy`; `onSent` clears `sendBusy` (as in `espnow_ping`). Non-ACK items are popped when `onSent` fires; ACK items stay until acked or 5 retries. Grow `SEND_QUEUE_SIZE` to 16. |
| S1-13 | major | hub.cpp:66,81,97; node.cpp (nowhere) | Hub never calls `radio::addPeer(mac)` before unicasting ASSIGN → `esp_now_send` returns `ESP_ERR_ESPNOW_NOT_FOUND`; node never adds the hub as a peer so it could not ACK/HB either. A2 fails. | Hub: `radio::addPeer(mac)` at the top of `onHello` (make `addPeer` idempotent: `if (esp_now_is_peer_exist(mac)) return;`). Node: on ASSIGN, store `hubMac` and `radio::addPeer(hubMac)` before sending ACK. |
| S1-14 | major | radio_espnow.h:24-29, 41-48 | `RxItem`/`SendItem` carry a 250-byte buffer each (32×259 + 8×265 ≈ 10.4 kB static). Acceptable but oversized — the largest frame is 40 B. | Set a `MAX_FRAME 64` (static_assert `sizeof(Show) <= MAX_FRAME`) and size buffers to it; frees ~8 kB. |
| S1-15 | minor | radio_espnow.cpp:62-88 | Hub init order deviates slightly from `espnow_ping`: channel check/force happens before `esp_now_init` (fine) but there is no log line and `channelOk()` is never asserted/printed anywhere. `beginHub/beginNode` return silently if `esp_now_init` fails. | Print `Wi-Fi channel: %d (want 6) OK|MISMATCH` and `esp_now_init FAILED` as in the bench sketch; have `begin*()` return `bool`. |
| S1-16 | minor | radio_espnow.h:33-56 | All internals (`rxRing`, `sendQueue`, `peerTable`, `hubMode`, `myMac`) are `extern` in the public header. | Move to the .cpp as `static`; expose only the API plus `BCAST`, `myMac()` and `channelOk()`. |

### Hub (`hub.*`)

| ID | Sev | File:line | Problem | Required fix |
|---|---|---|---|---|
| S1-17 | blocking | hub.cpp:106-130 | RESET ORDER broadcasts a **Show** with `'?'`, not a `RESETORD` message. Nodes never go UNASSIGNED (A5 fails). Also 5× `delay(200)` blocks `loop()` for 1 s. | Send `Hdr{..., RESETORD, 0, seq, myPos, POS_ALL}` (8 B) via the queue. For the 5-over-1-s burst keep a `resetBurstLeft`/`nextBurstAt` pair serviced in `tick()`, no `delay`. Clear the RAM table too (`memset(table,0,...)`). |
| S1-18 | major | hub.cpp:16-26 | No `HubState`; "1" for 3 s is a blocking `delay(3000)` in `begin()` that runs *before* the net task exists and before the serial H/N wait, so the hub is deaf for the first ~10 s and never logs `[HUB] SHOW_POSITION -> RUNNING`. | `enum class HubState {BOOT, SHOW_POSITION, RUNNING}`; `begin()` renders the digit and records `showPosUntil = millis()+3000`; `tick()` transitions to RUNNING when elapsed and logs it. Periodic Show may already start in SHOW_POSITION (heartbeat). |
| S1-19 | major | hub.cpp:28-53, 140-149 | No "Show 3× on change (0/60/250 ms, same seq)" and `showSeq` is always 0; `setTestString` does not bump anything. Periodic frame does not set `flags` bit2 (periodic). Hub never renders its own `chars[0]` (A6: "hub renders A" fails). | Keep `uint16_t showSeq; uint8_t burstLeft; uint32_t burstAt[3];` — `setTestString` → `showSeq++`, schedule burst at +0/+60/+250 ms (same `seq` for the 3 copies: build the frame once, stamp seq once, resend the bytes). Periodic frame: `flags = 0x04`. In `tick()` render `testString[0]` locally and print `[HUB] render 'A'` when it changes. |
| S1-20 | major | hub.cpp:57, 73, 86-89 | Table logic: (a) known-MAC scan uses `i < nextPos-1` and new entries go to `table[nextPos-2]` — index is coupled to `nextPos`, so it breaks as soon as "skip owned positions" or `FORGET` exists; (b) table-full check `nextPos > MAX_BOARDS+1` lets the hub assign **pos 11** (`nextPos` reaches 11 before the check trips); (c) "nextPos skipping owned positions" and "accept node's nvsPos if unused" (plan §3.4, hub-reflash case) are not implemented; (d) table-full `ASSIGN{pos=0}` is not logged. | Treat `table[]` as an unordered set: scan all `MAX_BOARDS` entries where `pos != 0`. New MAC: `if (nvsPos>=2 && !owned(nvsPos)) pos = nvsPos; else { while (owned(nextPos) && nextPos<=MAX_BOARDS) nextPos++; if (nextPos > MAX_BOARDS) → ASSIGN pos 0 + log; pos = nextPos++; }` then put in first free slot, `saveTable(table, nextPos)`. Add `bool owned(uint8_t pos)`. |
| S1-21 | major | hub.cpp:132-138 | IDENTIFY ALL broadcasts correctly but the hub does not flash itself ("hub too", plan §3.3) and `onIdentifyAll` is not wired to K2 long. | Set `identifyUntil = millis()+ms` on the hub as well and render white in `tick()` while active. |
| S1-22 | major | hub.cpp (missing) | After ASSIGN the hub must "immediately follow with a Show so a late joiner lights up" (plan §3.3). Not done. HB/CLAIM/FORGET handling absent (`onClaim` exists but nothing calls it; FORGET should free the position). | In the RX handler: `case HELLO/CLAIM: onHello(...); scheduleShowBurst();` `case FORGET: free entry for srcMac, saveTable.` `case ACK: radio::ackReceived(...)`. `case HB:` update `lastSeen[pos]` (10 s offline mark can be a log line this step). |
| S1-23 | minor | hub.cpp:51,127 | `sizeof(Show) - (10 - numBoards)` truncation saves ≤9 bytes and couples hub and node to a magic length; node check (`len < sizeof(Show)-10`) matches today but any struct change breaks both silently. | Send `sizeof(Show)` (40 B) always; node requires `len >= sizeof(Show)`. |
| S1-24 | minor | hub.cpp:18-19 | `storage::loadMirror();` result discarded, then called again. `hub::mirror`, `display::mirror` and the .ino `mirror` are three separate copies; `m` updates two of them. | Single source of truth: `display::mirror` loaded once in `setup()` from `storage::loadMirror()`; delete `hub::mirror` and the .ino global. |

### Node (`node.*`)

| ID | Sev | File:line | Problem | Required fix |
|---|---|---|---|---|
| S1-25 | blocking | node.cpp (missing) | Node never sends `ACK` on ASSIGN and never learns/adds the hub MAC. Hub retries ASSIGN 5×, every retry re-enters `onAssign` → `SHOW_POSITION` restarts and `lastShowTime` is reset 5 times. | `onAssign(const uint8_t* hubMac, const Assign& a)`: store `hubMac`, `radio::addPeer(hubMac)`, send `Ack{h{ACK,…,srcPos=pos,dstPos=0}, ackType=ASSIGN, ackSeq=a.h.seq, pos}` unicast. Ignore an ASSIGN that repeats the current pos while already in SHOW_POSITION/RUNNING (still ACK it). |
| S1-26 | major | node.cpp:115-138, 144-146 | `onShow` / `onIdentify` are called from the RX path (core 0 net task) and render + `FastLED.show()` there; `identifyFlash()` additionally blocks the net task for 2 s with `delay()`. Plan §5.4: display only from `loop()`. | Handlers only copy data and set flags: `latestShow = *s; haveShow = true; identifyUntil = millis()+ms;`. `tick()` (core 1) renders from those; `loop()` is the only caller of `FastLED.show()`. Mark the shared fields `volatile` (or wrap in `portENTER_CRITICAL`). |
| S1-27 | major | node.cpp:55-63, 71-74, 89-94; .ino:137 | `tick()` calls `display::show()` itself in SHOW_POSITION/LOST_HUB/UNASSIGNED every pass, and `loop()` calls it again → two 13.7 ms strip writes per 16 ms loop ⇒ ~23 Hz, not 60. SHOW_POSITION also re-renders the glyph every tick. | Remove all `display::show()` from `tick()`; render on state entry or when a `dirty` flag is set; `loop()` paces one `show()` at ≤60 Hz (`EVERY_N_MILLIS(16)` or the existing `delay(16)` with a `millis()` guard instead of a blocking delay). |
| S1-28 | major | node.cpp:35-54 | DISCOVER: no dim/pulsing render of the remembered digit or "?" (only drawn once in `begin()`); the 15 s timeout is measured from `lastShowTime` (= 0 at boot) instead of DISCOVER entry; log line lacks `pos=`. HELLO jitter is recomputed with `random()` on every tick, so the comparison target jumps around. | Record `stateEnteredAt` on every transition and use it for DISCOVER_TIMEOUT and SHOW_POSITION_MIN. Compute `nextHelloAt = now + HELLO_INTERVAL + random(-HELLO_JITTER, HELLO_JITTER+1)` once per send. Render in `tick()`: `renderDigit/renderChar('?')` with a brightness-scaled colour (see S1-34). |
| S1-29 | major | node.cpp:98-113, 148-152 | Transition logs hard-code the previous state (`DISCOVER -> SHOW_POSITION`, `RUNNING -> UNASSIGNED`) even when entered from LOST_HUB/RUNNING/DISCOVER. `ASSIGN pos=0` goes straight to UNASSIGNED without the "!" for 3 s (plan §3.4). `SETPOS` not handled. | One `setState(NodeState s)` helper that logs `[NODE] %s -> %s pos=%d` using a name table and stamps `stateEnteredAt`. For pos 0: `showBang = true; setState(SHOW_POSITION)` then UNASSIGNED after 3 s. Add `case SETPOS: pos=newPos; save; ACK; setState(SHOW_POSITION)`. |
| S1-30 | major | node.cpp:154-165 | `c`/K1-long sends a HELLO, not a `CLAIM`. FORGET (K2 long: send FORGET, clear NVS, UNASSIGNED) absent. No button gestures registered anywhere (K1 long CLAIM, K2 long FORGET; hub K3 long RESETORD, K2 long IDENTIFY). Bench boards have no buttons so A2–A7 are unaffected, but brief item 7 lists them. | `onClaim`: send `Hdr{CLAIM}` broadcast (hub treats CLAIM like HELLO with nvsPos 0), then `setState(DISCOVER)` (DISCOVER's HELLO loop takes over). Register gestures in `hub::begin()` / `node::begin()` via `buttons::onLong(K3_PIN, hub::onResetOrd, 3000)` etc. |
| S1-31 | major | node.cpp:64-70, 125-128 | LOST_HUB → RUNNING on any Show is right, but the LOST_HUB HELLO (0.2 Hz) will make the hub re-ASSIGN, pushing the node through SHOW_POSITION for 3 s on every hub reboot (A4 says RUNNING within 1 s of the first Show). Also no corner-dot clear on recovery. | On ASSIGN with `newPos == pos` while in LOST_HUB or RUNNING: ACK, do **not** change state. `setCornerDot(false, …)` on LOST_HUB exit; `setCornerDot(true, dimRed)` on entry (once). |
| S1-32 | minor | node.cpp:131-136 | In RUNNING a Show with `pos > numBoards` renders black — fine — but RUNNING never re-renders the position digit "hub colour if a Show is known else green" in SHOW_POSITION. `h.srcPos` is always 0 on HELLO (correct) but HB is never sent (plan: every 3 s staggered `pos*300 ms`). | SHOW_POSITION colour = `haveShow ? CRGB(r,g,b) : CRGB::Green`. Add HB every `HB_INTERVAL + pos*300` in RUNNING (small, unicast, no ACK) — 10 lines, lets the hub's `s` list online boards. |

### Display (`display.*`)

| ID | Sev | File:line | Problem | Required fix |
|---|---|---|---|---|
| S1-33 | major | display.cpp:41-56 | `renderDigit(10)` renders `'0'` ("not implemented fully" comment). `PATTERN_TEN` exists as code 15. | `renderChar(pos == 10 ? (char)15 : (char)('0' + pos), color, mirror);` and `'!'`/`'?'` passthrough for 0/>10 as the caller decides. |
| S1-34 | major | display.cpp:27-39 | Mirror handling is wrong: line 35 replaces the **serpentine LED index** with a non-serpentine one when `mirror` is set, scrambling odd rows. Mirroring must flip the *pattern* column, not the wiring. | `int pc = mirror ? col : (MATRIX_WIDTH-1-col); int bi = row*MATRIX_WIDTH + pc; int li = (row%2==0) ? row*MATRIX_WIDTH+col : row*MATRIX_WIDTH+(MATRIX_WIDTH-1-col);` — keep `li` identical to `espnow_ping`. Factor `static inline int ledIndex(row,col)` and use it in `setCornerDot` too (row 0 is even so `19` is right today only by luck). |
| S1-35 | major | display.cpp:78-84 | `pulseDim()` modulates **global** `FastLED.setBrightness`, so it fights the configured brightness, persists after leaving DISCOVER/UNASSIGNED, and `brightness` is a `uint8_t` compared `< 25` after a signed step (works, but fragile). | Return a scale instead: `uint8_t pulseLevel()` from `beatsin8(20, 64, 255)` and apply it to the colour: `CRGB c = base; c.nscale8(pulseLevel());` before `renderChar`. Never touch global brightness outside `begin()`/K4. |
| S1-36 | major | display.cpp:64-76 | `identifyFlash()` is a 2 s blocking sequence of `delay()` + `FastLED.show()`; called from the RX path (S1-26). | Replace with state: `void identifyStart(uint16_t ms)` sets `identifyUntil`; `bool identifyActive()`; `tick()` renders white/black alternating on `(millis()/250)&1` while active, then re-renders the normal content. |
| S1-37 | minor | display.cpp:14-25, 86-88 | `bootAnimation()` blocking is acceptable in `setup()` only (plan §3.2 says 300 ms flashes — fine). `display::show()` wrapper is fine but not rate-limited. | Keep `bootAnimation()` in `setup()`; add `void render()`/dirty flag so `loop()` calls `show()` only when something changed or at most every 16 ms. Call `FastLED.setMaxRefreshRate(0)` in `begin()` (plan §5.3). |

### Buttons (`buttons.*`)

| ID | Sev | File:line | Problem | Required fix |
|---|---|---|---|---|
| S1-38 | minor | buttons.cpp:25-46 | "Debounce" discards any press shorter than 200 ms (quick taps lost) and does no edge filtering; after a long-press fires, `pressed=false` but release still updates `lastState` — OK. `std::vector` is fine (4 entries, allocated once at init) — note only. `heldAtBoot` is fine: INPUT_PULLUP → unconnected pin reads HIGH → returns in ~100 ms; it only blocks 3 s when actually held. | Implement v4-style debounce: accept a state change only after it is stable for 30–50 ms, then short press = release before `longMs`. Reserve `buttons.reserve(4)` in `begin()`. |
| S1-39 | minor | buttons.cpp:71-80, .ino:82-88 | `role` is still its default `0` when `heldAtBoot(K4)` toggles it, so the gesture always produces HUB instead of toggling the saved role. | `role = storage::loadRole();` **before** the gesture check, then `role ^= 1` if held. |

### Sketch (`LED_Sign_Mesh.ino`)

| ID | Sev | File:line | Problem | Required fix |
|---|---|---|---|---|
| S1-40 | major | .ino:96-124 | Serial `H`/`N` wait runs **after** radio init, `hub::begin()`'s 3 s delay and `netTask` creation, then `ESP.restart()`s. On the bench that is ~10 s after reset before the window even opens (0.8 + 1.8 anim + 1.8 anim again + 3 s "1" + …), and `serial_capture.py <port> 8 H` may miss it; and every role change costs a second boot. Brief item 9 / `espnow_ping::pickRole()`: wait **before** radio/role init, no restart needed. | Order in `setup()`: Serial → storage → buttons → display → bootAnimation → `role = loadRole(); if (heldAtBoot(K4)) toggle+save+show H/N+restart;` → **3 s serial H/N window (save, continue, no restart)** → `radio::beginX(); x::begin();` → `radio::setHandler(x::handlePacket)` → create `netTask`. |
| S1-41 | major | .ino:22-57 | `s` prints only role/pos/nextPos/heap/channel: missing state name, table dump, `channelOk()`, uptime (A7 needs uptime). Node `s` prints state as an int. `t` uses `Serial.readStringUntil('\n')`, which blocks `loop()` up to the 1 s Serial timeout. `m` does not update `hub::mirror`. Commands `r/i/t` exist only for hub, `c` for node — correct — but there is no `?` echo for unknown keys. | Build a line buffer in `handleSerial()` (accumulate until `\n`, non-blocking), then dispatch on `line[0]`. `s` prints: `role, pos, state=<name>, nextPos, table (MAC -> pos for pos!=0), heap, minHeap (`ESP.getMinFreeHeap()`), channel + channelOk, uptime s`. |
| S1-42 | major | .ino:126-139 | `loop()` uses `delay(16)` and calls `display::show()` unconditionally; combined with S1-27 the frame rate is ~23 Hz and `buttons::poll()`/serial run at that rate too. | `static uint32_t lastShow; if (millis()-lastShow >= 16) { lastShow = millis(); display::show(); }` and `delay(1)` (or `yield()`) at loop end. |
| S1-43 | minor | .ino:1-7 | Redundant includes (`esp_now.h`, `esp_wifi.h`, `esp_mac.h`, `Preferences.h`) in the sketch; harmless. `#include <FastLED.h>` before `config.h` also meant the `FASTLED_RMT5` define would not even have applied in that TU. | Trim to `config.h`, `radio_espnow.h`, `storage.h`, `display.h`, `buttons.h`, `hub.h`, `node.h`, `<WiFi.h>` (for `WiFi.channel()` in `s`). |
| S1-44 | minor | .ino:18-19 | `role` is `uint8_t` with magic 0/1 across four files. | `enum class Role : uint8_t { NODE=0, HUB=1 };` in `config.h`, used by storage/hub/node/.ino. |

### Cross-cutting / scope

| ID | Sev | File:line | Problem | Required fix |
|---|---|---|---|---|
| S1-45 | minor | node.cpp:10-13, hub.cpp:10-14 | `state`, `pos`, `lastShowTime`, `lastShowSeq`, `table[]`, `nextPos` are written from the RX handler (core 0) and read in `tick()` (core 1) with no `volatile`/critical section. 32-bit aligned loads/stores are atomic on Xtensa so this mostly works, but multi-field updates (e.g. `latestShow` copy) can tear. | Mark scalars `volatile`; for the 40 B `Show` copy use a `portMUX_TYPE` spinlock (`portENTER_CRITICAL(&mux)`) or a FreeRTOS queue of length 1 drained in `tick()`. |
| S1-46 | minor | (missing) | Brief out-of-scope line asks for a `battery::readMilliVolts()` **stub** returning 0 — absent (`vbat_mV = 0` inlined). `STATUS_PIN 5` defined but no status LED behaviour (plan §5.5: 1 Hz DISCOVER / solid RUNNING / fast LOST_HUB) — low cost, worth adding in `tick()`. | Add `battery.h` with `namespace battery { inline uint16_t readMilliVolts() { return 0; } }`. Toggle `STATUS_PIN` in `node::tick()`/`hub::tick()` from state. |
| S1-47 | minor | hub.cpp:66 etc. | `Assign.h.flags = 1` (needsAck) is set by hand while `radio::send(..., true)` also carries `needsAck` — two sources of truth. | `radio::send()` sets/clears bit0 from its `needsAck` argument. |
| S1-48 | minor | radio_espnow.h:14 / .ino:106 | `netTask` 8192-byte stack with `Serial.printf` + NVS writes in handlers (`storage::saveTable` from `onHello`) is adequate; `delay(5)` in the task is correct (`vTaskDelay`). Hub-collision CONFLICT state (plan §2.1) not implemented — defer, but log `[HUB] other hub heard <MAC>` if a Show arrives on the hub. | Keep 8192; add `UBaseType_t hw = uxTaskGetStackHighWaterMark(nullptr)` to the `s` output once for the soak. |

## Refactor plan (ordered)

**Stage 1 — make it compile (S1-01…S1-08).** Delete `FASTLED_RMT5`; `fill_solid`; brace the `switch` cases and hoist `now`/`lastHelloMs`; `radio::BCAST` constant; move `character_patterns.h` include into `display.cpp`; `prefs.begin(ns, false)` in all save/clear paths; remove the duplicate `display::begin()/bootAnimation()` from `hub::begin()/node::begin()`. Rebuild; expect a clean link.

**Stage 2 — radio plumbing (S1-09…S1-13, S1-47).**
- `radio.h` public API: `bool beginHub(); bool beginNode(); void setHandler(RxHandler); bool send(const uint8_t* mac, uint8_t* buf, uint8_t len, bool needsAck); void ackReceived(const uint8_t* mac, uint16_t ackSeq); void addPeer(const uint8_t* mac); void pump(); bool channelOk(); const uint8_t* myMac(); extern const uint8_t BCAST[6];`
- `send()` stamps `seq = ++txSeq` and the needsAck flag, copies into the queue (always). `pump()`: (1) drain RX ring → `lastSeq[mac]` dedupe → `handler(mac, buf, len)`; (2) if `!sendBusy` and queue non-empty and (first send or `now - lastSend >= 200`): `esp_now_send`, `sendBusy = true`, `retries++`; non-ACK items pop in `onSent`, ACK items pop in `ackReceived()` or after 5 tries (log `[RADIO] give up <MAC> type=%d`).
- `onRecv` only copies into the ring (already correct). `onSent` only clears `sendBusy` and pops/marks the **head**.

**Stage 3 — hub behaviour (S1-17…S1-24).** `HubState` + non-blocking 3 s SHOW_POSITION; `handlePacket()` switch (HELLO/CLAIM → `onHello` + `addPeer` + Show burst; ACK → `radio::ackReceived`; HB → `lastSeen`; FORGET → free slot). Table as an unordered set with `owned()`; accept unused `nvsPos`; `nextPos` skip loop; full → `ASSIGN{0}` + log. Show builder: `showSeq`, 3-shot burst scheduler, periodic flag, full 40 B frame. `onResetOrd` sends `RESETORD` 5× non-blocking and clears RAM+NVS. Hub renders `testString[0]` and logs it.

**Stage 4 — node behaviour (S1-25…S1-32).** `setState()` with name table + `stateEnteredAt`; `handlePacket()` switch (ASSIGN → store `hubMac`, `addPeer`, ACK, SHOW_POSITION or no-op if same pos while RUNNING/LOST_HUB; SHOW → copy under lock, `lastShowTime`, LOST_HUB→RUNNING; IDENTIFY → `identifyStart`; RESETORD → clear NVS, UNASSIGNED; SETPOS → save, ACK, SHOW_POSITION). `tick()` does all rendering: DISCOVER pulse of digit/"?", SHOW_POSITION digit (hub colour if known), RUNNING `chars[pos-1]`, LOST_HUB corner dot + 0.2 Hz HELLO, UNASSIGNED pulse "?" and **no HELLO**. HB every 3 s + `pos*300`. CLAIM as its own type.

**Stage 5 — display/buttons/sketch (S1-33…S1-44).** `renderDigit(10)` → code 15; mirror flips pattern column via `ledIndex()` helper; `pulseLevel()` colour scaling; non-blocking identify; `setup()` order per S1-40 with the serial window before radio init; non-blocking serial line buffer and full `s` dump; `loop()` paced `show()` only; register the button gestures.

**Stage 6 — polish (S1-45, S1-46, S1-48).** `volatile`/spinlock on shared state; `battery` stub; status LED; stack high-water in `s`.

## Keep as-is

- File/namespace layout (`radio::`, `storage::`, `display::`, `buttons::`, `hub::`, `node::`) and the single-binary role split — matches plan §5.1.
- `protocol.h`: structs, `MsgType`, `PROTO_MAGIC/VER`, `POS_ALL/POS_HUB`, `#pragma pack`, `static_assert` — byte-exact with plan §4.1. Keep `chars[MAX_BOARDS]`.
- `config.h` pin map and timing constants (minus the `FASTLED_RMT5` line); names are sensible and already used consistently.
- ESP-NOW callback signatures and the `onRecv` "copy into ring buffer only" discipline; `beginHub()`/`beginNode()` Wi-Fi mode / `softAP(…, 6, 0, 2)` / `WiFi.disconnect(true,true)` / `esp_wifi_set_channel` / `setSleep(false)` / `esp_now_init` → callbacks → broadcast peer order, `ifidx = WIFI_IF_STA`, `esp_read_mac(…, ESP_MAC_WIFI_STA)` — all match the proven bench sketch.
- Serpentine `li` formula in `renderChar` (identical to `espnow_ping`), `renderChar` returning early on null pattern.
- `storage` namespace split (`sys` / `tbl` / `node`), `TableEntry {mac[6], pos}` blob + `nextPos` key, default `nextPos = 2`; `loadRole/saveRole/loadMirror/saveMirror/loadTable/saveTable/clearTable/loadNodePos/saveNodePos` API names.
- `buttons::onShort/onLong/heldAtBoot` API shape and INPUT_PULLUP init; `heldAtBoot` returning immediately on HIGH (safe on bench boards without buttons).
- `netTask` pinned to core 0, priority 1, 8192 stack, `delay(5)`; `radio::pump()` called from it only.
- Serial command letter set `r i t s m c` and the `[HUB] ASSIGN <MAC> -> pos N (new|known)` log format.
- `hub::setTestString()` padding logic; Show `numBoards = nextPos - 1`.

## Refactor disposition

Refactor agent, 2026-11-08. The draft was rewritten file by file into `firmware/LED_Sign_Mesh/` (clean rewrite of every .cpp/.ino; `protocol.h`, pin map/timings in `config.h`, the storage API and the namespace layout were kept per "Keep as-is"). Build: `arduino-cli compile --warnings all --fqbn esp32:esp32:lolin32:PartitionScheme=no_ota` → 0 errors, 0 warnings, **983183 B flash (46 %), 51912 B RAM (15 %)**. Not flashed; verification agent owns A2–A7.

| ID | Disposition | Note |
|---|---|---|
| S1-01 | fixed | `FASTLED_RMT5` line removed. |
| S1-02 | fixed | `fill_solid()` via `display::fill()`. |
| S1-03 | fixed | node `tick()` rewritten: `now` hoisted, braced cases, file-scope `nextHelloAt`. |
| S1-04 | fixed | `radio::BCAST[6]` constant, no compound literals anywhere. |
| S1-05 | fixed | `character_patterns.h` included only from `display.cpp`; `display.h` exposes `CRGB` via `<FastLED.h>` only. |
| S1-06 | fixed | every `Preferences::begin(ns, false)`. |
| S1-07 | fixed | `loadTable` memsets, checks `getBytesLength()` equals the expected blob size. |
| S1-08 | fixed | `display::begin()`/`bootAnimation()` only in `setup()`. |
| S1-09 | fixed | `radio::setHandler()`; `pump()` dispatches `(srcMac, buf, len, rssi)`. |
| S1-10 | fixed | `radio::send()` stamps `h.seq = ++txSeq`; dedupe is a `lastSeq[MAX_BOARDS+1]` MAC table. Frames with `needsAck` bypass dedupe so a retried ASSIGN is re-ACKed when the first ACK was lost (interpretation). |
| S1-11 | fixed | `radio::ackReceived(mac, seq)` frees the matching queue item; 5× @ 200 ms then `[RADIO] give up`; `isRetry` flag set on retransmits; `onSent` only sets flags, `pump()` resolves the in-flight item. |
| S1-12 | fixed | every send goes through the queue; one frame in flight gated by `sendBusy`; `esp_now_send` only from `pump()`. Queue is a 16-slot set, oldest eligible first, so a waiting ASSIGN retry does not block the periodic Show. |
| S1-13 | fixed | hub `addPeer` on HELLO/CLAIM (idempotent via `esp_now_is_peer_exist`); node learns the hub MAC on first ASSIGN or Show. Broadcast peer added on both roles. |
| S1-14 | fixed | `MAX_FRAME 64`, `static_assert(sizeof(Show) <= MAX_FRAME)`; ring 16 × 72 B, queue 16 × ~90 B. |
| S1-15 | fixed | channel/esp_now_init/broadcast-peer/MAC log lines as in the bench sketch; `begin*()` return `bool`. |
| S1-16 | fixed | all radio internals `static` in the .cpp. |
| S1-17 | fixed | `RESETORD` is its own 8-byte message, 5× / 200 ms via `resetLeft`/`resetNextAt` in `hub::tick()`; RAM + NVS table cleared. |
| S1-18 | fixed | `HubState {BOOT, SHOW_POSITION, RUNNING}`, non-blocking 3 s, logs `[HUB] SHOW_POSITION -> RUNNING`; heartbeat starts in SHOW_POSITION. |
| S1-19 | fixed | `showSeq++` + 3-shot burst (0/60/250 ms) on `t`, `FLAG_PERIODIC` on the 500 ms frame, hub renders `testString[0]` and logs `[HUB] render 'A'`. Burst copies carry distinct `h.seq` (seq is owned by `radio::send`); `showSeq` is the content key. |
| S1-20 | fixed | table is an unordered set with `owned()`, `computeNextPos()` = lowest free ≥ 2 (recomputed, never trusted), nvsPos accepted if free, full → `ASSIGN pos 0` logged. `numBoards` = highest owned position (so an accepted nvsPos 5 is lit even when 2..4 are free). |
| S1-21 | fixed | hub `identifyStart()` on IDENTIFY ALL; wired to K2 long. |
| S1-22 | fixed | Show burst after every ASSIGN; ACK → `radio::ackReceived`; HB → `lastSeen/rssi/vbat` (shown in `s` with online/offline at 10 s); FORGET frees the slot. |
| S1-23 | fixed | always `sizeof(Show)`; node requires `len >= sizeof(Show)`. |
| S1-24 | fixed | `display::mirror` is the only copy, loaded in `setup()`. |
| S1-25 | fixed | node ACKs every ASSIGN/SETPOS (including repeats) after `addPeer(hubMac)`; same-pos ASSIGN while SHOW_POSITION/RUNNING/LOST_HUB changes nothing. |
| S1-26 | fixed | handlers only copy/flag; `node::render()` on core 1 draws from `latestShow` (copied under a `portMUX` spinlock); `FastLED.show()` only in `display::show()` from `loop()`. |
| S1-27 | fixed | no `show()` in tick; `display::show()` paced at 16 ms. |
| S1-28 | fixed | `stateEnteredAt` for DISCOVER/SHOW_POSITION timeouts, `nextHelloAt` jitter computed once per send, pulsing digit/'?' rendered every frame. |
| S1-29 | fixed | `setState()` with name table logs `[NODE] A -> B pos=N`; pos 0 → "!" 3 s → UNASSIGNED; SETPOS handled. |
| S1-30 | fixed | `CLAIM` is its own type; FORGET on K2 long (and serial `f`); gestures registered in `hub::begin()`/`node::begin()`. |
| S1-31 | fixed | same-pos ASSIGN in LOST_HUB/RUNNING does not restart SHOW_POSITION; corner dot is drawn only in the LOST_HUB render path, so it clears on exit. |
| S1-32 | fixed | SHOW_POSITION colour = hub colour if a Show is known else green; HB every 3 s + pos×300 ms in RUNNING. |
| S1-33 | fixed | `renderDigit(10)` → code 15. |
| S1-34 | fixed | `display::ledIndex(row, col, mirror)` used by `renderChar` and `setCornerDot`; mirror flips the pattern column, serpentine wiring unchanged (verified equal to the `espnow_ping` formula). |
| S1-35 | fixed | `pulseLevel()` + `scaled()` (nscale8 on the colour); global brightness set only in `begin()`. |
| S1-36 | fixed | `identifyStart/identifyActive/identifyRender`, 250 ms white/black, no delays. |
| S1-37 | fixed | `setMaxRefreshRate(0)`, boot animation in `setup()` only, paced `show()`. A dirty flag was not added: render() redraws the 400-pixel buffer each frame (~50 µs), which is cheaper than tracking dirtiness across five states. |
| S1-38 | fixed | 40 ms stable-state debounce, short = release before `longMs`, long fires once while held; fixed 4-entry array, no vector. |
| S1-39 | fixed | `role = loadRole()` before the K4 check. |
| S1-40 | fixed | setup order: Serial → storage → buttons → display + bootAnimation → battery stub → K4 toggle / 3 s serial H-N window (save, continue, no restart) → radio → hub/node begin → handler → netTask. |
| S1-41 | fixed | non-blocking line buffer (`t` collects until newline, other letters act at once); `s` prints state name, table with online/offline/rssi/vbat, heap, minHeap, channel + OK, uptime, radio counters, net-task stack high-water. |
| S1-42 | fixed | `loop()` = poll/serial/tick/render + paced `display::show()` + `delay(1)`. |
| S1-43 | fixed | sketch includes trimmed to the module headers + `<WiFi.h>`. |
| S1-44 | fixed | `enum class Role : uint8_t` in `config.h`. |
| S1-45 | fixed | shared scalars `volatile`; `latestShow` and the hub table under `portMUX` spinlocks. |
| S1-46 | fixed | `battery.h` stub; status LED 1 Hz DISCOVER / solid RUNNING / fast LOST_HUB (hub: blink SHOW_POSITION, solid RUNNING). |
| S1-47 | fixed | `radio::send()` owns the needsAck flag bit. |
| S1-48 | partially deferred | stack high-water printed in `s`; `[HUB] other hub heard <MAC>` logged. The CONFLICT state itself (stop transmitting, alternate "H"/"!") is deferred to a later step as the review suggested. |

Interpretations worth a glance during verification:
- Corner dot: "logical (row 0, col 19)" is mapped through `ledIndex()` like a glyph pixel, i.e. it lands at the glyph's top-right as the viewer sees it (physical LED 0 on a normal board, LED 19 on a mirrored one), not at raw LED index 19.
- `Show.brightness` (0..100) is applied by the node as a colour scale; the hub sends 100 in this step.
- After `CLAIM` the node enters DISCOVER but delays its first HELLO by 1 s so the CLAIM's ASSIGN lands first (otherwise the hub logs a second `(known)` ASSIGN straight after the `(new)` one).
- DISCOVER glyph colours: remembered digit green, '?' orange; UNASSIGNED '?' red pulse; LOST_HUB dot dim red (60,0,0).
