Alternating/esp32-LED-sign/docs/reviews/STEP3_REVIEW.md

# Review — Phase 1 step 3 draft (web transport + phone UI, Qwen draft 1)

Reviewed against: `docs/build-briefs/PHASE1_STEP3_web_transport_ui.md` (items 1–9, §4 JSON shape, B1–B10), `docs/PROJECT_PLAN.md` §2.3/2.4/2.5/4.2/4.4/5.2/6.1, the verified step-1 baseline in `firmware/LED_Sign_Mesh/` (`docs/reviews/STEP1_VERIFICATION.md`), and the Symbol Edition UI (`firmware/legacy/LED_Sign_WiFi_Symbol_Edition.ino`). Draft read from the Qwen box at `~/esp32-led-sign/drafts/step3_qwen_v1/`; compile log `build1.log` (stopped at the first `#include`, so it under-reports by a wide margin).

Toolchain: core 3.3.12 / IDF 5.5.5, FastLED 3.10.9, ArduinoJson 7.4.3, core `WebServer`/`DNSServer`/`Preferences`. No async web libraries installed.

What the draft changed vs the verified baseline (by `diff`): **new** `transport.h`, `transport_web.h/.cpp`, `commands.h/.cpp`, `web_page.h`, `web/index.html`, `build_web.py`, `build_web.ps1`; **modified** `LED_Sign_Mesh.ino` (+38 lines). **Byte-identical to step 1**: `config.h`, `protocol.h`, `hub.h`, `hub.cpp`, `node.h`, `node.cpp`, `storage.h`, `storage.cpp`, `display.*`, `radio_espnow.*`. The draft tree also contains a stale `LED_Sign_Mesh/build/` directory (step-1 binary, 40 MB elf/map) that must not be committed.

## Verdict

**NOT MERGEABLE — 19 blocking, 16 major, 12 minor. Items 4 (per-board telemetry), 5 (node/hub styling), 7 (persistence + auto-save) and most of 3 (command semantics) are not implemented; item 2 is written against a library that is not installed and not in the brief.**

The draft does not compile for at least six independent reasons beyond the missing `ESPAsyncWebServer.h`: `storage.h` gained no `sign` namespace API yet `commands.cpp` calls nine `storage::*Sign*` functions; `hub.h` exports nothing new yet `commands.cpp`/`transport_web.cpp` reach into eight `static` hub internals; `web_page.h` (a complete array definition with include guards) is `#include`d *inside* a second array initializer; `JsonDocument&` is bound to a `JsonVariant`; `transport_web.cpp` uses `hub::`/`radio::`/`WiFi` without the headers. Once it compiles, the first thing `transport_web::begin()` does is call `WiFi.softAP(ssid, pass)` **a second time with the default channel (1)**, which moves the AP off channel 6 and makes every node deaf — a direct regression of verified A2–A6. `setCommandHandler()` is never called, so every `POST /cmd` would answer `{"ok":false,"err":"hub_only"}`. The page has a SpiderMonkey-only expression-closure syntax (`function(x) x.classList…`) on four lines, which is a `SyntaxError` in Chrome and Safari, so **no JavaScript on the page runs at all** (B8 fails at load). Swatches do not POST, sliders do not POST, `loadState()` and `#boardsCount` do not exist.

The good parts: the file split matches plan §5.1; `symbolCode()` maps all 12 tokens correctly (1–10, 13, 14); the captive-portal URL list is complete; `build_web.py` produces the brief's header format with size/sha1 comment; the page is 15.5 kB (≤ 40 kB), dark by default, has the four tabs, a working `insertSymbol()` with the correct `{token}` strings, a toast, and `focusin`/`focusout` poll pausing. These should be kept (see "Keep as-is").

## Findings

Severity: **blocking** = will not compile, regresses verified step-1 behaviour, or defeats B1–B4 outright; **major** = a brief item or B5–B10 fails; **minor** = quality/robustness.

### A. Compile blockers (B1)

| ID | Sev | File:line | Problem | Required fix |
|---|---|---|---|---|
| S3-01 | blocking | transport_web.h:6, transport_web.cpp:4-5 | `#include <ESPAsyncWebServer.h>`, `<ESPmDNS.h>`, `<lwip/opts.h>`. Async lib not installed and not in the brief (item 2: core `WebServer` + `DNSServer`). mDNS and lwip are unused. | `#include <WebServer.h>` and `#include <DNSServer.h>` in transport_web.cpp only (not in the header, not in the .ino). `static WebServer server(80); static DNSServer dns;`. Delete the mDNS/lwip includes. |
| S3-02 | blocking | transport_web.cpp:14-16 | `static const char INDEX_GZ[] PROGMEM = { #include "web_page.h" };` — web_page.h is a *complete* translation unit fragment (`#ifndef WEB_PAGE_H … const uint8_t WEB_INDEX_GZ[] PROGMEM = {…}; const size_t WEB_INDEX_GZ_LEN = …`). Including it inside a brace initializer is a syntax error. | `#include "web_page.h"` at file scope in transport_web.cpp (the only TU that may include it) and use `WEB_INDEX_GZ` / `WEB_INDEX_GZ_LEN` directly. Delete `INDEX_GZ`/`INDEX_GZ_LEN`. |
| S3-03 | blocking | commands.cpp:34,39,62,65,81,90,125,135,143,152; transport_web.cpp:61; .ino:177 | `storage::saveSignColor/saveSignRainbow/loadSignRainbow/saveSignBrightness/saveSignFx/saveSignBoards/saveSignMsg/saveApSsid/saveSignConfig()/loadSignConfig(JsonDocument&)` — none exist; `storage.h/.cpp` are unchanged from step 1. `saveSignConfig()` (no args) and `loadSignConfig(cfg)` also disagree on what the API is. | Add the `sign` namespace API to storage (design in Refactor plan §R3): `loadSign(SignState&)`, `saveSign(const SignState&)`, `loadSsid(char*,size_t)`, `saveSsid(const char*)`. One struct, one blob, not nine keys with nine Preferences opens. |
| S3-04 | blocking | commands.cpp:30-33,48,64,79-80,89,99,111-126,163-176,226-240; transport_web.cpp:66-86 | References `hub::showColor`, `hub::showBrightness`, `hub::showEffect`, `hub::showEffectPeriodMs`, `hub::numBoards`, `hub::testString`, `hub::showSeq`, `hub::table`, `hub::lastSeen`, `hub::lastRssi`, `hub::highestOwned()`, `hub::scheduleBurst()`, `hub::onForget(mac)`. All are `static` in hub.cpp (or do not exist); `hub.h` is unchanged. | Do **not** export the internals. Give hub.h a small thread-safe API (Refactor plan §R2): `void applySign(const SignState&)`, `SignState sign()`, `void buildState(JsonObject)`, `bool identifyPos(uint8_t,uint16_t)`, `bool forgetPos(uint8_t)`, `uint8_t numBoardsEffective()`. commands.cpp talks only to that. |
| S3-05 | blocking | transport_web.cpp:64,108 (`JsonDocument& s = state["state"]`), commands.cpp:154 (`JsonDocument& s = reply.createNestedObject("state")`) | A `JsonDocument&` cannot bind to a `JsonVariant`/`JsonObject`. Hard error. | `JsonObject s = state["state"].to<JsonObject>();` (ArduinoJson 7). |
| S3-06 | blocking | transport_web.cpp (whole file) | Uses `hub::`, `radio::macToStr`, `storage::TableEntry`, `WiFi`, `IPAddress`, `MAX_BOARDS` without `#include "hub.h"`, `"radio_espnow.h"`, `<WiFi.h>`. `AsyncWebServerRequest` etc. vanish with S3-01. | Include what is used; rewrite handlers for `WebServer` (S3-10/11/12). |
| S3-07 | blocking | commands.cpp:210 | `makeHdr(FORGET, 1, 0)` / `Hdr` / `radio::send` used without `#include "protocol.h"`; also `WiFi.softAPConfig` (line 136) without `<WiFi.h>`. | Include `protocol.h`; but the whole block moves into `hub::forgetPos()` (S3-25), so commands.cpp should not touch the radio at all. |
| S3-08 | major | transport_web.cpp:49,71-73,75; commands.cpp:26,35,40,59,181-186,191,205,225-239; .ino:114 | `containsKey()`, `createNestedArray()`, `createNestedObject()` are deprecated in ArduinoJson 7.x and emit `-Wdeprecated-declarations` warnings — B1 requires 0 warnings. | `cmd["x"].is<const char*>()` / `.is<int>()` for presence+type checks (this also fixes the null-`const char*` crashes in S3-20); `doc["boards"].to<JsonArray>()`, `arr.add<JsonObject>()`. |
| S3-09 | major | transport_web.cpp:21 (`handleRoot`), 70-71 | `beginResponse_P`, `req->client()->remoteIP()` are Async-only. | `server.sendHeader("Content-Encoding","gzip"); server.sendHeader("Cache-Control","no-store"); server.send_P(200, "text/html", (const char*)WEB_INDEX_GZ, WEB_INDEX_GZ_LEN);` and `server.client().remoteIP()`. |

### B. Transport (item 2) — behaviour and regressions

| ID | Sev | File:line | Problem | Required fix |
|---|---|---|---|---|
| S3-10 | blocking | transport_web.cpp:100-102 | `WiFi.softAPConfig(...)` + `WiFi.softAP(AP_SSID, AP_PASS)` **after** `radio::beginHub()` already brought the AP up with `softAP(ssid, pass, ESPNOW_CHANNEL, 0, 2)` (radio_espnow.cpp:103). The 2-arg overload defaults to **channel 1** and max_conn 4: the AP re-starts on channel 1, ESP-NOW peers stay on 6, `channelOk()` reports MISMATCH, nodes never see another Show → LOST_HUB. Regresses A2–A6 (B2 "node unchanged behaviour" fails). | **Delete both lines.** `transport_web::begin()` must not touch Wi-Fi mode/AP; it only reads `WiFi.softAPIP()` for the log line. The SSID from NVS is passed into `radio::beginHub(const char* ssid)` instead (S3-29). |
| S3-11 | blocking | transport_web.cpp:118-121, 131-133 | `setCommandHandler()` is never called by anyone; `cmdHandler == nullptr` → every POST returns `{"ok":false,"err":"hub_only"}`. B4 fails entirely. Also `transport.h` declares a `namespace transport` with the four functions, but nothing implements it (the implementation is `namespace transport_web`) — the "abstract interface" of item 1 is a header nobody can link against. | In `setup()` (hub branch): `transport_web::setCommandHandler(commands::handle); transport_web::begin();`. For item 1, make `transport.h` a struct of function pointers or an abstract class (`struct Transport { virtual void begin()=0; virtual void poll()=0; virtual void sendEvent(const char*)=0; virtual void setCommandHandler(CmdHandler)=0; };`) and `transport_web` provides `Transport& transport_web::instance()`. The .ino holds `Transport* transport`. Phase 3 then adds `transport_ble` without touching the .ino beyond one line. |
| S3-12 | blocking | transport_web.cpp:111-115 | `r->send(302, "Location", "/")` — that is `send(code, contentType, body)`: Content-Type `Location`, body `/`, **no Location header**. B3 expects `302` with `redirect_url http://192.168.4.1/`. Relative `/` would also be wrong for the captive-portal probes (iOS CNA wants an absolute URL). | One helper: `static void redirectRoot(){ server.sendHeader("Location", "http://192.168.4.1/", true); server.send(302, "text/plain", ""); }` registered for `/generate_204`, `/hotspot-detect.html`, `/connecttest.txt`, `/ncsi.txt`, `/fwlink`, and as `server.onNotFound(redirectRoot)` so Android `connectivitycheck.gstatic.com/generate_204` variants and Windows `redirect` probes also land on the page. |
| S3-13 | blocking | transport_web.cpp:33-55 (`handleCmd`) | Written for the Async body-chunk callback. With `WebServer` the body is `server.arg("plain")`. No body size limit (unbounded `String body +=`). JSON parse error returns `bad_json`, which is not in the brief's error set. `reply["ok"]` is **never set to true** on success anywhere (commands.cpp sets only `err`), so a successful `msg` answers `{"text":"OK"}` — the UI's `if(!d.ok) showToast(...)` then toasts an error for every success. | `void handleCmd(){ const String& body = server.arg("plain"); if (body.length() > CMD_MAX_BODY /*512*/) { server.send(413, ...); return; } JsonDocument cmd, reply; if (deserializeJson(cmd, body)) { reply["ok"]=false; reply["err"]="bad_cmd"; } else { bool ok = handler ? handler(cmd, reply) : false; reply["ok"] = ok; if (!ok && reply["err"].isNull()) reply["err"]="bad_cmd"; } String out; serializeJson(reply, out); server.send(200, "application/json", out); Serial.printf("[WEB] POST /cmd %.120s -> %s\n", body.c_str(), out.c_str()); }`. Document in the verification notes that `bad_cmd` is HTTP 200. |
| S3-14 | blocking | transport_web.cpp:57-89 (`handleState`), commands.cpp:151-179 (`get`) | Two hand-rolled copies of the state builder, both reading `hub::table/lastSeen/lastRssi/testString` **directly from core 0 with no lock** while `handlePacket` (also core 0, fine) and `onResetOrd` (core 1) write them under `tMux`. Both ignore `hub::MY_POS` self entry (hub is not in `table[]` → `boards[]` never contains pos 1, so `self:true` never appears — B5 fails). `mv` hard-coded 0 (acceptable this step, but `lastVbat` exists). `char` emits the raw code byte (e.g. `\u0001`) for symbols. `age` for a never-seen board is `millis()/1000`. `cfg` is read back **from NVS on every poll** (`storage::loadSignConfig`) — a Preferences open/read/close at 2 Hz on core 0, and it reports the *saved* config, not the live one (wrong until auto-save fires). | One `hub::buildState(JsonObject root)` (Refactor plan §R2) that (a) copies the table + telemetry under `tMux` into a local array, releases the lock, then serialises; (b) emits the hub itself first as `{pos:1,id,mac,self:true,online:true,age:0,mv:0,rssi:0,char}` using `radio::myMac()`; (c) `char` = printable string: ASCII ≥ 32 → that char, code 1–14 → the `{token}` name, 0 → `""`; (d) `online = lastHb != 0 && now-lastHb < OFFLINE_AFTER_MS`, `age = lastHb ? (now-lastHb)/1000 : -1`; (e) `cfg` from the live `SignState` in RAM. `get` and `/state` both call it. |
| S3-15 | major | transport_web.cpp:123-126 (`poll`) | No `server.handleClient()` (nothing serves HTTP with the core `WebServer`). `WiFi.softAPgetStationNum()` is called every 5 ms (it walks the AP station list via `esp_wifi_ap_get_sta_list`). `dnsServer.setTTL`/`onQuery`: `onQuery` does not exist in the core DNSServer (compile error). | `poll(){ server.handleClient(); dns.processNextRequest(); if (millis()-lastStaAt >= 1000) { lastStaAt = millis(); staCount = WiFi.softAPgetStationNum(); } }`. `dns.start(53, "*", IPAddress(192,168,4,1));` only (the 3.x DNSServer is AsyncUDP-based; `processNextRequest()` is a compatibility no-op but harmless). |
| S3-16 | major | transport_web.cpp:10-12, 29-30, 88-89 | `lastClientIPVal` is a `String` written on core 0 (handlers) and read on core 1 (`w`); `reqCountVal` is a plain `uint32_t`. `String` assignment is not atomic → occasional garbage/crash on `w`. | `static volatile uint32_t reqCount; static volatile uint32_t lastClientIp;` (store `(uint32_t)server.client().remoteIP()`), format on read with `IPAddress(lastClientIp).toString()`. |
| S3-17 | major | transport_web.cpp (missing) | `GET /state` is not logged (brief says log each request; at 2 Hz this would flood). No 404 handling. No `Cache-Control: no-store` on `/state` and `/cmd` (iOS CNA webview caches aggressively). `WiFi.softAPgetStationNum()` exposure exists (`apClients()`), fine. | Log `/cmd` and not-found requests only; add `server.sendHeader("Cache-Control","no-store")` on every JSON reply; `onNotFound` → S3-12 redirect. |
| S3-18 | minor | .ino:19-20 | `<WebServer.h>` / `<DNSServer.h>` included in the sketch for no reason (pulls both into the .ino TU). | Remove; they belong in transport_web.cpp only. |

### C. Commands (item 3) and persistence (item 7)

| ID | Sev | File:line | Problem | Required fix |
|---|---|---|---|---|
| S3-19 | blocking | commands.cpp (whole file) | **Cross-core mutation without handover.** `commands::handle()` runs on core 0 (web poll) and writes `hub::testString`, `showColor`, `showSeq`, etc. while `hub::tick()/render()/sendShow()` read them on core 1 with no lock, no copy. A `memset` + byte loop on `testString` races the 40-byte `memcpy` in `sendShow` → torn Show frames. Step 1 deliberately used the set-flag/copy pattern (`showMux`, `tMux`). | Introduce `struct SignState` (Refactor plan §R1). `hub::applySign(const SignState&)` copies into `pending` under a `portMUX` and sets `pendingFlag`; `hub::tick()` (core 1) swaps it into the live copy, bumps `showSeq`, calls `scheduleBurst()` and arms the auto-save timer. Commands never touch hub statics. |
| S3-20 | blocking | commands.cpp:27-28,70,74-77,95,130,148 | `const char* hex = cmd["hex"]; strlen(hex)` / `strcmp(name,…)` / `strcpy` on a pointer that is **null** when the field is absent or not a string (`{"cmd":"fx"}` → `strcmp(nullptr,"static")` → LoadProhibited panic). `applyMsg` checks `txt` but `applyFx`/`applyColor` do not. | Use `.is<const char*>()` before `.as<const char*>()`; return `bad_arg` otherwise. Pattern: `const char* name = cmd["name"].is<const char*>() ? cmd["name"].as<const char*>() : nullptr; if (!name) → bad_arg`. |
| S3-21 | blocking | commands.cpp:94-127 (`applyMsg`) | (a) Output position is the **source index `i`**, so `{heart}A` puts the heart at pos 1 and `A` at pos 8 (indices 1–7 stay blank). (b) Not uppercased (brief: "uppercase"). (c) Only codes are stored (`saveSignMsg(hub::testString)`) — the original token text is lost, so `cfg.text` returns control bytes and the UI textarea fills with `\u0001`; also strings with `\0` codes… `String(testString)` stops at the first blank. (d) `len>60` silently truncates (fine, but say so in the reply) and the token scan can read past `len` (`strchr(txt+i,'}')` is bounded by the real string, OK, but `tlen` is computed before the `>60` cut). (e) Unknown token `{foo}` emits `{` and then `f o o }` as characters — acceptable only if documented; brief implies unknown tokens pass through literally. | Keep **two** representations in `SignState`: `char text[61]` (the user's original, uppercased, tokens intact — this is what `cfg.text` returns and what is persisted) and `char chars[MAX_BOARDS]` (derived). `static void layoutChars(const SignState& s, char out[MAX_BOARDS])`: `size_t o=0; for (i=0; i<len && o<MAX_BOARDS; ) { if (text[i]=='{') { const char* e = strchr(text+i,'}'); if (e && e-text-i-1 < 16) { code = symbolCode(tok); if (code) { out[o++]=code; i = e-text+1; continue; } } } out[o++] = toupper(text[i++]); }`. Step 2 replaces `layoutChars` with `parseMessageIntoWords`, which is exactly why the raw text must be kept. |
| S3-22 | blocking | commands.cpp:25-67 (`applyColor`, `effectiveBri`, `applyBri`) | (a) `rainbow:true` sets the colour to red and **never sets `effect=3`** (brief: rainbow → `effect=3`); `storage::saveSignRainbow` is a separate flag with no consumer in the Show. (b) `if (reply.containsKey("color")) reply["color"]=…` is inverted — never echoes. (c) `applyBri` stores the **capped** value as `bri`, so `cfg.bri` and `cfg.briEff` are the same number and the user's requested brightness is lost; changing the colour to white afterwards never re-caps (B4: `bri 100` then `color FFFFFF` must yield `briEff 60` — with this code it stays 100). (d) `effectiveBri` classifies by exact `r==g==b` for white and `nonZero` count: `FFFFFE` → 3 non-zero, not equal → cap 100 (should be 60); `FFA500` (legacy Orange, 3 non-zero) → 100 (v4 says dual 80). (e) `hex` validation is `strlen==6` only; `"GGGGGG"` → `strtoul` returns 0 → black, `ok:true`. UI sends `#RRGGBB` (7 chars) → `bad_arg` every time. | Store `bri` (requested 0–100) and `rainbow` in `SignState`; compute `briEff` in one function used by both the reply and `sendShow`: `uint8_t capFor(const SignState& s){ if (s.rainbow) return 70; int ch = (s.r>=64)+(s.g>=64)+(s.b>=64); return ch>=3 ? 60 : ch==2 ? 80 : 100; }` `briEff = min(bri, cap)`. Threshold 64 (25 %) reproduces v4's named categories (Orange FFA500 → 2 channels → 80; Pink FFC0CB → 3 → 60 is the one deviation, acceptable and deterministic — note it in the reply). Validate hex: accept optional leading `#`, then exactly 6 `isxdigit`. `rainbow:true` → `s.rainbow=true; s.effect=3`; `hex` → `s.rainbow=false; if (s.effect==3) s.effect=0`. |
| S3-23 | major | commands.cpp:69-84 (`applyFx`) | `speed` missing → 0 → `bad_arg` (should default to current `effectPeriodMs`); `name` null crash (S3-20); setting `fx=cycle` does not set `rainbow`, and `rainbow` does not set `fx` — two sources of truth for the same thing. | `effect` is the single truth: `rainbow == (effect==3)`. `fx` with `name:"cycle"` sets `rainbow=true`; `fx` with any other name clears it. `speed` optional, range 100–2000 else `bad_arg`. |
| S3-24 | major | commands.cpp:86-92 (`applyBoards`), 142-145 (`applySave`) | `n` missing/non-integer → `cmd["n"]` = 0 → "auto", `ok:true` — should be `bad_arg` when the field is absent or not an int. `save` calls a non-existent zero-arg function; nothing implements the **2 s debounced auto-save** (item 3 `save` row, B6). | `if (!cmd["n"].is<int>()) bad_arg; int n = cmd["n"]; if (n<0||n>MAX_BOARDS) bad_arg`. Auto-save: `hub::tick()` keeps `dirtyAt`; when `dirtyAt && now-dirtyAt >= 2000` → `storage::saveSign(live); dirtyAt=0; Serial.println("[HUB] sign saved")`. `save` command → `hub::saveNow()`. NVS writes stay on core 1 (as step 1 did with `persistTable`). |
| S3-25 | major | commands.cpp:190-218 (`identify`, `forget`) | `identify pos N` broadcasts to **all** ("not implemented in step 1 radio" is false — `radio::send(mac,…)` unicast exists and the table maps pos→MAC). `ms` unchecked (`uint16_t` from `cmd["ms"] | IDENTIFY_MS` is fine but 0 or 60000 pass). `forget` for an unknown pos returns `ok:true`; `forget 1` (self) is allowed; the FORGET frame has `dstPos 0`; and the **node has no `case FORGET` in `handlePacket`** (node.cpp:155-200), so the node keeps its NVS position and re-HELLOs with it on next boot → the hub re-accepts it (hub-reflash rule) and the forget is undone. Also runs on core 0 and calls `hub::onForget`, which does `persistTable()` → NVS write on core 0 while core 1 may be writing (`onResetOrd`). | `hub::identifyPos(pos, ms)`: `pos==255` → `onIdentifyAll()`; else look up MAC under `tMux`, `Identify id; id.h = makeHdr(IDENTIFY, MY_POS, pos); id.ms = constrain(ms, 200, 10000); radio::send(mac,&id,sizeof id,false)`; `pos==1` → `display::identifyStart(ms)` only. Return false (→ `bad_arg`) when pos is unknown. `hub::forgetPos(pos)`: reject 1 and unknown; build `Hdr h = makeHdr(FORGET, MY_POS, pos)` and unicast; then free the slot and `persistTable()`. Node: add `case FORGET: if (h->dstPos == myPos && myPos) { Serial.println("[NODE] FORGET from hub"); savePos(0); showBang=false; setState(UNASSIGNED); }`. |
| S3-26 | major | commands.cpp:129-140 (`applyName`) | Calls `WiFi.softAP(buf, AP_PASS)` immediately — same channel-1 regression as S3-10, and the reply says "applies next boot". No SSID validation (empty string, spaces, non-ASCII, >32 bytes). Saves on core 0. | Validate: 1–24 chars, each `isalnum(c) || c=='-' || c=='_'`; else `bad_arg`. `storage::saveSsid(buf)` only; reply `{"ok":true,"name":buf,"note":"applies next boot"}`. **Never** call `softAP` outside `radio::beginHub()`. |
| S3-27 | major | commands.cpp:147-222 (`handle`) | Return-value protocol is inconsistent: `identify/reset_order/forget` set `reply["ok"]=true` themselves, others do not; `hub_only` is produced by the *transport* as a fallback for `ok=false && no err` rather than by the command layer when `role != HUB`. On a node, `commands::handle` would dereference hub state anyway. | `commands::handle` takes a `bool isHub` (or reads a global role) and starts with `if (!isHub && cmd needs hub) { err="hub_only"; return false; }`. Every branch returns `bool` and sets `err` on false; the **caller** writes `reply["ok"]`. `get` is allowed on both roles (node returns its own small state — optional, else `hub_only`). |
| S3-28 | major | commands.cpp:224-241 (`applyConfig`) | Boot restore: `strncpy(hub::testString, cfg["text"], MAX_BOARDS)` — `text` is the token string (if S3-21 is fixed) and must be laid out, not copied; also `cfg["fx"]` is the *name* string in §4 but is assigned to a `uint8_t`. The restore happens in `setup()` **before** `hub::begin()` has run? (see S3-31) and calls `scheduleBurst()` from the .ino. | `hub::begin()` itself does `storage::loadSign(live); layoutChars(live, chars); showSeq++;` — the first periodic Show after SHOW_POSITION carries it, and `scheduleBurst()` once RUNNING. Nothing in the .ino. |
| S3-29 | major | storage (missing), radio_espnow.cpp:103 | AP SSID persistence (item 3 `name`) needs `radio::beginHub()` to take the SSID. | `bool beginHub(const char* ssid)`; `setup()`: `char ssid[33]; storage::loadSsid(ssid, sizeof ssid, AP_SSID); radio::beginHub(ssid);`. Keep `max_conn=2`, channel `ESPNOW_CHANNEL`. |

### D. Node/hub styling (item 5) and HB tracking (item 4)

| ID | Sev | File:line | Problem | Required fix |
|---|---|---|---|---|
| S3-30 | blocking | node.cpp (unchanged), hub.cpp:107-115 (`sendShow`), hub.cpp:291-301 (`render`) | Item 5 is entirely absent. `sendShow` still hard-codes `brightness=100, effect=0, effectPeriodMs=0`; the node render applies `r,g,b` and `brightness` only; there is no hub-clock offset, no blink/fade/cycle anywhere; the hub renders `testString[0]` in `showColor` at full brightness. B4 (`fx blink` → node `apply … fx=1`) and the `[SHOW] seq=… color=… bri=… fx=…` / `[NODE] apply seq=…` log lines do not exist. | Implement per Refactor plan §R4/§R5 (exact code shape given there). |
| S3-31 | major | hub.cpp:28-32, 187-206 (`handlePacket` HB) | Hub tracks `lastSeen/lastRssi/lastVbat` only; `shownChar` from HB is discarded; `lastSeen` is also bumped by HELLO and ACK, so "age = seconds since last HB" is not what is reported. | Extend per Refactor plan §R2: `struct BoardInfo { uint32_t lastHb, lastSeen; int8_t rssi; uint16_t mv; uint8_t shownChar, nodeState; uint16_t lastShowSeq; }` indexed by pos; HB case fills all of it; `/state.age` uses `lastHb`, `online` uses `lastHb` too (brief: "hub marks offline after 10 s" without HB). |

### E. Sketch wiring (items 8, 9) and regressions

| ID | Sev | File:line | Problem | Required fix |
|---|---|---|---|---|
| S3-32 | blocking | .ino:173-180 | `transport_web::begin()` and the config restore are inserted **after** `xTaskCreatePinnedToCore(netTask…)` and after the "Running as" banner — the net task is already calling `transport_web::poll()` → `server.handleClient()`/`dns.processNextRequest()` on objects that have not `begin()`-ed (DNSServer before `start()` is a null-deref in the AsyncUDP path). Plan §5.2 order: radio → transport → hub → netTask. | `if (role==HUB) { radio::beginHub(ssid); transport_web::setCommandHandler(commands::handle); transport_web::begin(); hub::begin(); radio::setHandler(hub::handlePacket); } else {…} xTaskCreatePinnedToCore(...)`. `transport_web::poll()` must also be gated on role inside `netTask` (`if (role==Role::HUB) transport_web::poll();`) — the draft calls it unconditionally on nodes too (line 42), where the `WebServer` was never begun. |
| S3-33 | blocking | .ino:97-119 (serial `{`) | Reads only the bytes **already in the UART FIFO** in one `loop()` pass (`while (Serial.available())`). A 45-byte JSON line at 115200 baud takes ~4 ms to arrive while `loop()` runs every ~1–17 ms, so the line is almost always cut mid-way → "JSON parse error". `lineBuf[32]` is also too small for any realistic command (`{"cmd":"msg","text":"HELLO {heart}"}` is 36 bytes). Reply prints only `ok`/`err`, not the reply document (brief: "reply printed", and B4 checks `briEff`). | Reuse the existing non-blocking collector: `if (c=='{' || c=='t') { collecting = (c=='{') ? JSON : TEXT; lineLen=0; if (c=='{') lineBuf[lineLen++]='{'; continue; }`; on `\n`: if JSON → `deserializeJson`, `commands::handle`, `reply["ok"]=ok`, `serializeJson(reply, Serial); Serial.println();`. `static char lineBuf[256]`. |
| S3-34 | minor | .ino:61,77 | `'w'` prints `web req=… lastIP=… ap=…` — fine. `'s'` adds `web clients=` — fine but it reads `transport_web::apClients()` on a node too (returns the stale 0; harmless once poll is gated). Help string updated. | Gate on role; otherwise keep. |
| S3-35 | minor | .ino:194 | Comment-only change on the `display::show()` line (cosmetic churn). | Revert to keep the diff minimal. |
| S3-36 | minor | draft tree | `LED_Sign_Mesh/build/` (70 MB, step-1 artefacts) is inside the sketch folder. | Delete; add `firmware/**/build/` to `.gitignore`. |
| S3-37 | ok | config.h, protocol.h, radio_espnow.*, display.*, buttons.*, storage.* | Byte-identical to the verified baseline — **no struct-size, role-window, netTask or serial-letter regressions from these files.** The only regressions are S3-10/S3-26 (channel) and S3-32 (init order / poll on node). | — |

### F. Build tooling (item 7)

| ID | Sev | File:line | Problem | Required fix |
|---|---|---|---|---|
| S3-38 | minor | build_web.py:12 | `gzip.compress(data, 9)` embeds the current mtime in the gzip header (bytes 4–7 differ on every run: `32,253,240,106` here) → `web_page.h` changes on every build even when `index.html` did not, and the committed header never matches a clean rebuild. | `buf = io.BytesIO(); with gzip.GzipFile(fileobj=buf, mode='wb', compresslevel=9, mtime=0) as g: g.write(data); gz = buf.getvalue()`. |
| S3-39 | minor | build_web.py:5-6, 24 | Paths are `tools/../web/index.html` → `firmware/LED_Sign_Mesh/web_page.h` (correct now that the script lives in `tools/`; already patched locally). The 4 075 bytes are emitted on **one line**; `#include <Arduino.h>` in a data header is unnecessary. The header's SHA1 is of the *source* (good) but the comment says `Source: /home/qwen/.../tools/../web/index.html` (absolute, machine-specific). | Emit 16 bytes per line (`0x..` form), print the source path relative to the repo root, drop `<Arduino.h>` (use `<stdint.h>`/`<stddef.h>` + `<pgmspace.h>` is implied by Arduino.h in the including TU; simplest: keep the array `const uint8_t … PROGMEM` and rely on the includer). Also run from any cwd: use `Path(__file__).resolve().parents[1]`. |
| S3-40 | minor | build_web.ps1 | `python3 (Join-Path …)` — on Windows the launcher is usually `py -3` or `python`. | `$py = (Get-Command py,python3,python -ErrorAction SilentlyContinue | Select-Object -First 1).Source; & $py (Join-Path $PSScriptRoot 'build_web.py')`. |

### G. Web page (item 6) — defects that break B8

| ID | Sev | File:line | Problem | Required fix |
|---|---|---|---|---|
| S3-41 | blocking | index.html:178,179,200,206 | `forEach(function(x) x.classList.remove('active'))` — expression closure without braces is a **SyntaxError** in V8 and JavaScriptCore (it was a Firefox-only extension, removed in FF 60). The whole `<script>` fails to parse; nothing runs, `window.onload` is never set, tabs do not switch. B8 "no console errors / 4 tabs switch" fails immediately. | `forEach(function(x){ x.classList.remove('active'); })`. |
| S3-42 | blocking | index.html:167 | `loadState()` is not defined → `ReferenceError` in `init()` (after S3-41 is fixed), aborting `setupTabs()`/`setInterval`. | Delete the call; `init()` should call `pollState()` once immediately, then `setInterval(pollState, 2000)`. |
| S3-43 | blocking | index.html:274 | `document.getElementById('boardsCount').value = …` — no such element → `TypeError` inside the poll `.then`, swallowed by `.catch`, so **`renderBoards()` never runs** whenever `cfg.boards` is truthy (always). Boards tab stays empty (B8 "2 board cards" fails). | Add the control (S3-49) or guard with `var el = …; if (el) …`. Generally: never let one missing element kill the whole poll handler. |
| S3-44 | blocking | index.html:205-210, 113-120, 255-258 | Swatch click only sets `state.cfg.color` (and throws `TypeError` before the first poll because `state.cfg` is undefined); it does **not** POST (B8 "colour swatch click POSTs color" fails). `applyLook()` sends `hex` with a leading `#` (firmware rejects: S3-22) and a `rainbow` flag derived from "black swatch = rainbow" hack; with both fields present the firmware takes the `hex` branch → black. No rainbow swatch, no `<input type=color>` `change` handler. | `setColor(hex)`: `sendCmd({cmd:'color',hex:hex.replace('#','')})`; rainbow swatch (CSS `conic-gradient`) → `sendCmd({cmd:'color',rainbow:true})`; `colorPicker.onchange` → same `setColor`. Remove the black swatch and the `applyLook()` batching (three POSTs in one tap); each control sends its own command. |
| S3-45 | major | index.html:124,133,186-197 | Sliders only update the label; brightness/speed are sent only via "Apply Look". Brief: debounce 300 ms and send. No effective-cap display (`briEff` vs requested `bri`). | `var briT; briSlider.oninput = function(){ briVal.textContent = this.value+'%'; clearTimeout(briT); var v=+this.value; briT=setTimeout(function(){ sendCmd({cmd:'bri',v:v}); },300); }`; on reply show `'(effective ' + d.briEff + '%)'` when `d.briEff < v`. Same for speed → `{cmd:'fx',name:currentFx,speed:v}`. Segment click → `sendCmd({cmd:'fx',name:name,speed:+speedSlider.value})`. |
| S3-46 | major | index.html:267-273 | Poll overwrites the Message textarea with `cfg.text` every 2 s even when it differs from what the user typed and then blurred (focus-pause only covers the focused moment); the colour picker is set to `cfg.color` without `#` (invalid value for `<input type=color>` → ignored). Swatch highlight is never synced to `cfg.color`/`cfg.rainbow`. | Only write the textarea when `cfg.text !== lastSentText` **and** the textarea equals the previous cfg value (i.e. the user has not edited it). `colorPicker.value = '#' + cfg.color`. Mark the swatch whose `data-hex` matches, or the rainbow swatch when `cfg.rainbow`. |
| S3-47 | major | index.html:288 | Board card: no `mac`, no `self` marker, no `online/offline` text, `Forget` is offered on **every** board including online ones and the hub itself, with no `confirm()`; card uses `innerHTML` string concatenation with values from the hub (fine for our own JSON, but `b.id` etc. are not escaped). `Reset order` confirm exists (good). `Identify` per board good. | Render: `pos` big, `id` + `mac` small, `rssi dBm`, `age s`, `char`, badge `HUB` when `b.self`, class `online/offline`; `Forget` button only when `!b.online && !b.self`, wrapped in `confirm('Forget board '+b.pos+' ('+b.id+')?')`. Build with `createElement`/`textContent`. |
| S3-48 | major | index.html:91,106,223-226 | Char count is `value.length` / 60; brief: "char-count vs boards" — a `{heart}` counts as 7 and the count is not compared with `state.numBoards`. Send does not uppercase client-side (fine, hub does) and does not trim. | Count *laid-out* characters: `text.replace(/\{[a-z]+\}/g,'#').length` and show `n / boards` with a warning class when `n > state.state.numBoards`. |
| S3-49 | major | index.html:137-144 | Boards tab lacks the "auto / pinned board count" control (item 6). | `<select id="boardsCount">` with `0 = Auto (N)` and `1…10`; `onchange → sendCmd({cmd:'boards',n:+this.value})`; poll fills it from `cfg.boards`/`cfg.boardsAuto` and shows the auto-detected count in the label. |
| S3-50 | major | index.html:146-156 | Settings: `#status` div is never populated (firmware `fw`, `heap`, `uptime`, `clients` missing); AP-name field has no length/charset hint; console shows "Sent: …" but **not the reply** (brief: "reply log"). | In `pollState`: `status.textContent = 'fw '+cfg.fw+' · heap '+state.heap+' · up '+fmt(state.uptime)+' · clients '+state.clients+' · SSID '+cfg.name`. `sendRaw` → a `sendCmd(obj, cb)` variant that appends `JSON.stringify(reply)` to a `<pre>` log (keep last 10). |
| S3-51 | minor | index.html:231 | `headers:{'Content-Type':'application/json'}` — harmless, but the core `WebServer` only exposes the body as `arg("plain")` for non-form content types, so this header is actually *required*; keep it and document it. `fetch` has no timeout → a dead AP hangs the UI silently. | Keep header. Add `AbortController` where available (`if (window.AbortController)`) with a 4 s timeout, else rely on `.catch`. |
| S3-52 | minor | index.html:103-104 | `🙂 🙁` are astral-plane emoji; the old Android WebView on captive-portal pages sometimes lacks colour emoji fonts and shows tofu. Symbol Edition used `:)` / `:(`. | Use `:)` / `:(` text (as the legacy page), or ☺ ☹ (BMP). |
| S3-53 | minor | index.html (whole) | No `<meta name="color-scheme" content="dark">`; `.tab`/`.btn` lack `touch-action: manipulation` (300 ms tap delay in old webviews); `transition` on body is pointless with no theme toggle. The legacy page's dark-mode toggle was not ported — acceptable since dark is default, but note it. | Add the meta; add `touch-action:manipulation` to buttons; drop the transition. |
| S3-54 | ok | index.html:216 | Symbol keypad token strings `{heart}…{sad}` match `commands.cpp::symbolCode()` exactly (12 tokens). No optional chaining, arrow functions, template literals, `let`/`const`, or `async` — webview-safe once S3-41 is fixed. 15 488 bytes uncompressed. `focusin`/`focusout` pause works. | Keep. |

## Refactor plan (ordered)

The hub and node changes (items 4 and 5) do not exist in the draft and must be written from scratch against the verified step-1 files. The design below is prescriptive so the refactor agent does not have to invent it.

### R1. `sign_state.h` (new, ~40 lines)
```cpp
struct SignState {               // the whole user-visible configuration, plain POD, memcpy-able
  char     text[61];             // original message, uppercased, {tokens} intact (<= 60)
  uint8_t  r, g, b;              // base colour
  bool     rainbow;              // == (effect == 3); kept for cfg JSON
  uint8_t  bri;                  // requested 0..100
  uint8_t  effect;               // 0 static 1 blink 2 fade 3 cycle
  uint16_t effectPeriodMs;       // 100..2000
  uint8_t  boards;               // 0 = auto
};
static const SignState SIGN_DEFAULT = { "HI", 0,255,0, false, 100, 0, 500, 0 };
uint8_t  signCap(const SignState& s);                 // 70 rainbow; channels>=64: 3→60, 2→80, else 100
uint8_t  signBriEff(const SignState& s);              // min(bri, cap)
void     signLayout(const SignState& s, char out[MAX_BOARDS]);   // tokens → codes, one char per pos (step 2 replaces)
char     symbolCode(const char* token);               // move from commands.cpp
const char* symbolName(char code);                    // 1..14 → "heart"… (for /state char and cfg)
const char* fxName(uint8_t fx); int fxFromName(const char*);
```
`storage.h`: `void loadSign(SignState&); void saveSign(const SignState&);` — one `putBytes("sign", &s, sizeof s)` in namespace `sign` with a version byte prefix (`SIGN_BLOB_VER 1`) so a layout change in step 2 falls back to defaults instead of reading garbage. `bool loadSsid(char* out, size_t n, const char* def); void saveSsid(const char*);` in `sys`.

### R2. `hub.h/.cpp` additions
Struct for per-board telemetry, replacing the three parallel arrays:
```cpp
struct BoardInfo {               // indexed by pos 1..MAX_BOARDS, zero = never heard
  uint32_t lastHb;               // millis of last HB (age/online)
  uint32_t lastSeen;             // HELLO/ACK/HB (diagnostics only)
  int8_t   rssi;  uint16_t mv;  uint8_t shownChar; uint8_t nodeState; uint16_t lastShowSeq;
};
static BoardInfo info[MAX_BOARDS + 1];   // guarded by tMux like table[]
```
`handlePacket`: `case HB:` → `portENTER_CRITICAL(&tMux); BoardInfo& bi = info[p]; bi.lastHb = bi.lastSeen = millis(); bi.rssi = rssi; bi.mv = hb->vbat_mV; bi.shownChar = hb->shownChar; bi.nodeState = hb->state; bi.lastShowSeq = hb->lastShowSeq; portEXIT_CRITICAL(&tMux);`. HELLO/ACK update `lastSeen` only (and `rssi`). `onResetOrd`/`onForget` zero the entry.

Live sign state and the handover (set-flag/copy pattern, as `node.cpp` does for `latestShow`):
```cpp
static SignState live;                 // core 1 only (tick/render/sendShow)
static char      liveChars[MAX_BOARDS];
static SignState pending; static volatile bool pendingFlag = false;
static portMUX_TYPE signMux = portMUX_INITIALIZER_UNLOCKED;
static uint32_t dirtyAt = 0;           // auto-save timer

void applySign(const SignState& s) {   // any core
  portENTER_CRITICAL(&signMux); pending = s; pendingFlag = true; portEXIT_CRITICAL(&signMux);
}
SignState sign() { SignState c; portENTER_CRITICAL(&signMux); c = pendingFlag ? pending : live; portEXIT_CRITICAL(&signMux); return c; }
// in tick(), first thing:
if (pendingFlag) { portENTER_CRITICAL(&signMux); live = pending; pendingFlag = false; portEXIT_CRITICAL(&signMux);
                   signLayout(live, liveChars); showSeq = showSeq + 1; scheduleBurst(); dirtyAt = millis(); }
if (dirtyAt && millis() - dirtyAt >= 2000) { storage::saveSign(live); dirtyAt = 0; Serial.println("[HUB] sign saved"); }
```
`sign()` reads `live` on core 0 while core 1 may write it on the swap; to keep it strictly safe, do the swap *and* the `live` read both under `signMux` (as shown). `saveNow()` for the `save` command sets `dirtyAt = 1` (forces a save next tick on core 1 — NVS writes stay off the net task).

`sendShow`: `s.r/g/b = live.r/g/b; s.brightness = signBriEff(live); s.effect = live.effect; s.effectPeriodMs = live.effectPeriodMs; s.numBoards = live.boards ? live.boards : highestOwned(); memcpy(s.chars, liveChars, MAX_BOARDS);` and on a non-periodic send: `Serial.printf("[SHOW] seq=%u color=%02X%02X%02X bri=%u fx=%u\n", …)` (B4).

`uint8_t numBoardsEffective()`; `bool identifyPos(uint8_t pos, uint16_t ms)`; `bool forgetPos(uint8_t pos)` (S3-25); `void buildState(JsonObject root)` (S3-14) — copies `table[]` and `info[]` under `tMux` into locals, then writes `cfg` (from `sign()`; `briEff`, `fx` name, `boardsAuto = boards==0`, `name` from the SSID the radio started with, `fw`) and `state` (hub first with `self:true`, then table entries sorted by pos). `char` for a node = `info.shownChar` (what the node *reports*), for the hub = its own rendered char; printable via `symbolName()` → `"{heart}"`, else the 1-char string, else `""`.

`render()` uses the shared styling function (R4) with `live` and `hubNow() = millis()`.

### R3. `storage.h/.cpp` — as R1. Keep every other function untouched.

### R4. `display.h/.cpp` — one styling function shared by hub and node
```cpp
// Applies effect/brightness to a base colour for the current hub-clock time. Pure; no FastLED calls.
CRGB styled(uint8_t r, uint8_t g, uint8_t b, uint8_t bri /*0..100 already capped*/,
            uint8_t effect, uint16_t periodMs, uint32_t hubNowMs);
```
Body: `if (periodMs < 50) periodMs = 500;` then
- 0 static: `c = CRGB(r,g,b)`.
- 1 blink: `if ((hubNowMs / periodMs) & 1) return CRGB::Black; c = CRGB(r,g,b)`.
- 2 fade: `uint32_t ph = hubNowMs % periodMs; uint32_t tri = ph < periodMs/2 ? ph : periodMs - ph; uint8_t lvl = 77 + (uint32_t)178 * tri / (periodMs/2);` (30–100 % → 77–255) `c = CRGB(r,g,b); c.nscale8(lvl)`.
- 3 cycle: `uint8_t hue = (uint8_t)((hubNowMs / periodMs) * 5); c = CHSV(hue, 255, 255)`. (Plan §4.2 literal formula; at `periodMs = 500` the hue steps every 500 ms — acceptable for this step; a smoother `hubNowMs * 256 / (periodMs * 51)` can replace it later without a protocol change.)
- then `c.nscale8((uint16_t)bri * 255 / 100)`; return.
`identifyActive()` still wins in both `render()`s (unchanged order).

### R5. `node.cpp` — hub clock and render
```cpp
static int32_t  hubOffset = 0;   static bool hubOffsetInit = false;
static uint32_t hubNow() { return millis() + (uint32_t)hubOffset; }
// in onShow(), after the memcpy under showMux (core 0; offset is a single int32 write → use volatile):
int32_t sample = (int32_t)(s->hubMillis + 2 - millis());
if (!hubOffsetInit) { hubOffset = sample; hubOffsetInit = true; } else hubOffset += (sample - hubOffset) / 4;
```
`render()` RUNNING / LOST_HUB / SHOW_POSITION colour: `CRGB col = display::styled(s.r,s.g,s.b, s.brightness, s.effect, s.effectPeriodMs, hubNow());` instead of the current `hubColor` + `nscale8`. Blink to black is a valid frame, so `renderChar(showChar, col)` with `col == Black` is fine. Log `[NODE] apply seq=%u color=%02X%02X%02X bri=%u fx=%u` in `onShow` when `showSeq` changes (B4). Add `case FORGET` (S3-25).

### R6. `commands.h/.cpp` — rewrite against R1/R2
`bool handle(JsonDocument& cmd, JsonDocument& reply, bool isHub)`. Each setter: `SignState s = hub::sign(); …validate → bad_arg…; mutate s; hub::applySign(s); reply["briEff"] = signBriEff(s);` etc. `msg`: copy ≤ 60 bytes uppercased into `s.text`, reply `text` + `chars` (laid-out count). `get` → `hub::buildState(reply.to<JsonObject>())`. `identify/reset_order/forget/name/save` as in S3-25/26/24. Caller sets `ok`.

### R7. `transport.h` + `transport_web.*` — rewrite for `WebServer`/`DNSServer` (S3-01, 09–17)
No Wi-Fi calls. `begin()`: `dns.start(53,"*",WiFi.softAPIP()); server.on("/",HTTP_GET,handleRoot); server.on("/cmd",HTTP_POST,handleCmd); server.on("/state",HTTP_GET,handleState); for each probe path → redirectRoot; server.onNotFound(redirectRoot); server.begin(); Serial.printf("[WEB] listening on %s\n", WiFi.softAPIP().toString().c_str());`. `handleState`: `JsonDocument doc; hub::buildState(doc.to<JsonObject>()); String out; out.reserve(1024); serializeJson(doc,out); sendHeader no-store; send 200 application/json`. (A fixed-size `StaticJsonDocument` no longer exists in AJ7; `JsonDocument` allocates on the heap per call — ~1.2 kB for 10 boards, freed on return. Acceptable at 2 Hz; if B9/B10 shows heap sawtooth, switch to `serializeJson(doc, server.client())` streaming with `setContentLength(CONTENT_LENGTH_UNKNOWN)`.)

### R8. `LED_Sign_Mesh.ino`
Init order (S3-32), role-gated `poll()`, JSON serial line via the existing collector with a 256-byte buffer (S3-33), `w` and `s` additions kept. Revert the cosmetic comment change.

### R9. Tooling
`build_web.py` deterministic (`mtime=0`), 16 bytes/line, relative source path (S3-38/39). Regenerate `web_page.h` after the page fixes. `build_web.ps1` launcher detection. Delete `LED_Sign_Mesh/build/`.

### R10. `web/index.html` — apply the UI checklist below, then re-run `build_web.py`.

## Keep as-is
- File split: `transport.h`, `transport_web.h/.cpp`, `commands.h/.cpp`, `web_page.h`, `web/index.html`, `tools/build_web.py|.ps1` (plan §5.1).
- `symbolCode()` token table (12 tokens → 1–10, 13, 14) — move to `sign_state.h`, content unchanged.
- Captive-portal probe path list (`/generate_204`, `/hotspot-detect.html`, `/connecttest.txt`, `/ncsi.txt`, `/fwlink`) — only the response mechanics change.
- `build_web.py` output format (`WEB_INDEX_GZ[] PROGMEM`, `WEB_INDEX_GZ_LEN`, header comment with source size / gz size / sha1) — only determinism and line wrapping change.
- Serial `w` command and the `web clients=` line in `s`.
- `[WEB] POST /cmd` log line with 120-char truncation (keep; add the reply).
- Page: four-tab structure and panel CSS, `insertSymbol()` cursor-position logic and token map, toast implementation, `focusin`/`focusout` poll pause, `confirm()` on Reset order, dark palette, viewport meta, no modern syntax (after S3-41).
- All step-1 files that the draft left byte-identical: `config.h`, `protocol.h`, `radio_espnow.*`, `display.*` (extended, not changed), `buttons.*`, `battery.h`, `character_patterns.h`.

## UI checklist (`web/index.html`) — concrete defects, in fix order
1. L178, 179, 200, 206: `function(x) x.classList.remove('active')` → add braces and `;` (SyntaxError, kills the whole script).
2. L167: `loadState()` undefined → remove; call `pollState()` once in `init()`.
3. L274: `#boardsCount` missing → add the select (item 6) or null-guard; never let one element abort the poll handler.
4. L205-210 / L113-120: swatch click must POST `{cmd:'color',hex:'RRGGBB'}` (strip `#`); add a rainbow swatch posting `{cmd:'color',rainbow:true}`; remove the black-means-rainbow swatch; `state.cfg` may be undefined before the first poll — guard every `state.cfg.*` write.
5. L122: `<input type=color>` needs an `onchange` that calls the same `setColor`.
6. L124/L133/L186-197: sliders debounce 300 ms and POST `bri` / `fx` themselves; delete "Apply Look" (three POSTs per tap, and it hard-codes `rainbow`).
7. L123: show the effective cap: label `Brightness 100% (effective 60%)` from `cfg.briEff` and from the `bri` reply.
8. L127-130: segment click POSTs `{cmd:'fx',name,speed}` immediately (today it only sets `state.cfg.fx`).
9. L106: Send button posts `document.getElementById('msgText').value` — fine, but disable the button while a request is in flight and trim trailing whitespace.
10. L91/L223-226: char count = laid-out chars (`{token}` = 1), compared with `state.state.numBoards`; red when over.
11. L288: board card → add `mac`, `char`, `HUB`/`self` badge, online/offline text; `Forget` only for `!online && !self` and behind `confirm()`; build DOM with `textContent`, not string concatenation.
12. L137-144: add "Boards: Auto (N) / 1…10" select → `{cmd:'boards',n}`.
13. L151: populate `#status` with `fw`, `heap`, `uptime`, `clients`, `name` from `/state`.
14. L294-303: console must log the **reply** JSON (last ~10 entries), not just "Sent".
15. L267: do not clobber the textarea with `cfg.text` if the user has edited it; L268: `colorPicker.value = '#' + cfg.color`.
16. L231: keep `Content-Type: application/json` (required for `server.arg("plain")`); add a 4 s `AbortController` timeout when available.
17. L103-104: replace 🙂 🙁 with `:)` `:(` (legacy) or BMP glyphs.
18. `<head>`: add `<meta name="color-scheme" content="dark">`; buttons get `touch-action: manipulation`.
19. After all edits: re-run `tools/build_web.py`, confirm `WEB_INDEX_GZ_LEN` changed and `index.html` ≤ 40 kB (currently 15.5 kB — plenty of room).

## Refactor disposition

Refactored against the verified step-1 baseline (commit `b87aa58`), not by patching the Qwen draft. Kept from the draft: the file split, the symbol token table, the probe path list, the `build_web.py` output format, the page's tab/panel structure, palette, `insertSymbol()` cursor logic, toast and focus-pause. Compile: `arduino-cli compile --warnings all --fqbn esp32:esp32:lolin32:PartitionScheme=no_ota` → 0 errors, 0 warnings in our files, sketch 1 072 659 B (51 %), globals 54 792 B. Not flashed (verifier's job).

| ID | Disposition | Notes |
|---|---|---|
| S3-01, 02, 06, 09 | fixed | `transport_web.cpp` uses core `WebServer`/`DNSServer`, includes `web_page.h` at file scope (only TU), `send_P` with `Content-Encoding: gzip` + `Cache-Control: no-store`, `server.client().remoteIP()`. |
| S3-03 | fixed | `sign_state.h/.cpp` (new) + `storage::loadSign/saveSign` (one blob, version byte `SIGN_BLOB_VER`, namespace `sign`) and `storage::loadSsid/saveSsid` (`sys`). |
| S3-04, 19 | fixed | hub.h exports `applySign / sign / saveNow / numBoardsEffective / buildState / identifyPos / forgetPos`. `pending` + `pendingFlag` under `signMux`; `tick()` swaps into `live`, lays out, bumps `showSeq`, bursts, arms `dirtyAt`. Commands never touch hub statics. |
| S3-05, 08 | fixed | ArduinoJson 7 idioms only (`to<JsonObject>()`, `add<JsonObject>()`, `.is<T>()`); no deprecated calls. |
| S3-07, 25 | fixed | `hub::identifyPos` (255 → all, 1 → self flash, else unicast to the table MAC, ms clamped 200–10000); `hub::forgetPos` rejects pos 1/unknown, unicasts FORGET with `dstPos = pos`, frees the slot, saves, bursts. node.cpp gained `case FORGET` (dstPos == myPos → clear NVS pos, UNASSIGNED). |
| S3-10, 26, 29 | fixed | `WiFi.softAP` is called exactly once, in `radio::beginHub(const char* ssid)`; `name` only persists and replies `"note":"applies next boot"`. SSID validated 1–24 chars `[A-Za-z0-9_-]`. |
| S3-11 | fixed | `transport.h` is an abstract `struct Transport` (begin/poll/sendEvent/setCommandHandler); `transport_web::instance()`; the .ino holds `Transport* transport` and installs `cmdHandler` before `begin()`. |
| S3-12, 17 | fixed | `redirectRoot()` → `302` + `Location: http://192.168.4.1/`, registered for the 5 brief probes plus `/gen_204`, `/library/test/success.html`, `/redirect`, `/success.txt`, `/canonical.html`, `/check_network_status.txt`, and as `onNotFound` (logged). `/state` not logged; `/cmd` and not-found are. `no-store` on every JSON reply. |
| S3-13 | fixed (interpretation) | Body read through the WebServer **raw-body callback** (`server.on("/cmd", HTTP_POST, handleCmd, cmdBodyChunk)`), because the core parser silently drops an `x-www-form-urlencoded` field with no `=` — a bare `curl -d '{...}'` (the brief's B4 command) would otherwise arrive empty. Cap 512 B. Errors: oversize/unparseable → `bad_json`; unknown cmd → `bad_cmd`; bad field → `bad_arg`; node → `hub_only`. **All replies are HTTP 200**; `ok` is always present. |
| S3-14, 31 | fixed | One `hub::buildState(JsonObject)`: snapshots `table[]` + `BoardInfo info[]` under `tMux`, then serialises; hub row first with `self:true`; `char` printable (`"{heart}"` for codes); `age = -1` when never heard; `online = lastHb && age < 10 s`; `cfg` from the live RAM state. `BoardInfo{lastHb,lastSeen,rssi,mv,shownChar,nodeState,lastShowSeq}` filled in the HB case; HELLO/ACK update `lastSeen`/`rssi` only. Added `state.hubState` (extra field, harmless). |
| S3-15, 16 | fixed | `poll()` = `handleClient()` + `processNextRequest()` + `softAPgetStationNum()` once a second; stats are `volatile uint32_t` (`lastClientIp` as uint32). |
| S3-18, 34, 35 | fixed | No WebServer/DNSServer includes in the .ino; `w`/`s` gated on role; no cosmetic churn on the `display::show()` line. |
| S3-20 | fixed | Every string field goes through `.is<const char*>()`; ints through `.is<int>()`; `bad_arg` otherwise. |
| S3-21 | fixed | `SignState.text[61]` keeps the raw text (uppercased **outside** `{tokens}`, tokens kept lowercase so the page can re-insert them); `signLayout()` places codes at the output index, tokens consume one position, unknown tokens pass through literally, output stops at `MAX_BOARDS`. `cfg.text` returns the raw text. Reply carries `chars` (laid-out count) and `note` when truncated to 60. |
| S3-22, 23 | fixed | `bri` stores the requested value; `signCap()` = rainbow 70, channels ≥ 64: 3 → 60, 2 → 80, else 100; `briEff = bri*cap/100` computed in `sendShow()`/`render()`/replies. `rainbow:true` → `effect=3`; `hex` clears rainbow (and resets effect 3 → 0); `fx cycle` sets rainbow; `speed` optional, 100–2000. `hex` accepts an optional `#`. |
| S3-24 | fixed | `boards` requires an int 0–10. Auto-save: `dirtyAt` armed on every applied change, `storage::saveSign(live)` in `tick()` after 2 s, `[HUB] sign saved` logged; `save` → `saveNow()` (saved on the next tick, core 1). |
| S3-27 | fixed | `commands::handle(cmd, reply, isHub)` returns bool; `hub_only` for every command on a node (including `get` — nodes have no web transport anyway); caller writes `ok`. |
| S3-28 | fixed | `hub::begin()` loads the SignState and lays it out before the first Show; nothing in the .ino. Default when NVS is empty: `"HI"`, green, bri 100, static, 500 ms, auto boards. |
| S3-30 | fixed | `display::styled()` shared by hub `render()` (hub clock = `millis()`) and node `render()` (`hubNow()` = `millis() + hubOffset`, α = ¼ low-pass from each Show's `hubMillis`, +2 ms latency bias). `[SHOW] seq=N color=RRGGBB bri=B fx=F` on every non-periodic Show; `[NODE] apply seq=N color=.. bri=.. fx=.. period=.. numBoards=..` when `showSeq` changes. Identify still wins. |
| S3-32 | fixed | Hub init order: `radio::beginHub(ssid)` → `transport->setCommandHandler` → `transport->begin()` → `hub::begin()` → `radio::setHandler` → net task. `poll()` only when `role == HUB`. Hub net task stack raised to 12 kB (node stays 8 kB) because HTTP parsing + two `JsonDocument`s now run on it. |
| S3-33 | fixed | Serial collector has modes TEXT (`t…`) and JSON (`{…`) with a 256-byte buffer; the full reply document is printed. `t<text>` is routed through `commands::handle` as `msg`. |
| S3-36 | fixed | `firmware/**/build/` in `.gitignore`; no build artefacts committed. |
| S3-38, 39, 40 | fixed | `build_web.py`: `GzipFile(mtime=0)`, 16 bytes/line, repo-relative source path, `<stdint.h>/<stddef.h>/<pgmspace.h>`, runs from any cwd, refuses > 40 kB. `build_web.ps1` detects `py`/`python3`/`python`. |
| S3-41 – S3-53 | fixed | `web/index.html` rewritten on the draft's skeleton: ES5 only (no expression closures, optional chaining, arrows, template literals); every control POSTs its own command; swatches send `hex` without `#`, rainbow swatch sends `rainbow:true`; `<input type=color>` `onchange`; sliders debounced 300 ms with "effective N%" label; segments POST `fx`; char count = laid-out chars vs `state.numBoards` (red when over); board cards built with `createElement`/`textContent`, `HUB` badge, online/offline text, mac/id/rssi/age/char, Identify per board, Forget only for offline non-self boards behind `confirm()`; `Auto (N)`/1–10 board-count select; Settings shows SSID/fw/heap/uptime/clients and a 10-entry request/reply log; textarea/AP-name not clobbered after a user edit; `color-scheme: dark`, `touch-action: manipulation`; `:)`/`:(` keypad glyphs; 4 s `AbortController` timeout; poll pauses only while a **text** field is focused (a focused button would otherwise stall polling on desktop). 22 796 B source, 6 862 B gzipped. |
| S3-54 | kept | Token map unchanged. |

**B8 smoke test (cloud container, Chromium via Playwright, 390×844 and 1280×800)** against a stub server (`POST /cmd` → `{"ok":true,…}`, `GET /state` → the brief's §4 sample plus one offline board): zero console/page errors; four tabs switch; Send posts `{"cmd":"msg","text":"ok"}` with `Content-Type: application/json`; red swatch posts `{"cmd":"color","hex":"FF0000"}`, rainbow swatch `{"cmd":"color","rainbow":true}`; brightness slider posts `{"cmd":"bri","v":50}` after the debounce; Blink segment posts `{"cmd":"fx","name":"blink","speed":500}`; Boards renders 3 cards, pos 1 marked `HUB`/online, Forget offered only on the offline card; Settings shows fw/heap/clients and the raw console round-trips `{"cmd":"get"}`. Screenshots: `step3_ui_message.png`, `step3_ui_look.png`, `step3_ui_boards.png`, `step3_ui_settings.png`, `step3_ui_desktop.png`.

**Deferred / for the verifier**
- `mv` is always 0 (battery ADC is Phase 2) — `/state` still carries the field.
- `sendEvent()` is a no-op on HTTP (the page polls); BLE transport is Phase 3.
- `/state` allocates a `JsonDocument` per call (~1.2 kB for 10 boards). If B9/B10 show a heap sawtooth, switch `handleState` to streaming `serializeJson(doc, server.client())`.
- The urlencoded path depends on the WebServer raw-body hook: confirm B4 with both bare `curl -d` and `-H 'Content-Type: application/json'`.
- `fx cycle` hue steps 5 per period (plan §4.2 literal formula); smoother cycling can come later without a protocol change.
- Pink `FFC0CB` caps at 60 (3 channels ≥ 64) where v4 named it dual-channel 80 — deterministic, documented deviation.
- Hub net-task stack is 12 kB (was 8 kB): check `netStackFree` in `s` during B9.
