Alternating/esp32-LED-sign/docs/reviews/step2_ui_message.png

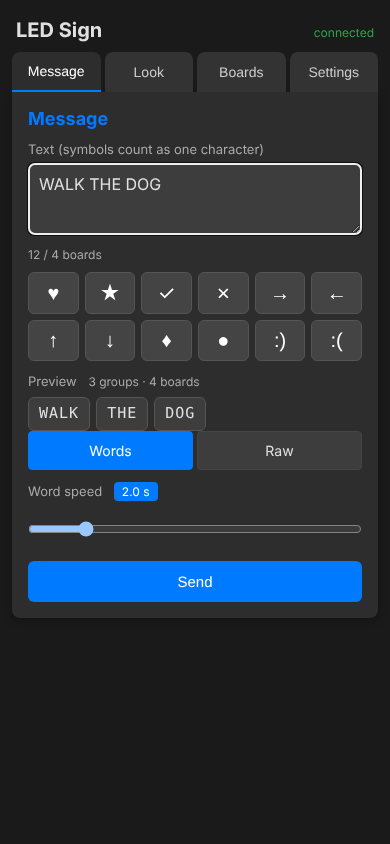
docs/reviews/step2_ui_message.png
