Alternating/esp32-LED-sign/docs/reviews/step3_ui_boards.png

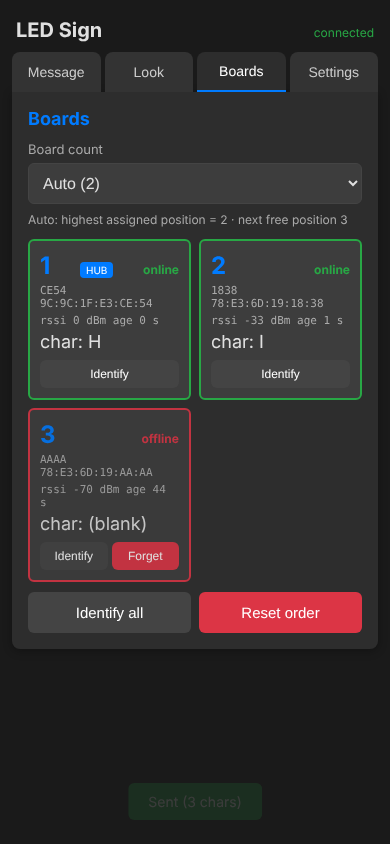
docs/reviews/step3_ui_boards.png
