Alternating/esp32-LED-sign/docs/reviews/step3_ui_desktop.png

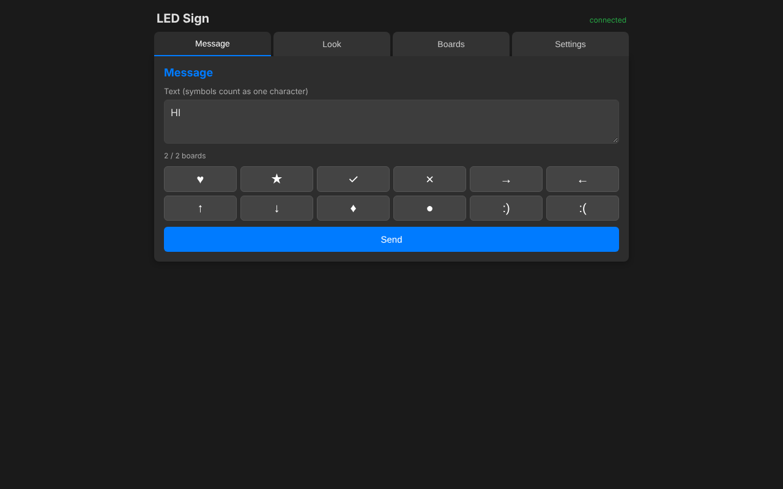
docs/reviews/step3_ui_desktop.png
