Alternating/esp32-LED-sign/docs/reviews/step3_ui_look.png

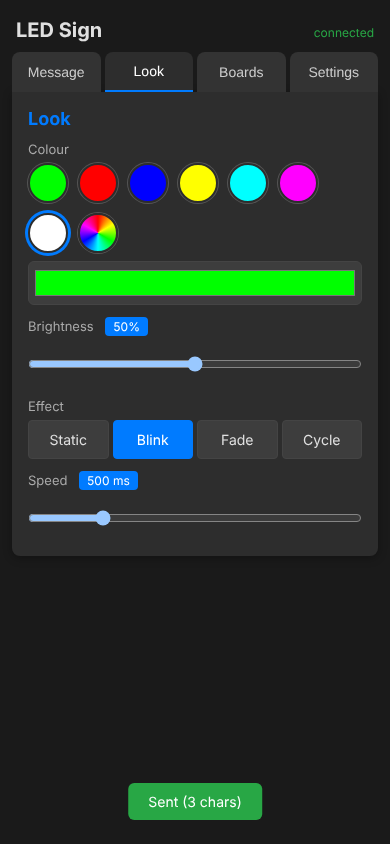
docs/reviews/step3_ui_look.png
