Alternating/esp32-LED-sign/docs/reviews/step3_ui_message.png

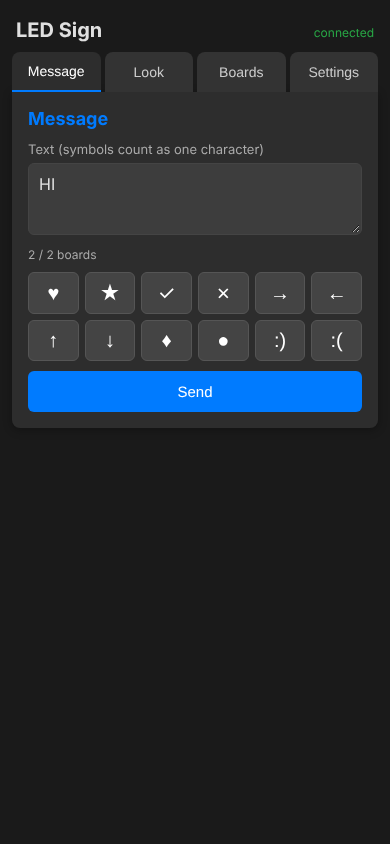
docs/reviews/step3_ui_message.png
