Alternating/esp32-LED-sign/docs/reviews/step3_ui_settings.png

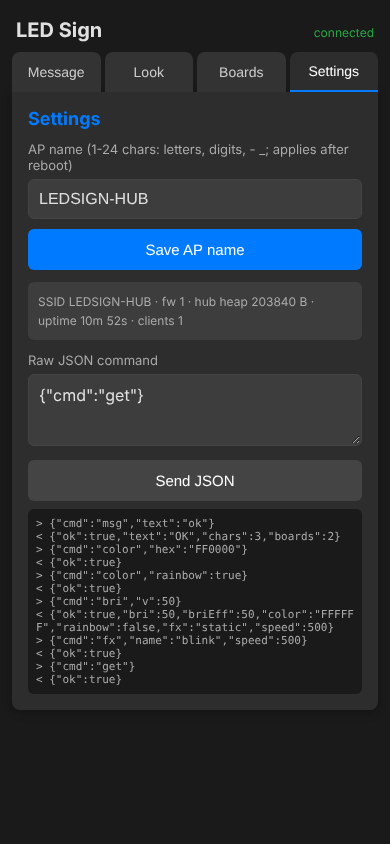
docs/reviews/step3_ui_settings.png
