Alternating/esp32-LED-sign/docs/reviews/PHASE4_VERIFICATION.md

# Verification — Phase 4 (hub-hosted OTA) on hardware

Spec: `docs/build-briefs/PHASE4_OTA_hub_hosted_updates.md` O1–O10 as amended by `docs/reviews/PHASE4_REVIEW.md` (IDF rollback + `verifyRollbackLater()`, one-reset rollback, `PROTO_VER` 1, `MAX_FRAME` 128) and its "Refactor disposition" / "Interpretations for the verifier". Run 2026-11-09 13:23–13:58 (box clock; all serial lines are wall-clock timestamped on the same clock as `curl`).

## Verdict

**O1, O2, O3, O5, O6, O7, O8, O9, O10 PASS. O4 PASS only with a workaround: FAIL as specified (D1).** The documented flow is "upload to the hub, then Update all boards". Every hub upload reboots the hub. After that reboot the hub cannot send any unicast to a node until the node reboots by itself (D1). So `ota_nodes` straight after a hub OTA always fails `no response` (3/3 attempts). After a node reset, which makes it re-HELLO, node OTA works every time: 4/4 runs, 23–24 s per node, with 0 % OTA_STATUS loss over the complete runs. Rollback works exactly as reworded: a truncated image is refused with no reboot, and one reset inside the 30 s window returns the hub to the previous slot (`state ABORTED`). Both boards end on the same committed build `387ea87` / buildId `bfc0e847`, slot `app1`, valid, showing "GO TEAM", green, words mode, wspeed 2000.

## Environment

| Item | Value |
|---|---|
| Commit | `387ea87` (box `~/esp32-led-sign`, clean tree; `release/` and `build_id.h` gitignored) |
| Toolchain | arduino-cli, esp32 core 3.3.12, FQBN `esp32:esp32:lolin32:PartitionScheme=min_spiffs` |
| Hub | `/dev/ttyUSB0`, STA MAC `9C:9C:1F:E3:CE:54` (softAP BSSID `9c:9c:1f:e3:ce:55`) |
| Node | `/dev/ttyUSB1`, STA MAC `78:E3:6D:19:18:38`, position 2 |
| Box WLAN | `wlp3s0`, `wpa_supplicant -B` with `~/v3/wpa.conf`, static `192.168.4.50/24`, `resolvectl default-route wlp3s0 no`, no DHCP. Wired default route `enp5s0` was never touched. |
| Serial tooling | `~/p4/ser.py` (copy of `~/v3/ser.py`) and `~/p4/cap.py`, which does the same capture and can fire an EN/RTS pulse when a regex matches. All logs are in `~/p4/` on the box. |

Images (all 1 137 136 B app images; install images 1 202 672 B):

| Image | FW_VERSION_STR | buildId | sha256 |
|---|---|---|---|
| `release/387ea87/LED_Sign_ota.bin` (final) | 0.4.0 | `bfc0e847` | `6a21272917bd7acf2b346f1b931e89e2871a231071027ca51e147bca64a2087b` |
| `release/387ea87/LED_Sign_HUB_install.bin` | 0.4.0 | `bfc0e847` | `44782eabed61a9daefeb14d530ba08c341b236619c1353f8c521f136556c324f` |
| `release/387ea87/LED_Sign_NODE_install.bin` | 0.4.0 | `bfc0e847` | `bb18584e79a848959e1969f892cbcb3d30dd07eec5a5094fd402d54e036d7e0e` |
| `~/p4/img_0.4.1.bin` (test, scratch copy of the sketch, only config.h changed) | 0.4.1-test | `c4b27c2f` | `dbe1ec661f549311b3718a5562bee0e77554e292386d3ea22e9827302d33cafa` |
| `~/p4/img_0.4.2.bin` (test) | 0.4.2-test | `2e198f3a` | `4094343ef368826f6fd74308d18ee8fa826995886345f39c389cb68f8604b31c` |
| `~/p4/img_0.4.3.bin` (test) | 0.4.3-test | `653f158d` | `4d4af232f21db7c1c6fcf7d750517dcb94981771687616f3de194e890129ae4d` |
| `~/p4/img_trunc4k.bin` = 0.4.3 minus the last 4096 B | — | — | 1 133 040 B |

Hub state recorded before the wired install (`s`): text `"HI AMELIA {heart} LUV YOU BB{heart}{heart}{heart}{check}"`, color `FF0000`, bri 13 (eff 9), fx cycle, speed 100, wspeed 5300, mode words, table empty. The node was `UNASSIGNED` (pos 0). Per the brief, the sign was re-entered as "GO TEAM" green words afterwards, not the old text.

## Results

| ID | Result | Evidence |
|---|---|---|
| **O1 Build** | **PASS** | `tools/make_images.sh` → `build_id.h: BUILD_GIT "387ea87"` (= `git rev-parse --short HEAD`), `Sketch uses 1136995 bytes (57%) … Maximum is 1966080`, globals 63 784 B, the three images listed above, EXIT 0. The script's compile was incremental (`build.log` 209 B), so warnings were counted on a separate `--clean --warnings all` build: **16 warnings, 0 in our sources** (15 FastLED 3.10.9 + 1 core `periph_ctrl.h`, the known set). App 1.137 MB ≤ 1.5 MB. |
| **O2 Wired install** | **PASS** | `flash_board.sh /dev/ttyUSB0 hub` / `… /dev/ttyUSB1 node` at 115200: `Hash of data verified` on both, first try. Hub banner: `[OTA] running app0 @0x010000 state=UNDEFINED buildId=bfc0e847 fw 0.4.0 (git 387ea87)`, **`[OTA] image length 1137136 B (0 ms)` = `LED_Sign_ota.bin` size**, `=== LED_Sign_Mesh 0.4.0 387ea87 bfc0e847 app0 ===`, `Running as HUB MAC 9C:9C:1F:E3:CE:54`, `fw server listening on :8080 (1137136 B image)`. `s`: `slot app0 valid=1`, no pending verify (blank otadata → `UNDEFINED`, as the interpretation says). Node banner: `running app0 … state=UNDEFINED buildId=bfc0e847`, `NVS pos=2 → DISCOVER → SHOW_POSITION pos=2 → RUNNING`. Hub `ASSIGN 78:E3:6D:19:18:38 -> pos 2`. Sign set through the hub serial JSON (`msg "GO TEAM"`, `color 00FF00`, `mode words`, `wspeed 2000`) → `groups ["GO","TE","AM"]`. Node sequencing: `apply seq=4 word=1/3 'E' (+294 ms)`, `seq=5 'M'`, `seq=6 'O'` … at 2.000 s spacing, in step with the hub (`T`,`A`,`G`). |
| **O3 Hub OTA** | **PASS** | `curl -F file=@img_0.4.1.bin http://192.168.4.1/ota` → `{"ok":true,"size":1137136,"err":"","note":"rebooting in 1 s"}`, 13.36 s. Hub: `hub upload started` → `100 kB` … `1100 kB` → `hub upload OK: 1137136 B in 12303 ms` → `[OTA] rebooting` → `running app1 @0x1f0000 state=PENDING_VERIFY buildId=c4b27c2f fw 0.4.1-test` → `new image: confirming after 30 s healthy` → `image length 1137136 B` → `table loaded: 1 boards`, `sign loaded: text="GO TEAM" color=00FF00 … wspeed=2000 mode=words` (NVS intact) → `SHOW_POSITION -> RUNNING` 13:32:46.4 → **`[OTA] image marked valid (slot app1)` 13:33:07.3**. `s` afterwards: `78:E3:6D:19:18:38 -> pos 2 online`, `slot app1 valid=1`. Node: `RUNNING -> LOST_HUB` 13:32:41.4 → `hub clock went backwards: hub restarted, resyncing` → `LOST_HUB -> RUNNING` 13:32:43.5, **6.7 s after the hub's `rebooting` line** (≤ 10 s). The node kept sequencing during the upload. |
| **O4 Node OTA** | **FAIL as specified / PASS after workaround** | **First attempt, directly after O3 (13:33:44):** `ota_nodes` → `{"queued":1}`, hub `OTA_ENTER pos 2 … bfc0e847 -> c4b27c2f` → `[RADIO] give up 78:E3:6D:19:18:38 type=14 seq=185 after 5 tries` (1 s) → `[OTA] pos 2 failed: no response -> next`. The node logged nothing, and hub `txFail` went 0 → 6. Same result with `O2` at 13:35:54, and after the O6 hub upload at 13:41:23. Unicast IDENTIFY also failed (4/4 `give up … type=8`, with or without the box associated). See **D1**. **After a node reset** (node re-HELLOs, hub `[RADIO] addPeer 78:E3:6D:19:18:38 OK`, `ASSIGN … pos 2 (known)`), `ota_nodes` at 13:37:45.493 gives: hub `queue: 2 (1 queued … target buildId c4b27c2f)`, `OTA_ENTER pos 2 (78:E3:6D:19:18:38) buildId bfc0e847 -> c4b27c2f, 1137136 B from :8080`. Node: `OTA_ENTER -> LEDSIGN-HUB, image 1137136 B` → `RUNNING -> OTA` → `joining LEDSIGN-HUB on channel 6` → `joined in 1248 ms, ip 192.168.4.2, channel 6` → **`GET /fw.bin 1137136 B`** (= image) → `10 %` … `100 %` → `Update OK: 1137136 B in 13605 ms` → `OTA done, restarting` → `running app1 … PENDING_VERIFY buildId=c4b27c2f` → `NVS pos=2 → DISCOVER → SHOW_POSITION → RUNNING pos=2` 13:38:09.370 → `image marked valid (slot app1)` 13:38:30.5. Hub: `fw server: 192.168.4.2 GET /fw.bin, sending 1137136 B` → `done 1137136/1137136 B in 11842 ms` → `ASSIGN … pos 2 (known)` → **`[OTA] pos 2 done in 20 s (rejoined with the hub's buildId)`**. `/state.ota` polled every 2 s: `joining 0` → `updating 40` → `updating 90` → `rebooting 100` → `{"pos":2,"buildId":"c4b27c2f","status":"done","pct":100}`. Boards fw `c4b27c2f`, 0 failed polls during the transfer. **Command to node RUNNING: 23.9 s** (target < 40 s). Repeated on the final image: 13:48:46.9 → RUNNING 13:49:10.3 = **23.4 s**, hub `done in 20 s`, node valid 13:49:31.4. Display glitch watch (O4-26): hub `apply` spacing while serving /fw.bin was 2.000 s ± 11 ms (46.423, 48.426, 50.429, 52.425, 54.432, 56.422, 58.424), with no stalls or resets. This was checked over serial only; nobody watched the LEDs. |
| **O5 Up-to-date** | **PASS** | `ota_nodes` → `{"queued":0,"skipped":1,"ok":true}`, node untouched. `ota_node {pos:2}` → `{"err":"up_to_date","ok":false}`. Also `ota_node {pos:1}` → `hub_use_ota_upload`, and `{pos:7}` (no such board) → `bad_arg`. |
| **O6a Node reset mid-download** | **PASS** | Hub on 0.4.2-test (`2e198f3a`, app0, valid 13:40:56.9). After the node reset workaround, `ota_node {pos:2}` at 13:42:01.3. Node `10 %`/`20 %`/`30 %`/`40 %` at 13:42:06.942, then **EN pulse via RTS at 13:42:07.047**. Node boots `running app1 @0x1f0000 state=VALID buildId=c4b27c2f fw 0.4.1-test` (old image, slot untouched) → `RUNNING pos=2` 13:42:16.4. Hub: `ASSIGN … pos 2 (known)` 13:42:13.3, `fw server: 192.168.4.2 ABORTED 458752/1137136 B in 24117 ms`, **`[OTA] pos 2 failed: timeout -> next` at 13:44:01.365 (exactly 120 s after OTA_ENTER)**. `/state.ota.boards`: `{"pos":2,"buildId":"c4b27c2f","status":"failed","pct":30,"err":"timeout"}`. Queue is idle afterwards (`current: null`). |
| **O6b `ota_cancel`** | **PASS** (documented behaviour) | `ota_nodes` 13:44:34.66 → OTA_ENTER. `ota_cancel` at 13:44:38.7, while the node was downloading → `{"dropped":0,"ok":true}`, hub `cancel: 0 queued dropped (node in flight continues until done/timeout)`. The node finished: `Update OK … 14208 ms` → app0 `2e198f3a` → RUNNING 13:44:59.1 (24.4 s; `joined in 2898 ms` this time), and the hub logged `done in 21 s`. In the same run, **`POST /ota` during the node download was refused**: `{"ok":false,"size":0,"err":"node update in progress"}`, hub `hub upload failed: node update in progress`, no reboot. `ota_nodes` while the node was in flight → `queued 0 skipped 0`. |
| **O7 (i) Truncated image** | **PASS** | `img_trunc4k.bin` (1 133 040 B) → `{"ok":false,"size":1133040,"err":"Could Not Activate The Firmware"}` (19.0 s). Hub `hub upload failed: Could Not Activate The Firmware`, **no reboot**, `s`: `fw 0.4.2-test … buildId 2e198f3a slot app0 valid=1`, uptime continuous (335 s). |
| **O7 (ii) Rollback of an unconfirmed image** | **PASS** | Upload `img_0.4.3.bin` → OK in 15 045 ms → `running app1 @0x1f0000 state=PENDING_VERIFY buildId=653f158d fw 0.4.3-test` 13:46:39.6, `HUB RUNNING` 13:46:42.9 → **EN pulse via RTS at 13:46:47.762** (8 s into the window, before confirmation) → `=== LED_Sign_Mesh 0.4.2-test ===`, **`running app0 @0x010000 state=VALID buildId=2e198f3a`**, **`previous image in app1 was rolled back (state ABORTED)`**. `/state.ota.hub` `slot app0 valid true`; text/color/mode/wspeed intact; node RUNNING through both hub boots. A good image then confirmed: final `LED_Sign_ota.bin` → app1 `PENDING_VERIFY bfc0e847` 13:47:47.8 → `image marked valid (slot app1)` 13:48:12.0. Slot/buildId history of the hub: app0 `bfc0e847` (wired) → app1 `c4b27c2f` → app0 `2e198f3a` → app1 `653f158d` ✗ rolled back → app0 `2e198f3a` → app1 `bfc0e847` ✓. |
| **O8 UI** | **PASS** | `GET /` → `200`, `Content-Encoding: gzip`, `Content-Length: 10781`. `gunzip | sha1sum` = `260de4e6247d259c5c024592edf16c45b651f37d` = `sha1sum web/index.html`. `/state` has `ota` = `{hub:{buildId,version,git,slot,valid,verifyIn,imageLen}, running, upload, current, boards:[{pos,buildId,status,pct,err}]}`, and every `state.boards[]` row has `fw` (`bfc0e847` ×2). |
| **O9 Regression (final build `bfc0e847`, both app1)** | **PASS** | **A3**: node reset → `=== … bfc0e847 app1 ===`, `NVS pos=2`, hub `ASSIGN … -> pos 2 (known)`. **A5**: `reset_order` → hub `RESET ORDER: table cleared, nextPos=2, broadcasting RESETORD x5`, `rebuilt: groups=6 … boards=1`. Node `c` → `CLAIM sent` → `UNASSIGNED -> DISCOVER` → `SHOW_POSITION pos=2`, hub `ASSIGN … -> pos 2 (new) [claim]`, `rebuilt: groups=3 … boards=2`. **Identify** `{"pos":2,"ms":10000}` → hub `IDENTIFY pos 2 … 10000 ms`, node `IDENTIFY 10000 ms` (log only). **Mirror** `{"pos":2,"v":true}` → node `SETMIRROR -> mirror=1 (saved)`, `/state` mirror true; `v:false` → `mirror=0`, `/state` false. **Sequencing** `measure_period.py … 1000 45`: 45 applies, idx `201201…`, **mean 1000.1 ms, sd 7.9, min 992, max 1008**, lead 279–300 ms. **Soak** 13:51:42–13:56:59 at wspeed 1000, `/state` every 2 s: **150/150 polls OK**, pos 2 online in 150/150, `/state.heap` min 152 948 / max 155 304 (2.4 kB span). Hub `s` heap 158 436 → 155 840 (−2.6 kB), minHeap 139 492 unchanged. Node heap 192 324 → 192 324. `rxDrop 0` and `txFail 0` on both, no LOST_HUB, no reset banner. 312 node applies and 312 hub applies, seq 148→459 with no gaps, leads 272–303 ms. |
| **O10 ESP-NOW while associated** | **PASS (0 % loss)** | The node sends OTA_STATUS on JOINING, every 10 % decile and VERIFIED (`node.cpp:372/381/390`). Its `[OTA] N %` log lines are 1:1 with the decile sends. Hub `[OTA] pos 2 <state> N %` lines: O4 **12/12**, O6b **12/12**, final **12/12**. O6a: 4 received (joining, 10, 20, 30). The 40 % status may not have left before the reset fired 105 ms after the node logged it, so that run is excluded. Total **36/36 = 0 % loss** over the complete runs, so the `/ota_status` HTTP fallback (O4-40) is not needed. |

## Timings

| Step | Time |
|---|---|
| Hub upload via `curl` (box → hub, 1 137 136 B) | 13.0–13.6 s wall (hub `upload OK … in 11 939–12 494 ms`). One run took 16.2 s / 15 045 ms. The truncated upload took 19.0 s. |
| Hub `upload OK` → reboot → `RUNNING` | ≈ 10.7 s (1 s reboot delay + ≈ 5 s boot/role window + 3 s SHOW_POSITION) |
| Hub boot → `image marked valid` | 30 s of `millis()`. That is about 24 s after the banner line, because the 5 s boot/role window counts toward the 30 s. |
| Node OTA, command → node `RUNNING` on the new image | **23.9 s / 23.4 s / 24.4 s** (join 1.25–2.9 s, download+write 13.1–14.2 s, reboot+boot ≈ 9.5 s). Hub `done in 20–21 s`. |
| Node `RUNNING` → `image marked valid` | ≈ 21 s (30 s of `millis()` from reset) |
| Per board, end to end | Hub ≈ 13 s upload + ≈ 11 s to RUNNING (+ confirm at 30 s). Each node ≈ 24 s, so a 10-board sign is ≈ 4 min of node updates after the hub. |
| Node failure detection (O6a) | `timeout` at exactly 120 s after OTA_ENTER. The fw server noticed the dead socket after 24 s. |

## Anomalies / observations

1. **D1 below.** This is the only defect that breaks an acceptance flow.
2. **The hub upload stalls the hub's own word timing.** During a 12 s `/ota` upload the hub's `apply` lines run up to ≈ 180 ms late (e.g. `advance … applyAt=+285` at 18.355, but `apply` at 18.820), and node and hub word switches drift apart by up to ≈ 160 ms (seq 228: hub 18.820, node 18.663). One node apply landed at `(-82 ms)` and the next at `+529 ms`. The display effect lasts only for the upload, and the review notes that the port-80 server blocks for the transfer. The node download (port 8080 task) does **not** cause this (± 11 ms).
3. **A refused upload still reads the whole body.** `POST /ota` while a node OTA was running took 5 s to answer, so the hub received all 1.1 MB before saying `node update in progress`. In that window the node's 20 % status reached the hub ≈ 0.9 s late. This is harmless.
4. **No fast failure when the in-flight node comes back on its old image.** In O6a the node re-HELLO'd with the old buildId 6 s after its reset, but the hub kept the row `updating 30 %` until the 120 s timeout. A HELLO/HB from the in-flight MAC that carries a buildId ≠ target could fail it immediately (`node rebooted (old image)`). This is an enhancement, not an acceptance failure.
5. **A rebuild of the same commit gives a different buildId.** A `--clean` rebuild of `387ea87` differs from the release `.bin` from byte 177, inside `esp_app_desc`, because of the build time and date. Since buildId = `app_elf_sha256[0..3]`, rebuilding the same commit and uploading it would make every node "need an update". This is expected with an ELF-hash id. It is only a concern if releases are ever rebuilt.
6. Node `s` prints `imageLen=0` (only the hub measures the image). This is cosmetic.
7. Hub `minHeap` dropped to 125 392 B during the truncated upload, and was 139 492 B during the final session. It was never close to trouble.
8. `/state.clients` = 1 with only the box associated. Step-3 N1/D2 (peers counted as clients) appears fixed or unchanged; it was not re-tested in depth.

## Defects for fix agent

**D1 (blocking for O4 as specified): after a hub reboot the hub has no ESP-NOW peer entry for known nodes, so every unicast to them fails until each node reboots.**

- **Mechanism:** `hub.cpp` calls `radio::addPeer(mac)` only in `onHello()` (line 286). When the hub reboots (every hub OTA, also power cycles), it reloads the table from NVS but registers no peers. A node that was RUNNING sees `hub clock went backwards: hub restarted, resyncing` and goes `LOST_HUB -> RUNNING` from SHOW alone. It never sends HELLO, so the hub never re-adds it. After that, every `radio::send(nodeMac, …, needsAck)` fails: OTA_ENTER, IDENTIFY, SETMIRROR, SETPOS, FORGET. The hub logs `[RADIO] give up <mac> type=N … after 5 tries` within ≈ 1 s and `txFail` rises by about 5–6 per command. The node logs nothing. `esp_now_send` to an unregistered peer returns `ESP_ERR_ESPNOW_NOT_FOUND` at once, which explains the 1 s give-up. The bug is latent since Step 1, but Phase 4 makes it certain: the documented flow (upload → hub reboots → "Update all boards") fails `no response` on every node, every time.
- **Repro:** hub and node RUNNING. `curl -F file=@<any differing .bin> http://192.168.4.1/ota`, wait for the hub to reach RUNNING (the node resyncs without a reset), then `curl -d '{"cmd":"ota_nodes"}' http://192.168.4.1/cmd`. Hub: `OTA_ENTER pos 2 …` → `give up 78:E3:6D:19:18:38 type=14 … after 5 tries` → 10 s later `pos 2 failed: no response`. `{"cmd":"identify","pos":2,"ms":800}` also gives `give up … type=8`. Reset the node (it HELLOs, hub `addPeer … OK`) and both work. Observed 3/3 for OTA_ENTER (13:33:44, 13:35:54, 13:41:23) and 4/4 for IDENTIFY.
- **Suggested fix (any one):**
  - (a) In `hub::begin()` after the table load, `radio::addPeer()` every table MAC.
  - (b) In the HB handler (`hub.cpp` around line 610), `radio::addPeer(srcMac)` when the srcPos/MAC is in the table. `addPeer` is idempotent through `esp_now_is_peer_exist`.
  - (c) In `radio::send()`, add a missing unicast peer before queueing.

  (a)+(b) is the most robust. Also log the `esp_err_t` when `esp_now_send` fails immediately, so this shows as "peer not found" rather than as an ACK timeout.
- **Re-verify:** O3 then O4 back to back with no node reset. Also `identify pos 2` right after any hub reboot.

**D2 (minor, enhancement): the in-flight node that rejoins on its old image is only failed by the 120 s timeout.** See anomaly 4. Fail the row as soon as a HELLO/HB from `otaRec[cur]`'s MAC carries a buildId ≠ target, after OTA_ENTER was ACKed.

**D3 (minor): the hub upload delays the hub's own sequencer by up to ≈ 180 ms during the 12 s transfer** (anomaly 2). Consider calling the sequencer tick (not only `radio::pump()`) between upload chunks, or accept it and document it.

## Final state / cleanup

- Hub: `fw 0.4.0 (git 387ea87) buildId bfc0e847 slot app1 valid=1 imageLen=1137136`, `otaQueue: current=none queued=[]`, text "GO TEAM" `00FF00` static, mode words, **wspeed 2000**, table `78:E3:6D:19:18:38 -> pos 2 online fw=bfc0e847`.
- Node: `role=NODE pos=2 state=RUNNING`, `fw 0.4.0 (git 387ea87) buildId bfc0e847 slot app1 valid=1`, `show: color=00FF00 … word=0/3 wspeed=2000`, mirror 0.
- Both boards run the committed `387ea87` image, installed over the air into app1 and confirmed. app0 on both holds `2e198f3a` (0.4.2-test), which is valid and would only be used by a future rollback.
- Box: our `wpa_supplicant` (pid file `/run/wpa_p4.pid`) was killed, the `wlp3s0` address flushed and the link set down. The only remaining `wpa_supplicant` is the system D-Bus instance (pid 1336), which was there before. Routes = start (`default via 192.168.1.1 dev enp5s0`, `192.168.1.0/24`). DNS = start (`enp5s0` 192.168.1.1 / 1.1.1.1). `getent hosts github.com` → `140.82.112.3`. No capture processes are left. Test images and logs stay in `~/p4/` on the box (not in the repo).

## D1 fix verification (commit e84e72b, release `release/e84e72b/`, 2026-11-09)
Fix: `hub::begin()` re-registers every table MAC as an ESP-NOW peer after loading the table; HB from a node also (idempotently) re-adds its peer; immediate `esp_now_send` failures are logged with the error name.
Deployed **over the air** with the new `tools/ota_rollout.sh` (box joins the AP on wlp3s0, static IP, cleans up after):
- hub before `bfc0e847 / 387ea87 / app1 valid` → upload 1 137 264 B (41 s this run) → reboot → `05eab0ef / e84e72b / app0 valid`.
- `ota_nodes` issued **immediately, no node reset** → `queued 1` → pos 2 joining → 10/40/70 % → rebooting → **done at +22 s**; both boards report fw `05eab0ef`. (Before the fix this exact sequence failed 3/3 with `give up … type=14`.)
- Post-reboot unicast checks: identify pos 2 **5/5**, SETMIRROR on/off round-trip OK.
**D1 closed. Phase 4 O1–O10 all PASS.** D2/D3 remain minor (logged above).
