Alternating/esp32-LED-sign/docs/reviews/STEP3_VERIFICATION.md

# Verification — Phase 1 step 3: web transport + phone UI (hardware + HTTP)

Verified against `docs/build-briefs/PHASE1_STEP3_web_transport_ui.md` (B1–B10, §4 `/state` shape) and the "Refactor disposition / Spec interpretations" at the end of `docs/reviews/STEP3_REVIEW.md`. Firmware source was **not** modified. Step-1 regression set A2/A3/A5 (`docs/reviews/STEP1_VERIFICATION.md`) re-run.

## Environment

| Item | Value |
|---|---|
| Commit under test | `8190eb6` firmware: step 3 — web transport, captive portal, JSON commands, phone UI, node styling |
| Build box | Qwen box (`~/esp32-led-sign`), arduino-cli at `~/.local/bin`, core esp32 3.3.12, FastLED 3.10.9, ArduinoJson 7.4.3, esptool 5.3.1 |
| FQBN | `esp32:esp32:lolin32:PartitionScheme=no_ota` |
| Hub | `/dev/ttyUSB0`, STA MAC `9C:9C:1F:E3:CE:54` (AP BSSID `9C:9C:1F:E3:CE:55`), role HUB from NVS, SSID `LEDSIGN-HUB` |
| Node | `/dev/ttyUSB1`, MAC `78:E3:6D:19:18:38`, role NODE from NVS, pos 2 |
| Flashing | `arduino-cli upload` fails on both ports ("Unable to verify flash chip connection") because the esptool stub's baud switch (921600/460800/230400) does not work on these USB-serial adapters. Workaround: esptool directly at a fixed `--baud 115200` (`write-flash -z 0x1000 bootloader 0x8000 partitions 0xe000 boot_app0 0x10000 app`), 4× "Hash of data verified", ~75 s per board. |
| WLAN on the box | **`wlp4s0` is a wil6210 (802.11ad, 60 GHz) card and can never see a 2.4 GHz AP** — scans return nothing. Used **`wlp3s0` (ath10k)**. No NetworkManager (`nmcli` absent); used `wpa_supplicant -B -i wlp3s0 -c ~/v3/wpa.conf` (ssid/psk) + `dhcpcd -4 -w wlp3s0` → `192.168.4.3/24`, assoc on `freq=2437` (channel 6). The box's default route is wired (`enp5s0`), untouched. |
| DNS side-effect | The hub's captive DNS was pushed by DHCP into systemd-resolved and immediately hijacked **all** box DNS (`getent hosts github.com` → `192.168.4.1`); it came back after every re-lease (hub reboot). Fixed with `resolvectl dns wlp3s0 ""; resolvectl default-route wlp3s0 no`, then replaced the lease with a static `192.168.4.3/24` (dhcpcd killed) for the rest of the run. Cleanup at the end: wpa_supplicant for wlp3s0 killed, address flushed, link down; routes/DNS verified identical to the start. |
| Serial tooling | `~/v3/ser.py PORT SECS [reset|noreset] [keys] [delay]` — wall-clock-timestamped capture (same clock as the `curl` timestamps), optional EN pulse via RTS, optional keys after a delay. Opening the port without reset was verified not to reboot the board. |

## Results

| Test | Result | Evidence |
|---|---|---|
| **B1 Build** | **PASS** | `arduino-cli compile --warnings all` → `grep -ciE "error\|warning: "` = **0**. `Sketch uses 1072659 bytes (51%) of program storage space. Maximum is 2097152 bytes.` / `Global variables use 54792 bytes (16%) of dynamic memory, leaving 272888 bytes`. Flash 1 072 800 B ≤ 1.4 MB. |
| **B2 Boot** | **PASS** | Hub: `Role in NVS: HUB` → `[RADIO] SoftAP LEDSIGN-HUB at 192.168.4.1` → `[RADIO] Wi-Fi channel: 6 (want 6) OK` → `[WEB] listening on 192.168.4.1 (SSID LEDSIGN-HUB)` → `[HUB] table loaded: 1 boards, nextPos=3` → `[HUB] sign loaded: text="HI" color=00FF00 bri=100 fx=static speed=500 boards=0` → `[HUB] BOOT -> SHOW_POSITION` → `Running as HUB MAC 9C:9C:1F:E3:CE:54 radio=OK channel=6 OK mirror=0 free heap 188788` → `[HUB] SHOW_POSITION -> RUNNING` → `[HUB] render 'H'`. Node: `[NODE] NVS pos=2` → `BOOT -> DISCOVER pos=2` → `hub learned 9C:9C:1F:E3:CE:54` → `DISCOVER -> SHOW_POSITION pos=2` → `[NODE] apply seq=1 color=00FF00 bri=100 fx=0 period=500 numBoards=2` → `SHOW_POSITION -> RUNNING pos=2` → `[NODE] render 'I'`. Hub concurrently: `[HUB] ASSIGN 78:E3:6D:19:18:38 -> pos 2 (known)` + burst `[SHOW] seq=1 color=00FF00 bri=100 fx=0` ×3. Defaults "HI" green confirmed. |
| **B3 Portal** | **PASS** | `/generate_204` → `302 http://192.168.4.1/`; same for `/hotspot-detect.html`, `/connecttest.txt`, `/ncsi.txt`, `/fwlink` and an unknown path `/nothing/here` (onNotFound). `GET /` → `HTTP/1.1 200 OK`, `Content-Type: text/html`, `Content-Encoding: gzip`, `Cache-Control: no-store`, `Content-Length: 6862`; `gunzip -c` begins `<!DOCTYPE html>`. DNS: `dig +short foo.example @192.168.4.1` → `192.168.4.1`; `connectivitycheck.gstatic.com` → `192.168.4.1` (and, involuntarily, the box's own resolver — see Environment). |
| **B4 Commands** | **PASS** | All replies HTTP 200 with `ok` present. Timeline (box clock; hub/node serial on the same clock): `msg "OK"` POST 23:33:51.017 → hub `[SHOW] seq=2 … [HUB] render 'O'` 51.067 → node `[NODE] apply seq=2 …` 51.093 / `render 'K'` 51.103 (**≈ 76 ms POST→node apply, 86 ms to render**). `msg "{heart}A"` → reply `{"text":"{heart}A","chars":2,…}`, hub `render code 1`, node `render 'A'`. `color FF0000` → `[SHOW] seq=4 color=FF0000 bri=100 fx=0` / node `apply seq=4 color=FF0000`. `bri 50` → reply `briEff 50, cap 100`, node `bri=50`. `color FFFFFF` (bri still 50) → `briEff 30`; `bri 100` → **`briEff 60, cap 60`**, node `bri=60`. `color rainbow:true` → reply `fx "cycle", briEff 70`, hub `fx=3`, **node `apply seq=8 … fx=3`**. `fx blink 500` → **node `apply seq=9 … fx=1 period=500`** (LED alternation itself is not observable over serial — `display::styled()` returns Black on odd `hubNow/period` half-periods; see phone checklist). `fx static` → node `fx=0`. `{"cmd":"bogus"}` → `{"err":"bad_cmd","ok":false}`. Malformed `{"cmd":"msg","text":` → `{"ok":false,"err":"bad_json"}`. 600 B body → `{"ok":false,"err":"bad_json","note":"body > 512 B"}`. **Bare `curl -d` (x-www-form-urlencoded) and `-H 'Content-Type: application/json'` and `text/plain` all work** (raw-body hook). Also: `fx` without name → `bad_arg`; `bri v:"50"` (string) → `bad_arg`; `hex "#00FF00"` accepted; `identify` without pos → `bad_arg`; `GET /cmd` → 302 to `/`; empty POST body → `bad_json`. Each `/cmd` logged `[WEB] POST /cmd {…} -> {…}`; `[HUB] sign saved` 2.0 s after every change. |
| **B5 State** | **PASS** (shape differences noted) | `GET /state` → 200, `Content-Type: application/json`, `Cache-Control: no-store`, `Access-Control-Allow-Origin: *`, 499 B. Shape vs §4: identical keys plus **extra** `state.hubState` ("RUNNING") and **`self:false` emitted on non-self rows** (§4 omits `self` there). `cfg.fw` 1, `boards` 2, `boardsAuto` true, pos 1 `self:true rssi:0 age:0`, pos 2 `online:true rssi:-35 age:0` (age cycles 0–3 s = HB period), `mv:0` (stub). Node power-cycle at 23:35:30: `online:true age=9` at 23:35:39 → **`online:false age=10` at 23:35:40** (10 s after the last HB) … `age=14` → **`online:true age=0` at 23:35:45** (node RUNNING at 23:35:41.4, first HB ≈ 4 s later). `numBoards` stayed 2 throughout. |
| **B6 Persistence** | **PASS** | `msg "AB"` + `color 0000FF` at 23:36:13 → `[SHOW] seq=14 color=0000FF` → `[HUB] sign saved` 23:36:15.1. Hub reset 23:36:18 → boot `[HUB] sign loaded: text="AB" color=0000FF bri=100 fx=static speed=500 boards=0` → `render 'A'`. `/state` after boot: `text "AB", color "0000FF"`, boards `[(1,True,'A'),(2,True,'B')]`. Node: `RUNNING -> LOST_HUB` 23:36:22.5 → `apply seq=1 color=0000FF …` + `LOST_HUB -> RUNNING` 23:36:24.2 (hub-loss recovery as in A4). |
| **B7 Identify / reset / forget** | **PASS with defect D1** | `identify pos 2 ms 1000` → hub `[HUB] IDENTIFY pos 2 (78:E3:6D:19:18:38) 1000 ms` but **no node IDENTIFY line** (lost; see D1). `identify 255` → hub `IDENTIFY ALL 3000 ms`, node `[NODE] IDENTIFY 3000 ms`. `identify 1 ms 500` → `[HUB] IDENTIFY self 500 ms`. `identify 7` (unknown pos) → `bad_arg`. `reset_order` → hub `RESET ORDER: table cleared, nextPos=2, broadcasting RESETORD x5`, node `RESETORD received` → `RUNNING -> UNASSIGNED pos=0`; `/state` → `numBoards=1 nextPos=2 boards=[(1,CE54)]`. Node `c` → `CLAIM sent` → `DISCOVER -> SHOW_POSITION pos=2` → `RUNNING pos=2`; hub `ASSIGN … -> pos 2 (new) [claim]`; `/state` row back (online after first HB). `forget 2` → hub `[HUB] forget pos 2 (78:E3:6D:19:18:38): row removed, FORGET sent`, **node `[NODE] FORGET from hub (pos 2): clearing NVS pos -> UNASSIGNED`**, `/state` row gone, `numBoards=1 nextPos=2`. `forget 2` again → `bad_arg`; `forget 1` → `bad_arg`. Node `c` → pos 2 again, `/state` restored. Unicast identify re-tested 11× in total: **9 delivered, 2 lost** (hub `txFail` went 0→1). |
| **B8 Page** | **PASS** (byte identity) | Playwright run done by the refactor agent (screenshots `docs/reviews/step3_ui_*.png`). Live page from the hub: `sha1(gunzip)` = `950c67d6edddbae81a2b8e65cf67666ca5b32f18` = `sha1(web/index.html)` = `SHA1(source)` in `web_page.h`; 6 862 B gzipped matches the header comment. |
| **B9 Load** | **PASS** | 120 × `GET /state` at 500 ms (66 s): **ok=120 fail=0**, plus three `msg` POSTs during the run (all `ok:true`, node applied seq 2–4). Hub `s` before → after: `heap=181024 minHeap=166184 … tx=501 txFail=1 rx=64 rxDrop=0 netStackFree=9660` → `heap=178312 minHeap=165668 … tx=712 txFail=1 rx=93 rxDrop=0 netStackFree=9564` (Δheap −2.7 kB, within ±4 kB; net-task stack high-water ≥ 9.5 kB free of 12 kB). Node during the run: no `LOST_HUB`, `s`: `heap=207516 minHeap=207204 … rx=779 rxDrop=0 netStackFree=6364`, `lastShow=156ms ago`. |
| **B10 Soak** | **PASS** | 150 × `GET /state` every 2 s (23:42:30–23:47:39, box associated throughout). Hub heap from `/state`: **min 175 392, max 175 640** (spread 248 B); node heap `207516` at start (B9 `s`) and `207516` at end (`minHeap 207204`), uptime 732 s, no reset banner on either serial log, `pos2 online=true` in all 149 parsed samples, no `LOST_HUB`. Hub `s` at the end (full): `role=HUB pos=1 state=RUNNING nextPos=3 numBoards=2 showSeq=4` / `text="OK" color=0000FF bri=100/100 fx=static speed=500 boards=0 mirror=0` / `78:E3:6D:19:18:38 -> pos 2 online age=1s rssi=-32 vbat=0 char=75 nodeState=3 lastShowSeq=4` / `heap=178288 minHeap=160616 channel=6(OK) uptime=689s tx=1367 txFail=1 rx=186 rxDrop=0 netStackFree=9564` / `web clients=2 requests=308`. **1 of 150 polls returned an unparseable (empty/truncated) body** at 23:46:49; not reproducible in 250 further back-to-back polls (0 bad, `time_total` ≈ 21 ms). See anomaly N3. |

### Regression (step 1)

| Test | Result | Evidence |
|---|---|---|
| A2 Numbering from cold (claim path) | **PASS** | After `reset_order` (table cleared, node UNASSIGNED) node `c`: `CLAIM sent` → `UNASSIGNED -> DISCOVER pos=0` → `DISCOVER -> SHOW_POSITION pos=2` (15 ms) → `SHOW_POSITION -> RUNNING pos=2` (+3.0 s); hub `[RADIO] addPeer 78:E3:6D:19:18:38 OK` → `[HUB] ASSIGN 78:E3:6D:19:18:38 -> pos 2 (new) [claim]`. |
| A3 Sticky position | **PASS** | Node reset (twice): `[NODE] NVS pos=2` → `BOOT -> DISCOVER pos=2` → `DISCOVER -> SHOW_POSITION pos=2` (26 ms) → `RUNNING pos=2`; hub `ASSIGN … -> pos 2 (known)`. |
| A5 Reset order + claim | **PASS** | Via HTTP `reset_order` instead of serial `r`: identical logs to step 1 (`RESET ORDER … broadcasting RESETORD x5` / node `RESETORD received` → `UNASSIGNED pos=0`), node `c` → pos 2 (new) [claim]. |
| A4 (incidental) | PASS | Hub reset in B6: node `RUNNING -> LOST_HUB` → `LOST_HUB -> RUNNING` 1.7 s later, no re-ASSIGN. |
| A6 (incidental) | PASS | Serial `s` output format intact plus new `text=… color=… bri=100/100 fx=… speed=… boards=…` line and `web clients=… requests=…` on the hub; node `s` gained `hubOffset=…` and a `show: color=… bri=… fx=… period=… numBoards=…` line. |

### Timings

- POST `/cmd` (box) → hub `[WEB]`/`[SHOW]` log: ≈ 50 ms; → node `[NODE] apply`: **≈ 76 ms**; → node `render`: ≈ 86 ms (msg "OK", 23:33:51.017 → 51.093 → 51.103). Other commands: 60–75 ms POST→apply (hub `[SHOW]` → node `apply` consistently 12–26 ms).
- `GET /state` round trip: ≈ 21 ms (`curl time_total`), 499 B body.
- Auto-save: `[HUB] sign saved` exactly 2.0 s after the last applied change (e.g. 23:33:51.067 SHOW → 23:33:53.067 saved).
- Hub boot to `[WEB] listening`: 5.2 s from reset (3 s role window included); node `RUNNING` 9.2 s after reset.
- Offline detection: `online:false` at `age=10`; re-online ≈ 4 s after the node reaches RUNNING (first HB).

## Anomalies

- **N1 `clients` over-reports by the number of ESP-NOW peers.** `/state.clients` and `w`'s `apClients` read `2` with exactly one station (the box) associated, and **`1` with the box disconnected** (`wpa_cli disconnect`, 6 s later `w`: `apClients=1`; reconnect → `2`). `WiFi.softAPgetStationNum()` → `esp_wifi_ap_get_sta_list()` includes ESP-NOW peers registered on the AP interface (the node `78:E3:6D:19:18:38`). Cosmetic in the UI ("clients" badge), but it also means the hub's `max_conn=2` may need checking with two phones at once (not tested here — see phone checklist).
- **N2 Unicast IDENTIFY intermittently lost** — see D1.
- **N3 One failed `/state` in 150 during the soak** (23:46:49; the Python JSON parser got an empty/truncated body within `curl -m3`). Not reproduced in 250 immediate follow-up polls. Hub `minHeap` reached 160 616 at some point during the soak (vs 165 668 after B9), i.e. a ≈ 5 kB transient dip; cannot be tied to the failed request from the logs. Possibly a Wi-Fi retry on the box side. Worth a longer soak with per-request status logging before Phase 2.
- **N4 `briEff` formula.** Implementation uses `briEff = bri × cap / 100` (review disposition S3-22), not `min(bri, cap)` as written in the review's R1 sketch. Visible in B4: white at `bri 50` → `briEff 30` (min() would give 50). Both give the brief's 60 at `bri 100`. Deterministic and arguably the more sensible curve; documented, not a defect.
- **N5 `/state` shape extras**: `state.hubState` and `self:false` on non-self rows (§4 has neither). Harmless for the page.
- **N6 Hub reboot while the page is open**: after the hub reset in B6 the hub logged `[WEB] GET /chrome-variations/seed -> 302 /` — a background process on the box hit the portal because its DNS was hijacked (see Environment). Not a firmware issue, but a reminder that the captive DNS answers *every* name, so a phone that stays associated will see every app's traffic redirected to the sign.
- **N7 `arduino-cli upload` unusable on this box** (baud switch fails); esptool at 115200 works. Record for the owner's Windows setup: if the same adapters are used, set `UploadSpeed=115200`.
- **N8 `wlp4s0` is 60 GHz** (wil6210); the brief's instruction to use it cannot work. Use `wlp3s0`.

## Defects for fix agent

**D1 — Unicast IDENTIFY (and therefore FORGET) is fire-and-forget; 2 of 11 identifies never reached the node.**
- Where: `hub.cpp:321` `radio::send(mac, &id, sizeof(id), false);` in `identifyPos()`; `forgetPos()` sends FORGET the same way (one attempt, `needsAck=false`). `radio::send` with `needsAck=false` frees the slot after a single `esp_now_send` (and on immediate failure, `radio_espnow.cpp:244-251`, counts `txFail` and drops it).
- Repro: with the node RUNNING at pos 2, `curl -s -X POST http://192.168.4.1/cmd -d '{"cmd":"identify","pos":2,"ms":800}'` repeatedly with 2 s gaps while capturing node serial. Observed: hub always logs `[HUB] IDENTIFY pos 2 (…) 800 ms`, reply `ok:true`; node logged `[NODE] IDENTIFY 800 ms` for 9 of 11; the misses were the first command of a batch at 23:37:44.6 and 23:38:45.2 (hub `txFail` 0 → 1 over the session, so at least one loss was over-the-air rather than an `esp_now_send` error). Broadcast (`pos 255`) never missed.
- Impact: Identify is cosmetic, but a lost **FORGET** leaves the node with its NVS position while the hub has dropped the row; on the node's next boot it re-HELLOs with that pos and the hub re-accepts it — the forget is silently undone (exactly the case S3-25 warned about).
- Suggested fix: send IDENTIFY and FORGET with `needsAck=true` (the ACK/retry path already exists for ASSIGN), or at minimum repeat FORGET ×3 like RESETORD. Verify with the repro above (expect 20/20) and with `forget` → power-cycle node → node must boot `NVS pos=0`.

**D2 — `clients` counts ESP-NOW peers (N1).** `hub::buildState` (`hub.cpp:389`) and `transport_web::apClients()` use `WiFi.softAPgetStationNum()`. Suggested: filter `esp_wifi_ap_get_sta_list()` entries against the hub table MACs (or count only entries with a DHCP lease via `tcpip_adapter`/`esp_netif` station list), and report `clients = stations − peers_in_table`. Repro: one box associated → `/state.clients` is 2; disconnect it → `w` shows `apClients=1`.

No blocking defects: B1–B10 all pass on the hardware; D1 is the only behavioural issue and it is a reliability gap, not a functional failure.

## Phone checklist for the owner (cannot be automated)

Power both boards (hub shows `H`, node `I`, green). Join Wi-Fi **LEDSIGN-HUB / sign1234**.

**iOS (Safari captive-portal sheet)**
1. After joining, the "Log In" captive sheet should pop within ~5 s showing the sign page (dark theme, four tabs). If it does not, open Safari → `http://192.168.4.1/`.
2. Message tab: type `HI {heart}` using the keypad for the heart; char-count reads `3 / 2` in red (over by one); Send → boards show `H`, heart; textarea keeps your text after the next poll.
3. Look tab: tap red swatch → both boards red within ~0.1 s; brightness slider to 50 → label `50%`; white swatch → label shows `(effective 30%)`; slider to 100 → `(effective 60%)`; rainbow swatch → hues cycle on both boards **in step**; Blink → both boards blink **in phase** at 500 ms; speed slider 2000 → slow blink; Static.
4. Boards tab: two cards, pos 1 badge `HUB`, pos 2 online with RSSI/age; tap Identify on pos 2 → node flashes (if it does not, tap again — see D1); Identify all → both; power off the node → card goes offline within 10 s and a **Forget** button appears; Reset order → confirm dialog → pos 2 card disappears; press the node's claim key / `c` → card returns.
5. Settings tab: SSID `LEDSIGN-HUB`, fw 1, heap ≈ 175 kB, clients (expect 2 with one phone — N1), uptime ticking; console `{"cmd":"get"}` → reply log shows the JSON.
6. Leave the sheet open 2 min: no "cannot connect" errors, page keeps polling. Then tap "Done" and reopen from Safari — page loads (not cached stale: `no-store`).

**Android (Chrome, "Sign in to network" notification)**
1. Join → notification "Sign in to LEDSIGN-HUB" within ~10 s → tap → the page opens in the captive webview. Fallback: Chrome → `http://192.168.4.1/`.
2. Repeat items 2–5 above. Specifically check: symbol keypad glyphs render (`:)`, `:(` not emoji), sliders respond to touch without the 300 ms delay, `<input type=color>` opens the system picker and applies on close, `confirm()` dialogs work inside the webview, toast appears on an error (type `{"cmd":"bogus"}` in the console).
3. Keep the phone associated for 5 min with the page in the foreground — page must keep updating and the phone's other apps must *not* think it has internet (expected: Android shows "no internet" and may ask to stay connected — say yes).
4. **Two phones at once** (max_conn = 2, but N1 means the AP may think one slot is taken): confirm the second phone can associate and load the page; note the result for D2.

## Final state

Both boards left running: hub `text="HI" color=00FF00 bri=100/100 fx=static speed=500 boards=0`, node `pos=2 state=RUNNING … show: color=00FF00 bri=100 fx=0`, `/state` → `HI 00FF00 100 [(1,True,'H'),(2,True,'I')]`, `[HUB] sign saved` confirmed. Raw logs on the box under `~/v3/` (`hub_boot1.log`, `node_boot1.log`, `hub_b4.log`, `node_b4.log`, `b5_poll.log`, `node_b5.log`, `hub_b6.log`, `node_b6.log`, `hub_b7.log`, `node_b7.log`, `node_b9.log`, `hub_s_before_b9.log`, `hub_s_after_b9.log`, `b9_load_result.txt`, `b10_poll.log`, `hub_b10.log`, `node_b10.log`).

## D1 fix verification (commit 49e4927, 2026-11-08)
Unicast IDENTIFY and FORGET now use the ACK/retry path (`needsAck=true`); node ACKs both (and ACKs FORGET even when already UNASSIGNED so retries terminate). Re-test after reflashing both boards at 115200:
- `tools/test_identify.py /dev/ttyUSB0 /dev/ttyUSB1 15 2` → **15 / 15 received**, hub `txFail=0` (was 9/11 with 1 txFail).
- `forget pos 2` → node `FORGET from hub … UNASSIGNED`; node `c` → DISCOVER → SHOW_POSITION pos=2 → RUNNING. **D1 closed.**
