Alternating/esp32-LED-sign/firmware/LED_Sign_Mesh/character_patterns.h

/*
 * Character Patterns Library - 20x20
 * 20x20 pixel patterns for letters, numbers, and symbols
 *
 * Save this file as: character_patterns.h
 * Place in same folder as your main .ino file
 *
 * Each pattern is a const bool[400], row-major: index = row*20 + col,
 * row 0 = top, col 0 = left (the sketch mirrors columns for its wiring).
 * 1 = LED on.  Every array below is exactly 400 entries.
 *
 * getCharacterPattern(char) lookup table
 * ---------------------------------------------------------------
 *  Control codes (symbol buttons / Symbol Edition web UI)
 *    1  PATTERN_HEART         6  PATTERN_ARROW_LEFT
 *    2  PATTERN_STAR          7  PATTERN_ARROW_UP
 *    3  PATTERN_CHECK         8  PATTERN_ARROW_DOWN
 *    4  PATTERN_CROSS         9  PATTERN_DIAMOND
 *    5  PATTERN_ARROW_RIGHT  10  PATTERN_CIRCLE
 *   13  PATTERN_HAPPY  :)    14  PATTERN_SAD  :(
 *   15  PATTERN_TEN    "10" (board position 10)
 *
 *  Letters   A-Z (a-z are folded to upper case)     PATTERN_A .. PATTERN_Z
 *  Digits    0-9                                    PATTERN_0 .. PATTERN_9
 *
 *  ASCII punctuation
 *    ' '  PATTERN_SPACE       '?'  PATTERN_QUESTION    '!'  PATTERN_EXCLAIM
 *    '.'  PATTERN_PERIOD      ','  PATTERN_COMMA       ':'  PATTERN_COLON
 *    '\'' PATTERN_APOSTROPHE  '"'  PATTERN_QUOTE       '-'  PATTERN_MINUS
 *    '+'  PATTERN_PLUS        '='  PATTERN_EQUALS      '/'  PATTERN_SLASH
 *    '('  PATTERN_PAREN_L     ')'  PATTERN_PAREN_R     '#'  PATTERN_HASH
 *    '$'  PATTERN_DOLLAR      '&'  PATTERN_AMPERSAND   '@'  PATTERN_AT
 *    '%'  PATTERN_PERCENT
 *
 *  ASCII aliases for symbols (legacy, unchanged)
 *    '*' PATTERN_STAR   '>' PATTERN_ARROW_RIGHT   '<' PATTERN_ARROW_LEFT
 *    '^' PATTERN_ARROW_UP
 *
 *  Anything else returns PATTERN_SPACE (blank board), never nullptr.
 *
 * RAM: each pattern is 400 bytes (const bool, not PROGMEM).
 */

#ifndef CHARACTER_PATTERNS_20X20_H
#define CHARACTER_PATTERNS_20X20_H

// Letters
const bool PATTERN_A[400] = {
  0,0,0,0,0,0,1,1,1,1,
  1,1,1,1,0,0,0,0,0,0,
  0,0,0,0,0,0,1,1,1,1,
  1,1,1,1,0,0,0,0,0,0,
  0,0,0,0,1,1,1,1,1,1,
  1,1,1,1,1,1,0,0,0,0,
  0,0,0,0,1,1,1,1,1,1,
  1,1,1,1,1,1,0,0,0,0,
  0,0,1,1,1,1,1,1,0,0,
  0,0,1,1,1,1,1,1,0,0,
  0,0,1,1,1,1,1,1,0,0,
  0,0,1,1,1,1,1,1,0,0,
  0,0,1,1,1,1,0,0,0,0,
  0,0,0,0,1,1,1,1,0,0,
  0,0,1,1,1,1,0,0,0,0,
  0,0,0,0,1,1,1,1,0,0,
  1,1,1,1,1,1,0,0,0,0,
  0,0,0,0,1,1,1,1,1,1,
  1,1,1,1,1,1,0,0,0,0,
  0,0,0,0,1,1,1,1,1,1,
  1,1,1,1,1,1,1,1,1,1,
  1,1,1,1,1,1,1,1,1,1,
  1,1,1,1,1,1,1,1,1,1,
  1,1,1,1,1,1,1,1,1,1,
  1,1,1,1,1,1,1,1,1,1,
  1,1,1,1,1,1,1,1,1,1,
  1,1,1,1,1,1,1,1,1,1,
  1,1,1,1,1,1,1,1,1,1,
  1,1,1,1,1,1,0,0,0,0,
  0,0,0,0,1,1,1,1,1,1,
  1,1,1,1,1,1,0,0,0,0,
  0,0,0,0,1,1,1,1,1,1,
  1,1,1,1,1,1,0,0,0,0,
  0,0,0,0,1,1,1,1,1,1,
  1,1,1,1,1,1,0,0,0,0,
  0,0,0,0,1,1,1,1,1,1,
  1,1,1,1,1,1,0,0,0,0,
  0,0,0,0,1,1,1,1,1,1,
  1,1,1,1,1,1,0,0,0,0,
  0,0,0,0,1,1,1,1,1,1
};

const bool PATTERN_B[400] = {
  1,1,1,1,1,1,1,1,1,1,
  1,1,1,1,1,1,0,0,0,0,
  1,1,1,1,1,1,1,1,1,1,
  1,1,1,1,1,1,0,0,0,0,
  1,1,1,1,1,1,1,1,1,1,
  1,1,1,1,1,1,1,1,0,0,
  1,1,1,1,1,1,1,1,1,1,
  1,1,1,1,1,1,1,1,0,0,
  1,1,1,1,1,1,0,0,0,0,
  0,0,0,0,1,1,1,1,1,1,
  1,1,1,1,1,1,0,0,0,0,
  0,0,0,0,1,1,1,1,1,1,
  1,1,1,1,1,1,0,0,0,0,
  0,0,0,0,1,1,1,1,0,0,
  1,1,1,1,1,1,0,0,0,0,
  0,0,0,0,1,1,1,1,0,0,
  1,1,1,1,1,1,1,1,1,1,
  1,1,1,1,1,1,0,0,0,0,
  1,1,1,1,1,1,1,1,1,1,
  1,1,1,1,1,1,0,0,0,0,
  1,1,1,1,1,1,1,1,1,1,
  1,1,1,1,1,1,0,0,0,0,
  1,1,1,1,1,1,1,1,1,1,
  1,1,1,1,1,1,0,0,0,0,
  1,1,1,1,1,1,0,0,0,0,
  0,0,0,0,1,1,1,1,0,0,
  1,1,1,1,1,1,0,0,0,0,
  0,0,0,0,1,1,1,1,0,0,
  1,1,1,1,1,1,0,0,0,0,
  0,0,0,0,1,1,1,1,1,1,
  1,1,1,1,1,1,0,0,0,0,
  0,0,0,0,1,1,1,1,1,1,
  1,1,1,1,1,1,1,1,1,1,
  1,1,1,1,1,1,1,1,0,0,
  1,1,1,1,1,1,1,1,1,1,
  1,1,1,1,1,1,1,1,0,0,
  1,1,1,1,1,1,1,1,1,1,
  1,1,1,1,1,1,0,0,0,0,
  1,1,1,1,1,1,1,1,1,1,
  1,1,1,1,1,1,0,0,0,0
};

const bool PATTERN_C[400] = {
  0,0,0,0,1,1,1,1,1,1,
  1,1,1,1,1,1,0,0,0,0,
  0,0,0,0,1,1,1,1,1,1,
  1,1,1,1,1,1,0,0,0,0,
  0,0,1,1,1,1,1,1,1,1,
  1,1,1,1,1,1,1,1,0,0,
  0,0,1,1,1,1,1,1,1,1,
  1,1,1,1,1,1,1,1,0,0,
  1,1,1,1,1,1,1,1,0,0,
  0,0,0,0,1,1,1,1,1,1,
  1,1,1,1,1,1,1,1,0,0,
  0,0,0,0,1,1,1,1,1,1,
  1,1,1,1,1,1,0,0,0,0,
  0,0,0,0,0,0,0,0,0,0,
  1,1,1,1,1,1,0,0,0,0,
  0,0,0,0,0,0,0,0,0,0,
  1,1,1,1,1,1,0,0,0,0,
  0,0,0,0,0,0,0,0,0,0,
  1,1,1,1,1,1,0,0,0,0,
  0,0,0,0,0,0,0,0,0,0,
  1,1,1,1,1,1,0,0,0,0,
  0,0,0,0,0,0,0,0,0,0,
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
  0,1,1,1,0,1,1,0,0,0,0,0,0,1,1,0,1,1,1,0,
  0,0,1,1,1,0,0,0,0,0,0,0,0,0,0,1,1,1,0,0,
  0,0,0,1,1,1,1,0,0,0,0,0,0,1,1,1,1,0,0,0,
  0,0,0,0,1,1,1,1,1,1,1,1,1,1,1,1,0,0,0,0,
  0,0,0,0,0,1,1,1,1,1,1,1,1,1,1,0,0,0,0,0,
  0,0,0,0,0,0,0,0,1,1,1,1,0,0,0,0,0,0,0,0
};

// code 15  "10"
const bool PATTERN_TEN[400] = {
  0,0,0,0,1,1,1,0,0,0,0,0,0,1,1,1,1,0,0,0,
  0,0,0,1,1,1,1,0,0,0,0,0,1,1,1,1,1,1,0,0,
  0,1,1,1,1,1,1,0,0,0,0,1,1,1,1,1,1,1,1,0,
  0,1,1,1,1,1,1,0,0,0,0,1,1,1,0,0,1,1,1,0,
  0,0,0,0,1,1,1,0,0,0,0,1,1,1,0,0,1,1,1,0,
  0,0,0,0,1,1,1,0,0,0,0,1,1,1,0,0,1,1,1,0,
  0,0,0,0,1,1,1,0,0,0,0,1,1,1,0,0,1,1,1,0,
  0,0,0,0,1,1,1,0,0,0,0,1,1,1,0,0,1,1,1,0,
  0,0,0,0,1,1,1,0,0,0,0,1,1,1,0,0,1,1,1,0,
  0,0,0,0,1,1,1,0,0,0,0,1,1,1,0,0,1,1,1,0,
  0,0,0,0,1,1,1,0,0,0,0,1,1,1,0,0,1,1,1,0,
  0,0,0,0,1,1,1,0,0,0,0,1,1,1,0,0,1,1,1,0,
  0,0,0,0,1,1,1,0,0,0,0,1,1,1,0,0,1,1,1,0,
  0,0,0,0,1,1,1,0,0,0,0,1,1,1,0,0,1,1,1,0,
  0,0,0,0,1,1,1,0,0,0,0,1,1,1,0,0,1,1,1,0,
  0,0,0,0,1,1,1,0,0,0,0,1,1,1,0,0,1,1,1,0,
  0,0,0,0,1,1,1,0,0,0,0,1,1,1,0,0,1,1,1,0,
  0,1,1,1,1,1,1,1,1,0,0,1,1,1,1,1,1,1,1,0,
  0,1,1,1,1,1,1,1,1,0,0,0,1,1,1,1,1,1,0,0,
  0,1,1,1,1,1,1,1,1,0,0,0,0,1,1,1,1,0,0,0
};

// Function to get character pattern
const bool* getCharacterPattern(char c) {
  // Handle special symbol codes (1-10, 13-15)
  switch((uint8_t)c) {
    case 1: return PATTERN_HEART;
    case 2: return PATTERN_STAR;
    case 3: return PATTERN_CHECK;
    case 4: return PATTERN_CROSS;
    case 5: return PATTERN_ARROW_RIGHT;
    case 6: return PATTERN_ARROW_LEFT;
    case 7: return PATTERN_ARROW_UP;
    case 8: return PATTERN_ARROW_DOWN;
    case 9: return PATTERN_DIAMOND;
    case 10: return PATTERN_CIRCLE;
    case 13: return PATTERN_HAPPY;
    case 14: return PATTERN_SAD;
    case 15: return PATTERN_TEN;
  }

  // Convert to uppercase for letters
  if (c >= 'a' && c <= 'z') {
    c = c - 32; // Convert to uppercase
  }

  // Letters A-Z
  if (c >= 'A' && c <= 'Z') {
    switch(c) {
      case 'A': return PATTERN_A;
      case 'B': return PATTERN_B;
      case 'C': return PATTERN_C;
      case 'D': return PATTERN_D;
      case 'E': return PATTERN_E;
      case 'F': return PATTERN_F;
      case 'G': return PATTERN_G;
      case 'H': return PATTERN_H;
      case 'I': return PATTERN_I;
      case 'J': return PATTERN_J;
      case 'K': return PATTERN_K;
      case 'L': return PATTERN_L;
      case 'M': return PATTERN_M;
      case 'N': return PATTERN_N;
      case 'O': return PATTERN_O;
      case 'P': return PATTERN_P;
      case 'Q': return PATTERN_Q;
      case 'R': return PATTERN_R;
      case 'S': return PATTERN_S;
      case 'T': return PATTERN_T;
      case 'U': return PATTERN_U;
      case 'V': return PATTERN_V;
      case 'W': return PATTERN_W;
      case 'X': return PATTERN_X;
      case 'Y': return PATTERN_Y;
      case 'Z': return PATTERN_Z;
    }
  }

  // Numbers 0-9
  if (c >= '0' && c <= '9') {
    switch(c) {
      case '0': return PATTERN_0;
      case '1': return PATTERN_1;
      case '2': return PATTERN_2;
      case '3': return PATTERN_3;
      case '4': return PATTERN_4;
      case '5': return PATTERN_5;
      case '6': return PATTERN_6;
      case '7': return PATTERN_7;
      case '8': return PATTERN_8;
      case '9': return PATTERN_9;
    }
  }

  // ASCII punctuation
  switch(c) {
    case '?': return PATTERN_QUESTION;
    case '!': return PATTERN_EXCLAIM;
    case '.': return PATTERN_PERIOD;
    case ',': return PATTERN_COMMA;
    case ':': return PATTERN_COLON;
    case '\'': return PATTERN_APOSTROPHE;
    case '"': return PATTERN_QUOTE;
    case '-': return PATTERN_MINUS;
    case '+': return PATTERN_PLUS;
    case '=': return PATTERN_EQUALS;
    case '/': return PATTERN_SLASH;
    case '(': return PATTERN_PAREN_L;
    case ')': return PATTERN_PAREN_R;
    case '#': return PATTERN_HASH;
    case '$': return PATTERN_DOLLAR;
    case '&': return PATTERN_AMPERSAND;
    case '@': return PATTERN_AT;
    case '%': return PATTERN_PERCENT;
  }

  // Special ASCII symbols (legacy aliases, unchanged)
  if (c == ' ') return PATTERN_SPACE;
  if (c == '*') return PATTERN_STAR;
  if (c == '>') return PATTERN_ARROW_RIGHT;
  if (c == '<') return PATTERN_ARROW_LEFT;
  if (c == '^') return PATTERN_ARROW_UP;
  // NOTE: the original also had `if (c == 'v') return PATTERN_ARROW_DOWN;`
  // which was unreachable ('v' is folded to 'V' above). Dropped as dead code;
  // behaviour is identical. Use code 8 for the down arrow.

  // Default: return space if character not found
  return PATTERN_SPACE;
}

#endif // CHARACTER_PATTERNS_20X20_H
