Alternating/esp32-LED-sign/firmware/LED_Sign_Mesh/storage.cpp

#include "storage.h"
#include <Preferences.h>
#include <string.h>

namespace storage {

static const char* NS_SYS  = "sys";
static const char* NS_TBL  = "tbl";
static const char* NS_NODE = "node";
static const char* NS_SIGN = "sign";

// All namespaces are opened read-write (begin(ns, false)): a read-only open of a
// namespace that does not exist yet fails, and puts on a read-only handle are no-ops.

void begin() {
  Preferences p;
  p.begin(NS_SYS, false); p.end();     // make sure the namespace exists
}

Role loadRole() {
  Preferences p; p.begin(NS_SYS, false);
  uint8_t r = p.getUChar("role", (uint8_t)Role::NODE);
  p.end();
  return r == (uint8_t)Role::HUB ? Role::HUB : Role::NODE;
}

void saveRole(Role role) {
  Preferences p; p.begin(NS_SYS, false);
  p.putUChar("role", (uint8_t)role);
  p.end();
}

bool loadMirror() {
  Preferences p; p.begin(NS_SYS, false);
  bool m = p.getBool("mirror", false);
  p.end();
  return m;
}

void saveMirror(bool mirror) {
  Preferences p; p.begin(NS_SYS, false);
  p.putBool("mirror", mirror);
  p.end();
}

uint8_t loadTransport() {
  Preferences p; p.begin(NS_SYS, false);
  uint8_t t = p.getUChar("transport", 0);
  p.end();
  return t;
}

void saveTransport(uint8_t transport) {
  Preferences p; p.begin(NS_SYS, false);
  p.putUChar("transport", transport);
  p.end();
}

void loadTable(TableEntry* entries, uint8_t& nextPos) {
  const size_t want = sizeof(TableEntry) * MAX_BOARDS;
  memset(entries, 0, want);
  Preferences p; p.begin(NS_TBL, false);
  size_t got = p.getBytesLength("table");
  if (got == want) p.getBytes("table", entries, want);
  else if (got != 0) Serial.printf("[STORAGE] table blob size %u != %u, ignoring\n", (unsigned)got, (unsigned)want);
  nextPos = p.getUChar("nextPos", 2);
  p.end();
  if (nextPos < 2) nextPos = 2;
}

void saveTable(const TableEntry* entries, uint8_t nextPos) {
  Preferences p; p.begin(NS_TBL, false);
  p.putBytes("table", entries, sizeof(TableEntry) * MAX_BOARDS);
  p.putUChar("nextPos", nextPos);
  p.end();
}

void clearTable() {
  Preferences p; p.begin(NS_TBL, false);
  p.clear();
  p.end();
}

uint8_t loadNodePos() {
  Preferences p; p.begin(NS_NODE, false);
  uint8_t pos = p.getUChar("pos", 0);
  p.end();
  return pos <= MAX_BOARDS ? pos : 0;
}

void saveNodePos(uint8_t pos) {
  Preferences p; p.begin(NS_NODE, false);
  p.putUChar("pos", pos);
  p.end();
}

// Step-3 blob layout, frozen. Never change this struct: it is what a v1 board has in flash.
struct SignStateV1 {
  char     text[61];               // literal: frozen, independent of SIGN_TEXT_MAX
  uint8_t  r, g, b;
  bool     rainbow;
  uint8_t  bri;
  uint8_t  effect;
  uint16_t effectPeriodMs;
  uint8_t  boards;
};
static_assert(sizeof(SignStateV1) == 72, "frozen v1 layout");

// Step-2 blob layout, frozen (text capped at 60 raw bytes). What every board had in flash before v3.
struct SignStateV2 {
  char     text[61];
  uint8_t  r, g, b;
  bool     rainbow;
  uint8_t  bri;
  uint8_t  effect;
  uint16_t effectPeriodMs;
  uint8_t  boards;
  uint16_t wordPeriodMs;
  uint8_t  mode;
};
static_assert(sizeof(SignStateV2) == 76, "frozen v2 layout");
static_assert(sizeof(SignState) == 218, "v5 layout (see sign_state.h)");
static constexpr size_t SIGN_V34_SIZE = 216;   // v3/v4 blob payload: SignState up to and including `bands`

static void clampSign(SignState& s) {
  s.text[SIGN_TEXT_MAX] = 0;
  if (s.bri > 100) s.bri = 100;
  if (s.effect > FX_CYCLE) s.effect = FX_STATIC;
  if (s.effectPeriodMs < 100 || s.effectPeriodMs > 2000) s.effectPeriodMs = 500;
  if (s.boards > MAX_BOARDS) s.boards = 0;
  s.rainbow = (s.effect == FX_CYCLE);
  if (s.wordPeriodMs < 500 || s.wordPeriodMs > 10000) s.wordPeriodMs = 2000;
  if (s.mode > SEQ_RAW) s.mode = SEQ_WORDS;
  if (s.bands > 1 || s.rainbow) s.bands = 0;
  if (s.flow > FLOW_DIAG || !s.bands) s.flow = FLOW_OFF;
}

bool loadSign(SignState& s) {
  uint8_t buf[1 + sizeof(SignState)] = {0};
  Preferences p; p.begin(NS_SIGN, false);
  size_t stored = p.getBytesLength("sign");
  size_t got = stored;
  if (got == 0 || got > sizeof(buf) || p.getBytes("sign", buf, got) != got) got = 0;
  p.end();
  bool migrated = false;
  if (got == 1 + sizeof(SignState) && buf[0] == SIGN_BLOB_VER) {
    memcpy(&s, buf + 1, sizeof(SignState));
  } else if (got == 1 + SIGN_V34_SIZE && (buf[0] == 3 || buf[0] == 4)) {   // v3/v4: prefix of v5
    s = SIGN_DEFAULT;
    memcpy(&s, buf + 1, SIGN_V34_SIZE);
    if (buf[0] == 3) s.bands = 0;                       // v3: `bands` byte was padding
    s.flow = FLOW_OFF;
    Serial.printf("[STORAGE] sign blob migrated v%u->v5\n", (unsigned)buf[0]);
    migrated = true;
  } else if (got == 1 + sizeof(SignStateV2) && buf[0] == 2) {
    SignStateV2 v2; memcpy(&v2, buf + 1, sizeof(v2));
    s = SIGN_DEFAULT;
    v2.text[60] = 0; strncpy(s.text, v2.text, SIGN_TEXT_MAX); s.text[SIGN_TEXT_MAX] = 0;
    s.r = v2.r; s.g = v2.g; s.b = v2.b; s.rainbow = v2.rainbow;
    s.bri = v2.bri; s.effect = v2.effect; s.effectPeriodMs = v2.effectPeriodMs; s.boards = v2.boards;
    s.wordPeriodMs = v2.wordPeriodMs; s.mode = v2.mode;
    Serial.println("[STORAGE] sign blob migrated v2->v3 (text limit now 60 display units)");
    migrated = true;
  } else if (got == 1 + sizeof(SignStateV1) && buf[0] == 1) {
    SignStateV1 v1; memcpy(&v1, buf + 1, sizeof(v1));
    s = SIGN_DEFAULT;                                   // new fields: wordPeriodMs 2000, SEQ_WORDS
    v1.text[60] = 0; strncpy(s.text, v1.text, SIGN_TEXT_MAX); s.text[SIGN_TEXT_MAX] = 0;
    s.r = v1.r; s.g = v1.g; s.b = v1.b; s.rainbow = v1.rainbow;
    s.bri = v1.bri; s.effect = v1.effect; s.effectPeriodMs = v1.effectPeriodMs; s.boards = v1.boards;
    migrated = true;
  } else {
    if (stored != 0) Serial.printf("[STORAGE] sign blob size %u ver %u: unknown, using defaults\n", (unsigned)stored, (unsigned)buf[0]);
    s = SIGN_DEFAULT;
    return false;
  }
  clampSign(s);
  return migrated;
}

void saveSign(const SignState& s) {
  uint8_t buf[1 + sizeof(SignState)];
  buf[0] = SIGN_BLOB_VER;
  memcpy(buf + 1, &s, sizeof(SignState));
  Preferences p; p.begin(NS_SIGN, false);
  p.putBytes("sign", buf, sizeof(buf));
  p.end();
}

bool loadSsid(char* out, size_t n, const char* def) {
  out[0] = 0;
  Preferences p; p.begin(NS_SYS, false);
  size_t got = p.getString("ssid", out, n);
  p.end();
  if (got == 0 || out[0] == 0) { strncpy(out, def, n - 1); out[n - 1] = 0; return false; }
  return true;
}

void saveSsid(const char* ssid) {
  Preferences p; p.begin(NS_SYS, false);
  p.putString("ssid", ssid);
  p.end();
}

} // namespace storage
