Alternating/esp32-LED-sign/(commit log)

2026-11-08 Initial scaffold: project plan, research, legacy firmware, extended character font
    - docs/PROJECT_PLAN.md: 10-board ESP-NOW mesh architecture, numbering state machine, protocol, roadmap
    - docs/research/: ESP-NOW feasibility and mobile-app/transport research with sources
    - firmware/legacy/: v4 4-button, WiFi Symbol Edition, LOLIN32 standalone sketches
    - firmware/legacy/character_patterns.h: 47 -> 68 glyphs (punctuation, smiley/frown, '10')
    - tools/fonts/: render/validate/build scripts for the pattern header
    - Progress.md: decisions, open questions, log
    Claude-Session: https://claude.ai/code/session_01VJAZfmxmF2ff7ksehciFCR
    [battery_hanger_-_led_sign_v4.stl]
2026-11-08 bench: font_test sketch — board info + glyph cycle for hardware font verification
    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
2026-11-08 bench: font_test verified on LOLIN32; toolchain notes; FastLED RMT4 removal logged as drift
    - font_test.ino: drop FASTLED_RMT5 0 (hard #error on IDF5/FastLED 3.10), add esp_mac.h
    - firmware/bench/README.md: build/flash/capture commands, partition note, first-run results
    - tools/serial_capture.py: DTR/RTS reset + serial capture helper
    - PROJECT_PLAN.md §5.3 and Progress.md updated with verified versions and drift entry
    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
    [font_test.ino, serial_capture.py]
2026-11-08 bench: espnow_ping — Phase 0 radio test passes (0% loss, 6.5 ms RTT, AP+ESP-NOW on ch 6)
    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
2026-11-08 tools: track ask_local_llm.py
    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
2026-11-08 firmware: LED_Sign_Mesh step 1 refactor (WIP)
2026-11-08 firmware: LED_Sign_Mesh step 1 — radio, protocol, hub/node numbering state machines (compiles, pre-verification)
2026-11-08 docs: step 1 verified — Progress log, pipeline how-to
    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
2026-11-08 firmware: step 3 WIP — printf casts
2026-11-08 firmware: step 3 WIP — raw /cmd body, volatile reset timers, B8 screenshots
    [hub.cpp]
2026-11-08 firmware: step 3 — web transport, captive portal, JSON commands, phone UI, node styling (compiles, pre-verification)
2026-11-08 fix(D1): unicast IDENTIFY/FORGET use the ACK/retry path; node ACKs them
    Verification found 2/11 unicast identifies lost (hub txFail). FORGET without
    ACK could silently undo itself at the node's next boot.
    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
    [hub.cpp, node.cpp]
2026-11-09 fix: identify flashes the board's position digit (plan §3.3), not solid white
    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
    [display.cpp, display.h, hub.cpp, node.cpp]
2026-11-09 docs: step 3 closed — portal auto-pop confirmed by owner
    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
2026-11-09 firmware: step 2 — word sequencer, synchronized word changes, migration v1->v2, UI preview (compiles, pre-verification)
2026-11-09 fix(D1 step2): word period excludes the 300 ms lead; switch instants anchored, no drift
    Verification measured period+300 ms (1000 -> 1312). nextSwitchAt is now the
    switch instant; the burst is sent WORD_LEAD_MS before it and applyAt = nextSwitchAt.
    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
    [hub.cpp]
2026-11-09 docs: step 2 verified, D1 closed — Phase 1 complete; tools/measure_period.py
    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
2026-11-09 tools: flash_board.sh — flash merged image at 115200 and print boot banner
    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
2026-11-09 README: which board is the hub, numbering, role switch, flashing
    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
2026-11-09 feat: remote per-board mirror — 'mirror' command + Flip button, SETMIRROR msg (ACK), K1-at-boot gesture
    Fixes a board whose LED data line enters from the opposite side (board 5 in the
    10-board run showed a mirrored E) without a cable.
    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
    [LED_Sign_Mesh.ino, commands.cpp, hub.cpp, hub.h, node.cpp, protocol.h]
2026-11-09 docs: 10-board run, remote mirror verified, hub flash incident + fixes
    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
2026-11-09 tools: flasher.py — guided hub-then-add-on-boards flasher with verification and roster
    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
2026-11-09 docs: Phase 4 brief — hub-hosted OTA for all boards (min_spiffs, one final wired install)
    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
2026-11-09 firmware: Phase 4 — hub-hosted OTA, built-in rollback, min_spiffs, firmware UI (compiles, pre-verification)
    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
2026-11-09 docs: Phase 4 OTA hardware verification — O1-O10 (O4 blocked by D1: hub loses ESP-NOW peers on reboot)
    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
2026-11-09 fix(D1 phase4): hub re-registers known nodes as ESP-NOW peers at boot and on HB
    After any hub reboot (every hub OTA) unicast to running nodes failed until the
    node itself rebooted: OTA_ENTER, IDENTIFY, SETMIRROR, SETPOS, FORGET. Also log
    immediate esp_now_send failures with the error name.
    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
    [hub.cpp, radio_espnow.cpp]
2026-11-09 tools: ota_rollout.sh — upload to hub + update all boards from the build box
    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
2026-11-10 fix: message limit counts display units ({happy} = 1), not raw bytes
    10 {happy} (70 bytes) were cut at the 60-byte raw cap, splitting the 9th token
    into literal 'HAP'. Now: SIGN_UNITS_MAX 60 display units, SIGN_TEXT_MAX 200 raw
    bytes, signClip() never splits a token, SignState blob v3 (216 B) with v2->v3
    migration, serial JSON line buffer 512 B. tools/seq_test/clip_test.cpp added.
    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
    [LED_Sign_Mesh.ino, commands.cpp, hub.cpp, sequencer.cpp, sign_state.cpp, sign_state.h, storage.cpp]
2026-11-10 fix: frozen SignStateV1 text size must stay literal 61 (was tied to SIGN_TEXT_MAX)
    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
    [storage.cpp]
2026-11-10 fix: hub adopts running nodes from HB after its table is wiped; diag tools
    A hub reinstall wiped the board table; running nodes re-lock onto the hub's
    Show without re-HELLO, so they stayed invisible (no cards, no OTA, no unicast).
    HB carries srcPos: adopt the MAC at that position when it is free.
    ota_rollout.sh: power_save off on the box WLAN, 600 s upload timeout.
    tools/hub_cmd.py (serial JSON to hub), tools/upload_probe.sh (upload + hub log).
    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
    [hub.cpp, hub_cmd.py]
2026-11-10 docs: 10-board OTA rollout, symbol-count fix verified, adoption fix, D4 open; tools/ota_watch.py
    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
    [ota_watch.py]
2026-11-10 docs: first phone-driven UI check via ADB; backlog glyph on board cards
    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
2026-11-10 ui: board cards show the symbol glyph (☺) instead of the token text ({happy})
    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
2026-11-10 docs: glyph fix shipped via phone upload + UI "Update all boards"
    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
2026-11-10 feat: rainbow bands inside the letters (stripes line up across all boards)
    Glyph pixels coloured by row: red/orange/yellow/green/blue/purple top->bottom,
    identical rows on every board so the bands run straight across 1..10.
    color {"bands":true}; FLAG_BANDS bit in the Show header (no frame change);
    SignState v4 (bands in tail padding, v3->v4 migration); cap 80 %;
    blink/fade still apply; exclusive with rainbow cycle. Look tab swatch.
    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
2026-11-10 docs: rainbow bands shipped to all 10 boards via phone
    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
2026-11-10 feat: Rainbow Flow — moving rainbow bands (down/up/right/left/diagonal) across the whole sign
    Bands move in sign-wide coordinates (x0 = (pos-1)*20), phase from the hub clock,
    so right/left/diagonal stripes travel continuously from board 1 to board 10.
    Speed slider: one pixel step every periodMs/5. `flow {"dir":...}` command,
    Show flags bits 4..6 (no frame change), SignState v5 (+flow, v3/v4 migration),
    Look tab Flow row shown when Bands is selected.
    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
2026-11-10 docs: Rainbow Flow shipped to all 10 boards
    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
2026-11-10 docs: 10-board sign photo and video walkthrough link in README and FEATURES
    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
2026-11-10 docs: hardware assembly guide, README status/roadmap, screenshot cleanup
    - docs/HARDWARE_ASSEMBLY.md: per-board build ported from 8board-esp32-ledproject,
    adapted to one LOLIN32 + LiFePO4 + XL4015 per board (GPIO 4 via 470R,
    10000uF, K1-K4), parts with links, matrix serpentine + jumpers, battery
    hanger, flash/test, troubleshooting; 6 build photos in docs/images/hardware/
    - hardware/battery_hanger_-_led_sign_v3.f3d: Fusion source for the hanger
    - README: hardware link, layout, "Status and roadmap" replaces stale Next step
    - FEATURES: font sheet, firmware screenshots side by side, link to assembly
    - HARDWARE_README_v3.md marked legacy
    - tools/phone_shot.sh keeps only the latest shot on t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
    [battery_hanger_-_led_sign_v3.f3d]
2026-11-10 docs: build checklist; 10 m reels, no buttons, LOLIN32 via JST battery input
    - docs/HOWTO_build_a_board.md: one-page build -> flash -> add-to-sign
    checklist, including replacing a dead board (Forget first)
    - HARDWARE_ASSEMBLY: one 10 m reel per board, 4-button board removed,
    LOLIN32 powered through its JST battery connector (polarity, 5.0 V max)
    - README: button-free hub/flip/reset steps, checklist links
    - FEATURES: drop optional button board row
    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
2026-11-10 release: v0.4.0 notes and tools/release_pack.sh
    - tools/release_pack.sh: checks a built release/<commit>/ (checksums,
    version + build id in every image, firmware unchanged since the build,
    HEAD pushed, tag unused), stages dist/v<ver>/ with INSTALL.txt and a zip,
    and publishes the GitHub release with gh (dry run unless --publish)
    - docs/releases/v0.4.0.md: first release notes (build c884749)
    - README: Releases download link; HOWTO_build_pipeline: cutting a release
    - make_images.sh: node update time ~20 s in generated README
    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
